xkarma31-blip/pig-health-monitor/v3-mqtt-pocketbase/firmware/esp32s3-mic-ambient/docs/wiring/esp32s3-devkitc1-pinout.jpg

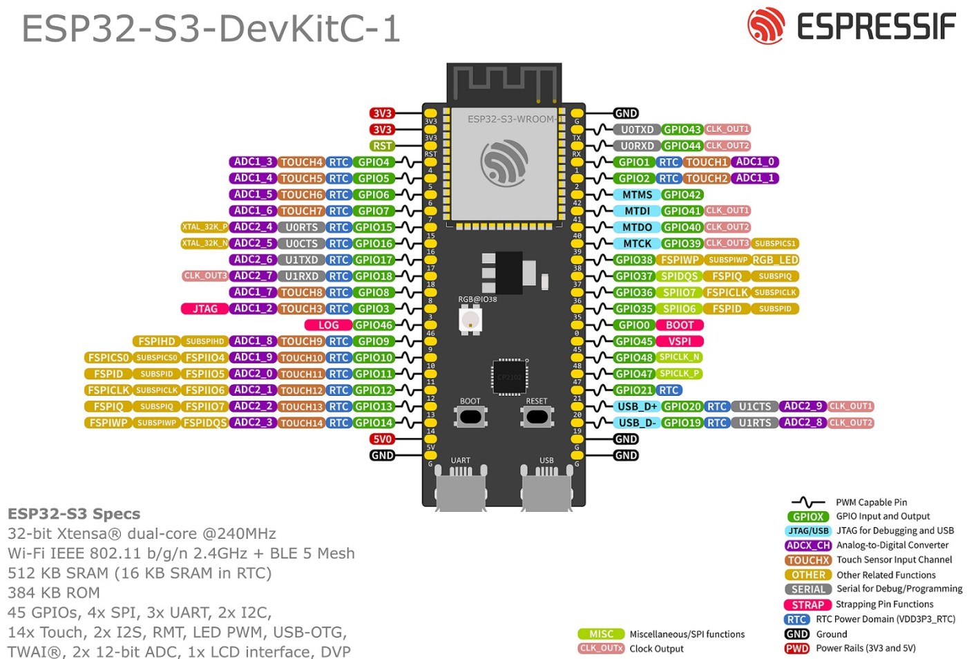
v3-mqtt-pocketbase/firmware/esp32s3-mic-ambient/docs/wiring/esp32s3-devkitc1-pinout.jpg
