xkarma31-blip/pig-health-monitor/v3-mqtt-pocketbase/frontend/landing_page/pigpulse_poster.png

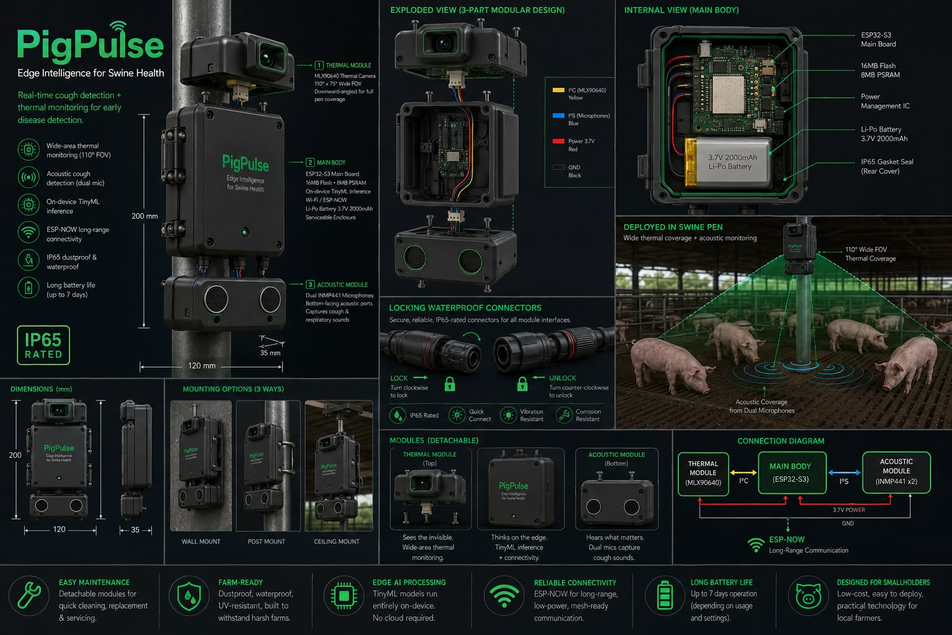
v3-mqtt-pocketbase/frontend/landing_page/pigpulse_poster.png
