xkarma31-blip/pig-health-monitor/v3-mqtt-pocketbase/enclosure/recovery-20261018/revision-o/LUG_DESIGN_DECISION.md

# External lug proposal — not adopted

Independent source-only proposal retained in functional-lug-review.txt.
It proposes152mm-wide main tub with four wall ears,but assumes a requested
wall-attachment requirement absent from the established enclosure brief.
It could not inspect the poster. It is not reference-grounding evidence.

Important constraint remains valid: spine extends5mm behind main tub and SHT
arm extends10mm behind; ears flush to tub/spine would not establish wall contact.
No flat-wall datum,anchor,tool,load or substrate requirement has been supplied.
Adding this geometry now would widen the silhouette without proving functional
mounting or original fidelity. Retain current spine/post strap concept and label
mounting capacity unverified. Do not call SHT support a wall bracket.

This rejects a speculative feature,not a discovered manufacturing defect.
