xkarma31-blip/pig-health-monitor/docs/track-t5-apps.md

# Track T5 — APPS (Home-first app revamp: honest labels, end-user / technician split)

**Track note file** (worker-owned; T0 folds it into `CANON.md`).
**Scope (rollout manifest):** `v3-mqtt-pocketbase/frontend/mobile_app/**`,
`v3-mqtt-pocketbase/backend/thermal-pi/static/**`.
**This change set (2026-11-03):** `frontend/mobile_app/src/**` only.
**Never touched:** firmware, `backend/**` (incl. `thermal-pi/static/`), `CANON.md`, landing page.

> **Status: 2026-11-03 — phase 1 (`9933f46`), phase 2 (`badc7a1`), refinement
> (`6cb7843`) committed; phase 3 (actual sources first + laptop layouts) verified,
> committing with this note.**
> Suites: **62/62** · tsc 0 · eslint 0 · critic_loop pass.
> Not deployed (Vercel login pending); read "Honest limits" before claiming anything
> works on a phone.

---

## 1. Direction reset — this note supersedes the 2026-10-29 T5 brief

The 2026-10-29 rollout brief asked for a **monitor-first** app ("Feeds/Monitor becomes the
primary tab", roster demoted to a hidden research sub-view, anonymous `P-####` IDs).
That direction was implemented as `fd5f5f1` and **reverted by Master in `d660e31`**.
The version of this file that described it was deleted by the revert; it is still
readable as history: `git show fd5f5f1:docs/track-t5-apps.md` (306 lines, superseded).

**Standing direction (what this change set implements):**

| 2026-10-29 brief (superseded) | Standing direction (this change set) |
|---|---|
| Feeds/Monitor becomes the primary tab | **Home stays primary.** No tab restructure. |
| Roster demoted to a hidden research sub-view; anonymous `P-####` | **Roster stays a normal tab** with real pig names; copy says the barn mic monitors the whole pen. |
| Navy/cyan extends over the app | Navy/cyan `#1A1A2E` is the **Pi console** palette, not the app's. App keeps neutral canvas + green accent (`#1E8449` light / `#3DDC84` dark). |
| (implied) monitor surfaces everywhere | **End users must not get admin-like monitoring surfaces.** Technician surfaces (web island: CCTV / thermal diagnostics / serial-only info) are **admin-gated**. |
| — | Consistency + honesty pass: naming restored (saved farm/pen names, PB `devices.name`), simulations labeled as simulations. |

---

## 2. What changed — 9 modified + 1 deleted (all under `mobile_app/src`)

| File | Change |
|---|---|
| `src/components/AuthGuard.tsx` | New `requireAdmin` prop: `allowed = Boolean(user) && (!requireAdmin \|\| Boolean(user?.admin))`. Gate copy: "Admins only" + "This dashboard is for the technician account…" (was "🔒 Authentication Required"). Re-themed via `useTheme()` — dropped the hardcoded navy `#1A1A2E`. Blocked state has **no dead ends**: "← Back to app" always, plus "Admin sign-in" (signed out) / "Sign out & switch account" (signed in, non-admin). |
| `src/app/web/_layout.tsx` | `<AuthGuard>` → `<AuthGuard requireAdmin>` — **the technician island no longer opens for ordinary signed-in users.** |
| `src/app/tabs/index.tsx` (Home) | Farm name from `loadFarmerSetup()` (re-read on focus) instead of hardcoded "Sundown Farm". Device rows labelled via `subscribeDeviceNames` (PB `devices.name` keyed by `deviceId`). Thermal card: "Live thermal feed" → **"Thermal view"** + "Simulated preview of the thermal camera" + always-**"Demo"** badge. Pen label falls back to the saved pen name. |
| `src/app/tabs/roster.tsx` | Demo pill when `!user \|\| user.admin \|\| !liveHerd`. Enroll copy: "Adds this pig to the roster. The barn mic (s3-mic-01) monitors the whole pen…" (no INMP441 near-pig-capture claim). Toast "added to the roster". `enrolled` date reads `record.created` (the real schema field). |
| `src/app/tabs/events.tsx` | Demo pill when `!user \|\| user.admin \|\| !liveEvents`. |
| `src/app/tabs/settings.tsx` | Demo pill when `!user \|\| user.admin \|\| !liveNodes`. Demo nodes relabelled "Thermal node (MLX90640)" / "Barn mic (ESP32-S3)". `mapSensor` shows the PB `label` as-is (no inferred "INMP441/MLX90640" suffixes). Login CTA copy: "Switch from demo data to live events, roster, and sensor readings". |
| `src/app/thermal.tsx` | Removed the dead "Open live Pi dashboard" button (self-signed-cert technician path). Header **"Thermal view"** / "Preview of the thermal camera grid"; keeps the **DEMO SIMULATION** badge. |
| `src/components/ThermalLiveView.tsx` | HUD is now conditional: real frame → sensor HUD; **no frame → "SIMULATED PREVIEW \| RES: 32x24" + "NO SENSOR STREAM — DEMO FRAME"** (was sensor HUD text unconditionally). |
| `src/utils/pocketbase-data.ts` | `enrollPig` writes schema-fitting fields (`pigId`, `name`, `healthStatus`, `tags`; dropped `enrolledAt`). New `subscribeDeviceNames` — `deviceId → devices.name` (refresh is best-effort — see §6.6). |
| `src/components/primitives/TemperatureDisplay.tsx` | **Deleted** — dead component; it carried **all 61 of HEAD's tsc errors** (see §4). |

---

## 3. The split, precisely (who sees what)

**End-user surfaces:** tabs (Home / Events / Roster / Settings), `/thermal`, `/login`.

**Technician surface:** the `/web/**` island (dashboard, nodes, logs…).

- The gate is `user.admin === true`, which only happens when the **PocketBase admin
  endpoint** answered the login (`utils/pocketbase-auth.ts`, login-page role toggle).
  A normal `users` record can never set it — verified in the session matrix (§4).
- **Demo marking matrix** (demo data shown in exactly these states):
  - roster pill: `!user || user.admin || !liveHerd`
  - events pill: `!user || user.admin || !liveEvents`
  - settings pill: `!user || user.admin || !liveNodes`
  - Home: no pill; stale public telemetry is labeled "Stored readings · waiting for
    fresh sensor data" / "Stored data" (pre-existing design), and the thermal card
    always carries the "Demo" badge because the thermal view is always a simulation.

**Before → after evidence (same routes, chromium, real PocketBase):**

| Surface | Before (HEAD `fefeb33` app) | After |
|---|---|---|
| `/web/dashboard` as normal user | Island **rendered** — "Welcome back, demo.farmer! … Herd Health Overview … Add Pig" | **"Admins only"** — island hidden |
| `/web/dashboard` signed out | "🔒 Authentication Required …" | "Admins only" |
| `/web/dashboard` as PB admin | Island rendered | Island rendered (unchanged) |
| Home thermal card | "Live thermal feed" + "Live" badge | **"Thermal view"** + "Demo" badge + "Simulated preview…" |
| Home device rows | raw IDs (`esp32-002`, `s3-mic-01`) | PB names ("Node esp32-001", "Device s3-mic-01", "PigPulse Pi 4B (MLX90640)") |
| Home header | hardcoded "Sundown Farm · …" | saved farm name, or neutral "Connecting to PocketBase…" |

---

## 4. Verification performed (measured 2026-11-03)

| Gate | Result |
|---|---|
| `npx tsc --noEmit` | **0 errors.** HEAD baseline measured in a detached worktree: **61 errors — all 61 in the deleted `TemperatureDisplay.tsx`**. |
| `npx eslint` on the 9 changed files | **0 errors**; 11 warnings, all pre-existing patterns (identical counts at HEAD). |
| `critic_loop.sh` (Article VIII layer 1) | **9/9 PASS.** |
| `npx expo export -p web` | Success (after build and before build both exported). |
| DOM-text assertions (chromium harness) | **41/41** — signed-out 20/20, end-user 15/15, admin 6/6 (incl. the 2 back-affordance checks added after review feedback); 0 page errors, 0 HTTP ≥ 400. |
| Stash round-trip safety | Before-build export taken via `git stash push -- …/mobile_app/src` → export → `git stash pop`; working tree **STATUS MATCHES + TREE MATCHES** byte-for-byte (92 files). Branch HEAD has since advanced (`905a61e`…`64544c0`, thermal-pi + docs only); `mobile_app` is untouched between `fefeb33` and HEAD (verified). |
| Evidence bundle | `~/sandbox/app-revamp-20261103/` — `before/` 22 files, `after/` 32 files (PNGs + DOM text dumps), `compare/` 6 labeled before/after side-by-side PNGs (the Telegram approval pack), `src-after.patch` + full byte-identical `src-backup-20261103-074424/`, harness (`spa_server.py`, `verify_dom.js`, `capture.js`, `probe_before.js`). |

**Harness notes (durable, avoid re-learning):**

- `spa_server.py` serves the Expo web export under `/app` (same baseUrl as production)
  and proxies `/api/*` to PocketBase on `:8090`, including an emulation of the Vercel
  read-only bridge (`api/telemetry.js`) so signed-out/stored-data paths behave like prod.
- A viewport-resize race made early verification runs **falsely fail**: crossing the
  mobile/desktop breakpoint unmounts device rows for ~300 ms–1 s. `dump()` now waits
  for the text to settle (two identical reads); screenshots settle 1600 ms. This was a
  harness bug, not an app bug.
- The `user` session needs a PocketBase *user* account. A temporary one
  (`demo.farmer@pigpulse.local`) was created for the run and **deleted afterwards** —
  users collection is back to 0 items, so re-running that session means recreating it.
- **Review-feedback round (2026-11-03):** back affordances added to the blocked screens
  ("← Back to app" + "Admin sign-in" / "Sign out & switch account"); full re-run after the
  change: tsc 0, eslint 0, re-export, **41/41**, screenshots refreshed.
- Review layers: layer 1 (critic_loop) ran. Layer 2 (CodeRabbit `cr`) could **not**
  run — the CLI is installed but not signed in (`coderabbit auth login` is an
  interactive step). A read-only reviewer-agent pass over the diff ran instead:
  3 MED + 1 LOW, **all pre-existing** — provenance confirmed against `git diff HEAD`
  (none of the flagged lines were touched by this change set); folded into §5/§6.
  The same pass confirmed `enrollPig` matches the migrated `pigs` schema, the gate is
  correct for signed-out/user/admin, `subscribeDeviceNames` keys match telemetry
  keying, and there are no dangling references to the deleted component.

---

## 5. Honest limits (do not oversell)

- **Committed — and revert-verified.** Approved by Master 2026-11-03; committed on
  `feat/v3-mqtt-pocketbase` (hash in `git log`). Revert = `git revert <hash>` (verified
  clean in a scratch worktree) or restore from the evidence bundle (patch + byte-identical
  `src` backup). **Not pushed.**
- No deployment, no APK, no physical-phone run — verification was the web export in
  headless chromium against the local PocketBase.
- DOM assertions check rendered text, not pixels; the PNGs in the evidence bundle are
  the visual record.
- PocketBase telemetry is stale (newest frame 2026-09-27). The "live" surfaces were
  exercised against stored frames; the app labels this honestly ("Stored readings").
- The thermal view remains **always the simulated preview** — no live frame path from
  the Pi is wired to the app today. It is now labeled as a simulation in all three
  places (Home card badge, `/thermal` header, HUD).
- The Pi was unreachable (unplugged) this session — nothing here is Pi-side verified.
- **The admin gate is UI separation, not a security boundary.** `user.admin` is
  rehydrated from localStorage/AsyncStorage and is client-forgeable (only a token
  string is checked — `pocketbase-auth.ts`), and the collections the island reads are
  anon-readable (PB list rules open — spot-checked 200 without auth). Before this
  change the island opened to *any* signed-in user, so the gate is a strict
  improvement, but it must not be described as access control.
- Pre-existing working-tree changes outside this change set were left untouched
  (`docs/REPORT_*.md`, `backend/thermal-pi/static/index.html`,
  `backend/thermal-pi/web_server.py`, untracked docs/tools); the stash round-trip
  proved they were unaffected.

---

## 6. Follow-ups (found during the pass — deliberately NOT fixed here)

1. **`lastSeen` unit mismatch — live settings shows wrong node states.** ESP32 rows
   carry epoch **seconds**, the Pi carries **ms**, `s3-mic-01` carries `0`; the
   devices→sensor mapping (`toLiveSensor`) and `mapSensor` parse as ms, so captured
   live settings rendered esp32-001/002 and the Pi as **"Offline"** and `s3-mic-01`
   as **"Active"** (falsy `0` falls back to "now"). Fix needs per-value normalization
   (`telemetryTime`-style) in `pocketbase-data.ts` / `usePocketbaseRealtime.ts`.
2. **Events timestamps are mixed-unit.** The six seeded demo alerts carry **seconds**
   (`backend/setup/seed_pocketbase.py:134`), the live bridge writes **ms**
   (`local_bridge.py:279`), and `formatTimestamp` treats raw numbers as ms → the
   seeded alerts render "Jan 22" (**1970**, year hidden) instead of Sep 2 — visible
   in `after/v-12-events-user.txt`. One shared normalizer fixes both units.
3. **`batteryPct` / `rssi` / `firmware` unmapped.** Devices rows carry `batteryPct`
   (78/77) but `toLiveSensor` drops it; settings renders battery "—", signal "—",
   version "unknown" for every live node.
4. **`toLiveSensor` defaults non-mic device types to `'thermal'`** — a Pi node will be
   typed as thermal regardless.
5. **`subscribeSensors` ripple.** Two other consumers exist
   (`AdvisorModal.tsx:72`, `useOfflineTelemetry.ts:42`) — revisit together with #1/#3.
6. **Device-name refresh is best-effort (LOW).** Native polls only newly *created*
   records; deployed web depends on the SSE path through the hosting proxy — a rename
   may need a reload. Cosmetic; mirrors the roster/alerts subscriptions.
7. **`src/app/web/nodes.tsx:17` still says "INMP441"** — inside the now-admin-gated
   island (technician-facing), so lower priority; decide whether to correct the label.
8. **Signed-out Home shows stored public bridge telemetry** ("Stored data"). Pre-existing
   design; decide whether end users should see stored readings at all before sign-in.
9. **Push notifications and widgets** — future track, explicitly not in this change set.
10. **Web island numbers are hardcoded mock** — `app/web/dashboard.tsx` builds its pigs
    with `generateMockData()` (Bessie/Daisy/Coco/Lucy, invented temps). The island is a
    legacy technician review surface. Decide: keep it as a clearly-labeled review surface
    or wire real PB data. (Review feedback 2026-11-03.)
11. **Live thermal wiring — ADDRESSED in phase 2** (see the phase-2 track note at the
    bottom): the app now reads `/data` + `/ambient` + `/esp/status` (console tier) and
    falls back to PocketBase `pi-thermal-01` stats. Remaining caveat: native devices may
    reject the console's self-signed certificate, so the phone-on-WiFi path can be
    stats-only until that is solved (Pi HTTP endpoint, cert pinning, or MQTT-over-WS).
12. **Data attribution model (Master's direction, 2026-11-03).** Unsigned sessions may show
    live data but unattributed ("temporary"); signing in should record/classify data to a
    farm/pen. Not implemented today — sign-in is currently view-only.
13. **The island itself has no "back to app" link** (admins navigate via the island's own
    bottom nav). Add one when the island is next touched.

---

## 7. Reproduce

```bash
cd v3-mqtt-pocketbase/frontend/mobile_app

npx tsc --noEmit          # expect 0
npx eslint src/app/tabs/{events,index,roster,settings}.tsx src/app/thermal.tsx \
  src/app/web/_layout.tsx src/components/{AuthGuard,ThermalLiveView}.tsx \
  src/utils/pocketbase-data.ts                      # expect 0 errors

npx expo export -p web --output-dir /tmp/opencode/dist

# serve + verify (harness copies: ~/sandbox/app-revamp-20261103/)
python3 spa_server.py /tmp/opencode/dist 9301      # /api -> PB :8090
node verify_dom.js http://127.0.0.1:9301 /tmp/out signedout
CAP_EMAIL='<temp pb user>' CAP_PASS='<pw>' node verify_dom.js http://127.0.0.1:9301 /tmp/out user
CAP_EMAIL='<pb admin>'     CAP_PASS='<pw>' node verify_dom.js http://127.0.0.1:9301 /tmp/out admin

# before-build comparison (HEAD app state):
git stash push -m before-build -- v3-mqtt-pocketbase/frontend/mobile_app/src
npx expo export -p web --output-dir /tmp/opencode/dist-before
git stash pop
```

Local dev credentials come from `/etc/pigpulse/bridge.env` (never a default).

---

## 8. Canon deltas for T0

- **T5 direction reset (supersedes the 2026-10-29 T5 brief):** Home stays primary;
  app accent stays green; end-user vs technician split — the `/web/**` island is
  gated `requireAdmin` (`user.admin === true` = PB admin login only).
- "Roster deleted / anonymous `P-####`" is **not** the direction; roster stays as a
  normal tab with whole-pen copy, demo-pill logic as in §3.
- The thermal view is **always simulated today** and is now labeled as such in all
  three surfaces (Home card, `/thermal`, HUD).
- `enrollPig` writes schema-conforming `pigs` fields (`pigId`, `name`,
  `healthStatus`, `tags`).
- Home device rows are named from PB `devices.name` keyed by `deviceId`
  (`subscribeDeviceNames`).
- New open items (see §6): `lastSeen` unit mismatch + `s3-mic-01` `lastSeen: 0` falsy →
  wrong node states; events timestamps are mixed-unit (seed **seconds** / bridge **ms**)
  → seeded alerts display 1970 dates until normalized.
- The `requireAdmin` gate is UI separation, not access control (client-side flag;
  collections are anon-readable).
- Live-path facts (2026-11-03): the Pi is reachable at `192.168.69.1` and streams real
  data (PB `:8090`, thermal console `:8080`, MQTT `:1883`, broker WS `:9001`, mic TCP
  `:9090`); the app now wires it in the phase-2 change set (console tier + PB stats
  fallback) — native self-signed-cert caveat remains. The web island's numbers are
  hardcoded mock (§6.10).
- Blocked technician screens must never dead-end: "← Back to app" + sign-in /
  switch-account affordances are part of the gate (AuthGuard).
- Status: **committed** 2026-11-03 (`feat/v3-mqtt-pocketbase`); revert = `git revert <hash>`; not pushed.

---

## Track note 2026-11-03 (phase 2) — live barn thermal, at console quality, in the app theme

> Status: implemented + verified, **UNCOMMITTED** (approval pending). Branch
> `feat/v3-mqtt-pocketbase`, parent commit `9933f46`.

### 1. What changed (6 files: 3 new + 3 edited)

| File | Change |
|---|---|
| `src/utils/pi-thermal.ts` | **New.** Pi console client: types for `/data` (768-pixel frame + stats), `/ambient` (SHT45), `/esp/status` (mic); base resolution = `EXPO_PUBLIC_PI_THERMAL_URL` → saved PB host `https://<host>:8080` → null. |
| `src/utils/thermal-palette.ts` | **New.** Iron colormap — the console's stop set, byte-for-byte — shared by the renderer and legend. |
| `src/hooks/usePiThermal.ts` | **New.** Two-tier data: console endpoints (2 s frame poll / 6 s slow poll, 8 s freshness window) + PocketBase `pi-thermal-01` stats (90 s window — works wherever the app's PB channel works). |
| `src/components/ThermalLiveView.tsx` | New `liveFrame` prop: iron-palette render (web smooth canvas — the console's "Smooth" default; native Svg pixel grid), HOT/COLD crosshair markers at the console's coordinates, live HUD; simulation overlays suppressed in live mode; demo path unchanged. |
| `src/app/thermal.tsx` | Rebuilt around three honest states: **LIVE** (console) / **LIVE STATS** (PB only, frames marked unavailable) / **DEMO SIMULATION**. Quality display: legend bar, stat cards (Center + verdict chip, Min, Max, Avg, MLX ambient), SHT45 barn-ambient card, barn-mic card — all in app theme tokens. |
| `src/app/tabs/index.tsx` | Home thermal card: when `pi-thermal-01` rows are fresh (<90 s) it shows "Live" + `pi-thermal-01 · NN.N°C · live`; otherwise the labeled demo stands. |

### 2. Verification (measured 2026-11-03, Pi live throughout)

| Gate | Result |
|---|---|
| tsc / eslint (changed files) / critic_loop | 0 / 0 errors / **6 PASS** |
| expo web export | OK (regression build + live build) |
| Regression suite (`:9301`, laptop PB, no live env) | **41/41** — demo labeling intact |
| Live suite (`:9303`, live build via `/pi` proxy → real Pi) | **9/9** — LIVE badge, pi-thermal-01, stat labels, HOT/COLD markers, SHT45 card, mic card, plausible temps, no demo label |
| Home suite (`:9304`, PB → Pi) | **3/3** — live subtitle, real Pi device row, not demo |
| Evidence | `~/sandbox/app-revamp-20261103/thermal-live/` (app + home screenshots, dumps); `compare-live/console-vs-app.jpg` (sent to Master's Telegram) |

Sample live read (frame 10364): center 36.91 °C OUT_OF_BAND · min 30.89 (x=30,y=10) ·
max 40.46 (x=12,y=17) · avg 35.53 · MLX ambient 48.88 · SHT45 35.52 °C / 72.5 % RH ·
mic socket open, no data (stale).

### 3. Honest limits (phase 2)

- **Native + self-signed cert:** a phone may not fetch `https://<pi>:8080` directly
  (Android/iOS reject the self-signed cert). The app then shows the **LIVE STATS** tier
  (PocketBase) — real numbers, frames marked unavailable — never a fake live image.
  Fixes to consider: Pi HTTP listener, certificate pinning, or MQTT-over-WS `:9001`.
- Browser fetch of the console also needs the cert accepted; the harness verified the
  full path through a same-origin `/pi` proxy (`spa_server.py`, `PI_TARGET` env).
- The live build bakes `EXPO_PUBLIC_PI_THERMAL_URL`; the regression build does not —
  two dists, no runtime toggle yet (and Metro needs `--clear` when that env changes).
- `/feed` still uses its legacy `thermalFrame`/`esp32-s3-01` path; untouched.

### 4. Canon deltas (phase 2)

- The app now consumes the Pi console contract: `GET /data` (pixels[768] + stats),
  `GET /ambient` (SHT45 temp/humidity/state/age), `GET /esp/status` (mic socket).
- Console base resolution: env override → farmer-saved PB host → none.
- Iron palette stop set mirrored in `src/utils/thermal-palette.ts` — keep in sync with
  the console if the console palette changes.

### 5. Refinement (2026-11-03, same day — after Master's deep-link test)
- **Bug found by Master:** "Back" on `/thermal` did nothing when the screen was opened
  directly (shared URL / fresh tab). Root cause: `router.back()` is a no-op without
  history. Fix: `utils/navigation.ts` → `goBackOrHome()` (back when history exists,
  else `replace('/tabs')`), applied to all **six** `router.back()` sites (`thermal`,
  `feed` ×2, `login`, `tabs/feed`, `tabs/edge-impulse`).
- **Click-level tests added:** `verify_dom.js` session `nav` clicks the real buttons
  and asserts the resulting URL (thermal Back → `/tabs`; "Back to app" → `/tabs`;
  "Admin sign-in" → `/login`). Render-only checks had missed this class of bug.
- **Metro cache gotcha (both directions):** rebuilding a dist after toggling
  `EXPO_PUBLIC_PI_THERMAL_URL` **requires `--clear`** — the transform cache does not
  key on that env var (bit us twice: the live build missed the URL once; the plain
  build later inherited it).
- Removed a dead no-op effect in `tabs/edge-impulse.tsx` (unused `onChange`) — its
  pre-existing lint error surfaced once the file was touched.
- **Battery UI deferred (Master, 2026-11-03):** no battery hardware is fitted — the Pi
  and the ESP32-S3 are port-powered, so node cards now show **Power: Plugged** (was
  "Battery: NN%"). The battery formatting is kept in `settings.tsx` for when hardware ships.
- **Node naming aligned with the real roles:** hardware labels are now
  `Pi 4B — thermal · CCTV · compute` and `ESP32-S3 — mic · ambient` (the old
  "Node A / Node B" labels are gone from the app UI).
- **Live console URL is now baked RELATIVE (`/pi`)** so one dist works everywhere: the
  laptop harness and a phone on the LAN each resolve `/pi` against the origin they
  loaded the app from (`spa_server.py` proxies `/pi` → the Pi console).
- Re-verified after the refinement: **59/59** — 44 regression (incl. 3 new settings
  checks for Power: Plugged + node roles) + 3 nav + 9 live + 3 home.
- A **temporary Vercel deployment** of the plain web build was created for online
  viewing (demo states only — the cloud cannot reach the Pi or the laptop PocketBase;
  a permanent domain deploy needs a `vercel login`).

---

## Track note 2026-11-03 (phase 3) — actual sources first + laptop layouts

> Committed alongside this note; parent: `6cb7843`.

- **Actual data first, everywhere.** Roster / Events / Settings now subscribe to
  PocketBase in EVERY state (reads are anon-open); the local demo constants are only a
  fallback when PB has none — and only then does the DEMO pill show. Admin included
  (the old "admin → mock" branches are gone).
- **Web island dashboard is real:** `generateMockData()` (Bessie/Daisy/Coco/Lucy)
  deleted. The island reads `pigs` + latest `telemetry` from PB: real counts, statuses,
  breed/age from `tags`, real herd average — per-pig temps show "—" because monitoring
  is whole-pen.
- **Events timestamps fixed:** seeds write epoch seconds, the bridge writes ms;
  `formatTimestamp` normalizes via `telemetryTime` (seeded alerts no longer show
  "Jan 22, 1970").
- **PB device names aligned with the real roles** (both laptop + Pi PocketBases):
  `s3-mic-01 → "ESP32-S3 — mic · ambient"`; `pi-thermal-01 → "Pi 4B — thermal · CCTV ·
  compute"` — visible in every device list.
- **Laptop layouts:** thermal view is two-column at desktop widths (canvas left,
  readings right; demo mode centers instead of leaving an empty half). The sidebar +
  grid shell was verified against the previously deployed app at 1440×900 — it matches
  (its `/app/thermal` route is a 404, ours is live).
- Verified: **62/62** suites (24 regression + 16 user + 7 admin + 3 nav + 9 live +
  3 home); desktop screenshots in `~/sandbox/app-revamp-20261103/refinement-shots/`
  (`desktop-live/`, `desktop-regression/`).
- **Deployed to production (2026-11-03):** combined site at
  `https://pig-health-monitor.vercel.app/app` — added SPA fallback rewrites for the
  app's non-tab routes (`/app/thermal`, `/app/login`, `/app/setup`, `/app/feed`,
  `/app/web*`) which were live 404s; deploy scripts now run Vercel from the staging
  dir (the repo-root `vercel.json` carries a `//` note newer schemas reject).
  Autodeploy had been failing since Oct 31 (stale token) — the fresh login restores
  it once the next upstream commit lands.
- Deployed-web nuance: the domain's `/api` only bridges telemetry — device-name
  lookups (`/api/collections/devices`) 404 there, so deployed rows show raw device
  ids until the bridge covers names (follow-up).
- **Deployed LIVE thermal (2026-11-03, evening):** the ONLINE app now streams REAL
  Pi frames — `api/pi.js` (single-path bridge `/api/pi?ep=data|ambient|esp/status`)
  → Tailscale Funnel → laptop `readonly_pb_proxy` (new key-gated `/pi` passthrough,
  endpoint allowlist, unverified TLS to the console) → Pi console. The proxy's
  filter regex also now accepts quoted values (`deviceId='x'`), which had silently
  400'd the deployed stats tier. Production-verified: LIVE badge, HOT/COLD markers,
  SHT45 36.96 °C / 72.5 %, mic socket state — no demo label. Local regression stays
  24/24 (bridge absent → graceful demo fallback).

---

## Track note 2026-11-03 (phase 4) — the Live tab + honest offline states

> Committed alongside this note; parent: `27a4a4a`.

- **Roster tab → Live tab.** Navs (bottom + sidebar) are now Home · Events · **Live** ·
  Settings. The Live tab hosts the shared `LiveThermalPanel` (also used by `/thermal`)
  plus quick links: **Roster →** (kept routable at `/tabs/roster`, no longer a tab,
  with "Back to Live") and **Full screen →** (`/thermal`). A STREAMS note states that
  CCTV isn't wired into the app yet.
- **Honest offline states — the fake heatmap is gone from the app's live surfaces.**
  Four states: **LIVE** (console frames) · **LIVE STATS** (fresh PB) · **LAST KNOWN**
  (stale PB, age-stamped) · **OFFLINE** (no imagery at all; guidance + auto-retry).
  Home's thermal card mirrors this (Live / Stale / Offline badge).
- **Pi-localhost findings (grounded 2026-11-03):** the Pi console is live and directly
  reachable on the barn network (`/`, `/health`, `/data`, `/ambient`, `/esp/status` —
  all 200; a browser on that origin works once the cert is accepted; a cross-origin
  browser fetch is CORS-blocked — verified). Hence the proxy (local harness) and the
  serverless bridge (deployed) are required for non-same-origin hosting. The Pi does
  **not** host the app (`/app` → 404) and SSH was denied with available credentials —
  hosting the app on the Pi (same-origin: no CORS, cert accepted once) is scoped as
  a next step.
- Verified: **69/69** (26 signed-out + 16 user + 7 admin + 5 nav + 12 live + 3 home).
  Deployed: all routes 200 incl. `/app/tabs/live`.

---

## Track note 2026-11-03 (phase 5) — CCTV in the app (separate tile) + per-source sound

> Implemented; parent: `01d464e`.

- **CCTV is real in the app now — as its OWN tile** (no overlay; per Master: "keep both
  separate"). Chain: app → `api/pi?ep=cctv` (deployed) / `/pi/cctv` (local harness) →
  read-only proxy (new `_cctv_frame`: bounded read of the Pi's MJPEG plane, returns the
  freshest complete JPEG; the app polls ≈2.5 s) → Tailscale Funnel → laptop → Pi
  `/cctv`. The tile shows "Live snapshot — updated Ns ago" or an honest offline state.
- **Correction — the Pi's fusion page was never broken.** `/static/fusion.html` returns
  200 and renders a working heat-over-camera overlay **with an alignment panel**
  (opacity / fit / rotation sliders). The earlier "404" note tested the wrong path
  (`/fusion.html`). App-side overlay stays deferred by Master's call; the Pi page
  already demonstrates the approach.
- **Sound controls — the sources are different and kept separate.** SOUND card with
  `Barn mic (ESP32-S3)`: a Listen/Mute toggle playing 3-second WAV chunks from the
  Pi's `/esp/record` (web playback; native lands with the APK pass). While the mic
  stream is stale the Pi returns an honest `503 "ESP mic not connected"` — the toggle
  renders disabled with that reason (verified live). `Camera sound (Tapo)`: a separate
  track, labeled not-wired-yet (needs a barn-side transcoder).
- Proxy allowlists extended: `cctv` (binary JPEG) and `esp/record` (bounded WAV,
  upstream status forwarded). The serverless bridge passes both with correct types.
- Verified: local chain `/pi/cctv` → 200 image/jpeg; `/pi/esp/record` → honest 503;
  suite battery **72/72** (26 + 16 + 7 + 5 + **15** live incl. the new Live-tab checks
  + 3 home); deployed Live tab verified in-browser (CCTV frame rendered, sound card
  present, mic stale-state honest); deployed bridge `/api/pi?ep=cctv` → 200
  image/jpeg.
