xkarma31-blip/pig-health-monitor/docs/PROGRESS_UPDATE_20260913.md

# PigPulse — Weekly Progress Update
> **September 13, 2026** | End of **Gantt Week 7** (Sep 07–13) of 23

---

## 📊 **CURRENT WEEK STATUS**

**Week 7: September 07–13, 2026** | ISO Week 37

| Planned (Gantt Week 7) | Actual Status |
|---|---|
| R7 Ground-Truth Protocol | 🔄 **NOT STARTED** — no deliverable found |
| D2 Synthetic Augmentation | 🔄 **PARTIAL** — simulator v3.1 has env modeling, no standalone D2 module |
| R8 Risk Register (living doc) | 🔄 **ONGOING** — no formal register updated this period |
| D1 Dataset Acquisition | 🔄 **NOT EVIDENT** — no dataset files in repo |
| F2 I2C Thermal Pipeline | ✅ **COMPLETE** — `sensors.cpp/h` with MLX90640 driver |
| F3 Multi-Modal Fusion Engine | ✅ **COMPLETE** — simulator + firmware sensor fusion |
| C2 Ch2 Literature Review | 🔄 **NOT EVIDENT** — no draft in `docs/` |
| C3 Ch3 Methodology | 🔄 **NOT EVIDENT** — no draft in `docs/` |
| A3 CPE Design Journal | 🔄 **NOT EVIDENT** |

**Week 7 Verdict: 🟡 MIXED** — Firmware & simulation far ahead; research deliverables missing.

---

## 🏆 **COMPLETED THIS PERIOD (Since Sep 6)**

### Firmware — `firmware/esp32d0wd-pigpulse/`

| Deliverable | Status | Evidence |
|---|---|---|
| **Complete sensor library** (MLX90640 + INMP441) | ✅ | `sensors.cpp` (20KB), `sensors.h` (4KB) |
| **Power management** (LiPo monitoring, sleep modes) | ✅ | `power.cpp` (3.5KB), `power.h` |
| **WiFi management** (AP/STA, reconnection) | ✅ | `wifi.cpp` (5.5KB), `wifi.h` |
| **Web interface** (config, OTA, status) | ✅ | `web.cpp` (10.6KB), `webpage.h` (19KB) |
| **Config system** (types, persistence) | ✅ | `config.h` (7.5KB), `types.h` |
| **Main firmware entry** | ✅ | `esp32d0wd-pigpulse.ino` (14KB) |
| **PlatformIO build system** | ✅ | `platformio.ini`, partitions, OTA-ready |
| **Test & pinout documentation** | ✅ | `TESTING_GUIDE_TELEGRAM.txt`, `TEST_PINOUT_TELEGRAM.txt` |

### Simulation — `v3-mqtt-pocketbase/` + `canon` branch

| Deliverable | Status | Evidence |
|---|---|---|
| **WebAudio bioacoustics synthesizer** (ADSR cough envelopes, formant model) | ✅ | Task 2 commit, TDD green |
| **32×24 thermal engine** (ear-ROI, base64 encoding) | ✅ | Task 3 commit |
| **Virtual D0WD state machine** (FreeRTOS TWDT, LiPo sag, brownout, beacon storm) | ✅ | Task 4 commit |
| **MQTT WebSocket service** (LWT/retain/reconnect, loopback broker) | ✅ | Task 5 commit |
| **Thermal heatmap canvas** (ironbow colormap, swine arena FOV) | ✅ | Task 6 commit |
| **Bioacoustics studio** (spectrogram waterfall, latency HUD) | ✅ | Task 7 commit |
| **Hardware monitor + chaos panel** (node coverage, RSSI, OTA dialog) | ✅ | Task 8 commit |
| **E2E ingestion contract** (topic routing, status mapping, payload schema) | ✅ | Task 9 commit |
| **Cockpit AI panels** (classifier readout, pipeline trace, scenario runner) | ✅ | Task 10 commit |
| **Grounded world model** (pig-001..004, open-air factors, entropy, contagion) | ✅ | Task 11 commit |
| **Scene editor + env console** | ✅ | Latest commits |
| **Backend inspector** (tri-state liveness vs deployment) | ✅ | Latest commits |
| **Spectral subtraction engine + A/B tests** | ✅ | Latest commits |
| **188/188 tests passing** | ✅ | TDD green throughout |

### Hardware Documentation — `docs/`

| Deliverable | Status | Evidence |
|---|---|---|
| **Breadboard pinout** | ✅ | `pigpulse-breadboard-pinout.png` (208KB) + `.svg` |
| **Pull-up resistor diagram** | ✅ | `pigpulse-pullup-resistors.png` (120KB) + `.svg` |
| **Thermal test pinout** | ✅ | `pigpulse-thermal-test-pinout.png` (77KB) + `.svg` |

### App / Cloud

| Deliverable | Status | Evidence |
|---|---|---|
| **v3 MQTT+PocketBase infra** | ✅ | Mosquitto + ValKey + OpenResty + PocketBase + Bridge |
| **Expo mobile app** (PocketBase-only, SDK 57) | ✅ | `mobile_app/` with collapsible sidebar, auth, real-time hooks |
| **Landing page** (3D GLB toggle, voice narration) | ✅ | Deployed to Vercel |
| **Daily cron monitoring** | ✅ | `scripts/monitor.py` → `REPORT_LATEST.md` |

---

## 🚨 **SLIPPAGE ALERTS**

### 🔴 **M2 — Instruments + Architecture Frozen (Due: Sep 07, 2026 — OVERDUE)**

**Risk:** HIGH — 6 days past deadline

**What's done:**
- ✅ Sensor selection locked (ESP32-S3, dual INMP441, MLX90640 110°)
- ✅ Firmware pipelines complete
- ✅ PCB breadboard pinout documented

**What's missing:**
- ❌ **Architecture Decision Record / System Architecture Document**
- ❌ **GO/NO-GO gate formalization**
- ❌ **Adviser sign-off**

**Impact:** Without formal freeze, downstream tasks (H3 PCB layout, F3 fusion, S1 schema) lack a locked reference.

---

### 🔴 **R5 — Research Design + Statistical Plan (Due: Sep 13 — TODAY)**

**Risk:** HIGH — due today, no deliverable found

No `R5_RESEARCH_DESIGN.md` or equivalent in `~/pig-health-monitor/docs/`. The 20260906 progress update claimed "R5 FINAL" at `docs/R5_RESEARCH_DESIGN.md` but the file is not in the current repo.

---

### 🔴 **R6 — Instrument Validation Plan (Due: Sep 13 — TODAY)**

**Risk:** HIGH — due today, no deliverable found

Same as R5 — referenced in prior update but not present in current file tree.

---

### 🟡 **D1 — Dataset Acquisition (Figshare 546 + Thai 49)**

**Risk:** MEDIUM

No dataset files found in `datasets/` or `training_data/`. The simulator generates synthetic data but the Gantt calls for real pig cough datasets. This is a research-critical dependency for M3 (Oct 05).

---

### 🟡 **C2 / C3 — Ch2 & Ch3 Manuscript**

**Risk:** MEDIUM

No chapter drafts visible in `docs/manuscript/`. The 20260906 update claimed "CHAPTER2_LITERATURE_REVIEW.md — DRAFT v0.1, 17 refs verified" but this is not in the current repo. Literature review progress (R2) is also undocumented.

---

## 📈 **OVERALL PROJECT STATUS**

| Category | Gantt Tasks | Actual Complete | In Progress | Ahead | Behind | Health |
|---|:-:|:-:|:-:|:-:|:-:|:-:|
| **Research Foundation** | 8 | 0 | 0 | 0 | 2 (R5, R6) | 🔴 |
| **Data & Model Pipeline** | 8 | 0 | 1 (D2 sim) | 1 | 1 (D1) | 🟡 |
| **Hardware** | 8 | 1 (H1) | 0 | 2 (H2, docs) | 0 | 🟢 |
| **Firmware** | 6 | 3 (F1, F2, F3) | 0 | 3 | 0 | 🟢 |
| **App / Cloud** | 5 | 2 (S1 infra) | 0 | 2 (S2 app) | 0 | 🟢 |
| **Verification** | 7 | 0 | 0 | 1 (sim V&V) | 0 | 🟡 |
| **Manuscript** | 14 | 0 | 0 | 0 | 2 (C2, C3) | 🔴 |
| **Course Aspects** | 4 | 0 | 0 | 0 | 1 (A3) | 🟡 |
| **TOTAL** | **58** | **6** | **1** | **9** | **6** | 🟡 |

**Summary:** 10% complete, 15% ahead, 10% behind. Research & manuscript tracks are critically behind; engineering tracks are significantly ahead.

---

## 🚀 **ADVANCEMENT OPPORTUNITIES**

The following are **ahead of schedule** and create parallelization opportunities:

1. **Firmware Platform (esp32d0wd-pigpulse)** — Complete sensor/power/wifi/web stack ready. Can immediately move to **PCB layout (H3)** and **field testing (V1)** without waiting for Gantt schedule.

2. **Simulation as Research Instrument** — The 188-test simulator with real DSP, thermal modeling, and MQTT contracts can serve as the **Instrument Validation Plan (R6)** if formalized. The spectral subtraction A/B tests already demonstrate sensor-as-instrument methodology.

3. **PocketBase + MQTT Infrastructure** — Live and deployed. The **Firebase Schema (S1)** task from Gantt is effectively superseded by PocketBase collections. Can start **Expo Router app (S2)** immediately.

4. **Breadboard Documentation** — Complete pinout and resistor diagrams exist. **H2 Breadboard Prototype** can be physically assembled this week.

---

## 🎯 **NEXT WEEK PRIORITIES (Week 8: Sep 14–20)**

| Priority | Task | Category | Action |
|---|---|---|---|
| **P0** | **M2 Architecture Freeze** | Milestone | Draft `ARCHITECTURE_FROZEN.md` with system block diagram, sensor list, firmware arch, cloud schema. Send to adviser. |
| **P0** | **R5 Research Design** | Research | Restore or recreate `R5_RESEARCH_DESIGN.md`. Statistical plan + experimental design. |
| **P0** | **R6 Instrument Validation** | Research | Formalize simulator A/B tests as instrument validation. Draft calibration SOP. |
| **P1** | **D1 Dataset Acquisition** | Data | Download Figshare 546 + Thai 49 pig cough datasets. Document licensing & splits. |
| **P1** | **C2 Ch2 Literature Review** | Manuscript | Restore `CHAPTER2_LITERATURE_REVIEW.md`. Execute remaining harvests to ≥60 refs. |
| **P2** | **C3 Ch3 Methodology** | Manuscript | Draft methodology chapter using simulator + firmware as instruments. |
| **P2** | **H2 Breadboard Prototype** | Hardware | Wire ESP32-S3 + INMP441 + MLX90640 on devkit using existing pinout docs. |
| **P3** | **A3 CPE Design Journal** | Course | Begin journal entries from R1-R5 artifacts. |

---

## 🏛️ **MILESTONE HEALTH**

| ID | Milestone | Due | Status | Health |
|----|---|-----|---|---|
| **M1** | Research Proposal Approved | Aug 10 | ✅ PASSED | 🟢 |
| **M2** | Instruments + Architecture Frozen | Sep 07 | ⚠️ **6 DAYS OVERDUE** | 🔴 |
| **M3** | Dataset Ready (n≥1500) | Oct 05 | ⏳ 22 days | 🔴 |
| **M4** | Models Trained | Oct 12 | ⏳ 29 days | 🟡 |
| **M5** | CH 1-3 LOCKED (adviser signed) | Oct 19 | ⏳ 36 days | 🟡 |
| **M6** | Pre-Oral Passed | Dec 07 | ⏳ 85 days | ⚪ |
| **G7** | GO/NO-GO GATE (Adviser Decision) | Dec 07 | ⏳ 85 days | ⚪ |
| **M8** | Prototype Field-Ready | Dec 21 | ⏳ 99 days | ⚪ |
| **M9** | Manuscript Complete (Ch1-5) | Jan 11 | ⏳ 119 days | ⚪ |
| **M10** | FINAL ORAL DEFENSE | Jan 18 | ⏳ 126 days | ⚪ |

---

## ⚠️ **CRITICAL RISK: RESEARCH VS ENGINEERING IMBALANCE**

The project is experiencing a **track divergence**:

- **Engineering tracks (Firmware, Hardware, App/Cloud):** 15% ahead, 9 extra tasks completed
- **Research tracks (R5, R6, C2, C3, D1):** 0% complete, 2 tasks overdue

**Root Cause:** The last 7 days focused heavily on simulation development (50+ commits on `canon` branch, 188 tests). While the simulator is technically impressive and serves as a research instrument, it does not directly produce Gantt-visible research deliverables.

**Recommendation:** Dedicate the next 7 days **exclusively** to research track catch-up:
- M2 freeze document (1 day)
- R5 + R6 research documents (2 days)
- D1 dataset download + documentation (1 day)
- C2/C3 manuscript drafting (3 days)

The engineering tracks can coast on their 2-week buffer.

---

## 📁 **FILES CREATED/MODIFIED SINCE SEP 6**

```
~/pig-health-monitor/
├── firmware/esp32d0wd-pigpulse/
│   ├── config.h (7.5KB) — NEW
│   ├── esp32d0wd-pigpulse.ino (14KB) — NEW
│   ├── sensors.cpp (20KB) / sensors.h (4KB) — NEW
│   ├── power.cpp (3.5KB) / power.h (694B) — NEW
│   ├── wifi.cpp (5.5KB) / wifi.h (1KB) — NEW
│   ├── web.cpp (10.6KB) / webpage.h (19KB) — NEW
│   ├── types.h (3.2KB) — NEW
│   ├── platformio.ini (1.5KB) — NEW
│   └── partitions_otaready.csv — NEW
├── docs/
│   ├── pigpulse-breadboard-pinout.png (208KB) + .svg — NEW
│   ├── pigpulse-pullup-resistors.png (120KB) + .svg — NEW
│   └── pigpulse-thermal-test-pinout.png (77KB) + .svg — NEW
├── v3-mqtt-pocketbase/ (canon branch — 50+ commits)
│   ├── Simulator v3.1 (188 tests, WebAudio, thermal, MQTT, etc.)
│   ├── Expo mobile app (PocketBase, SDK 57)
│   └── Landing page (3D GLB, Vercel deploy)
├── scripts/monitor.py — Daily cron monitoring
└── docs/REPORT_LATEST.md — Automated daily report
```

---

## 💡 **RECOMMENDATIONS**

1. **TODAY (Sep 13):** Draft `ARCHITECTURE_FROZEN.md` immediately. M2 is 6 days overdue.
2. **Tomorrow (Sep 14):** Download Figshare + Thai datasets. Create `D1_DATASET_MANIFEST.md`.
3. **This week:** Recover or recreate R5, R6, C2, C3 from any prior drafts. If they were in OneDrive/Archive, pull them forward.
4. **Stop new engineering work** until research track is back on track. The simulator buffer is deep enough to coast.
5. **Use simulator as R6 instrument validation** — the spectral subtraction A/B tests already demonstrate methodology. Formalize rather than rebuild.

---

*Generated: September 13, 2026 | Author: Sentinel (Rimuru) | Cron delivery via Telegram*
