xkarma31-blip/pig-health-monitor/docs/pig_health_monitor_roadmap.md

# 🗺️ Project Pig Health Monitor: The 6-Era Strategic Roadmap

> **Canonical Reference:** See `PIG_HEALTH_MONITOR_COMPLETE_RESEARCH.md` for full technical detail.

| **Era** | **Timeline** | **Objective** | **Key Deliverable** |
| :--- | :--- | :--- | :--- |
| **1. The Vague Spark** | Months 1–2 | Literature Review + Conceptual Framework | Concept Paper, Scope/Delimitations, BOM |
| **2. Breadboard Purgatory** | Months 3–4 | Hardware Assembly + First TinyML Test | Working I2S Mic + 85% accuracy on MFE |
| **3. The Barn Odyssey** | Months 5–6 | Field Data Collection (500+ samples) | "Golden Dataset" of real pig coughs |
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
