xkarma31-blip/pig-health-monitor/docs/pigpulse-breadboard-pinout.png

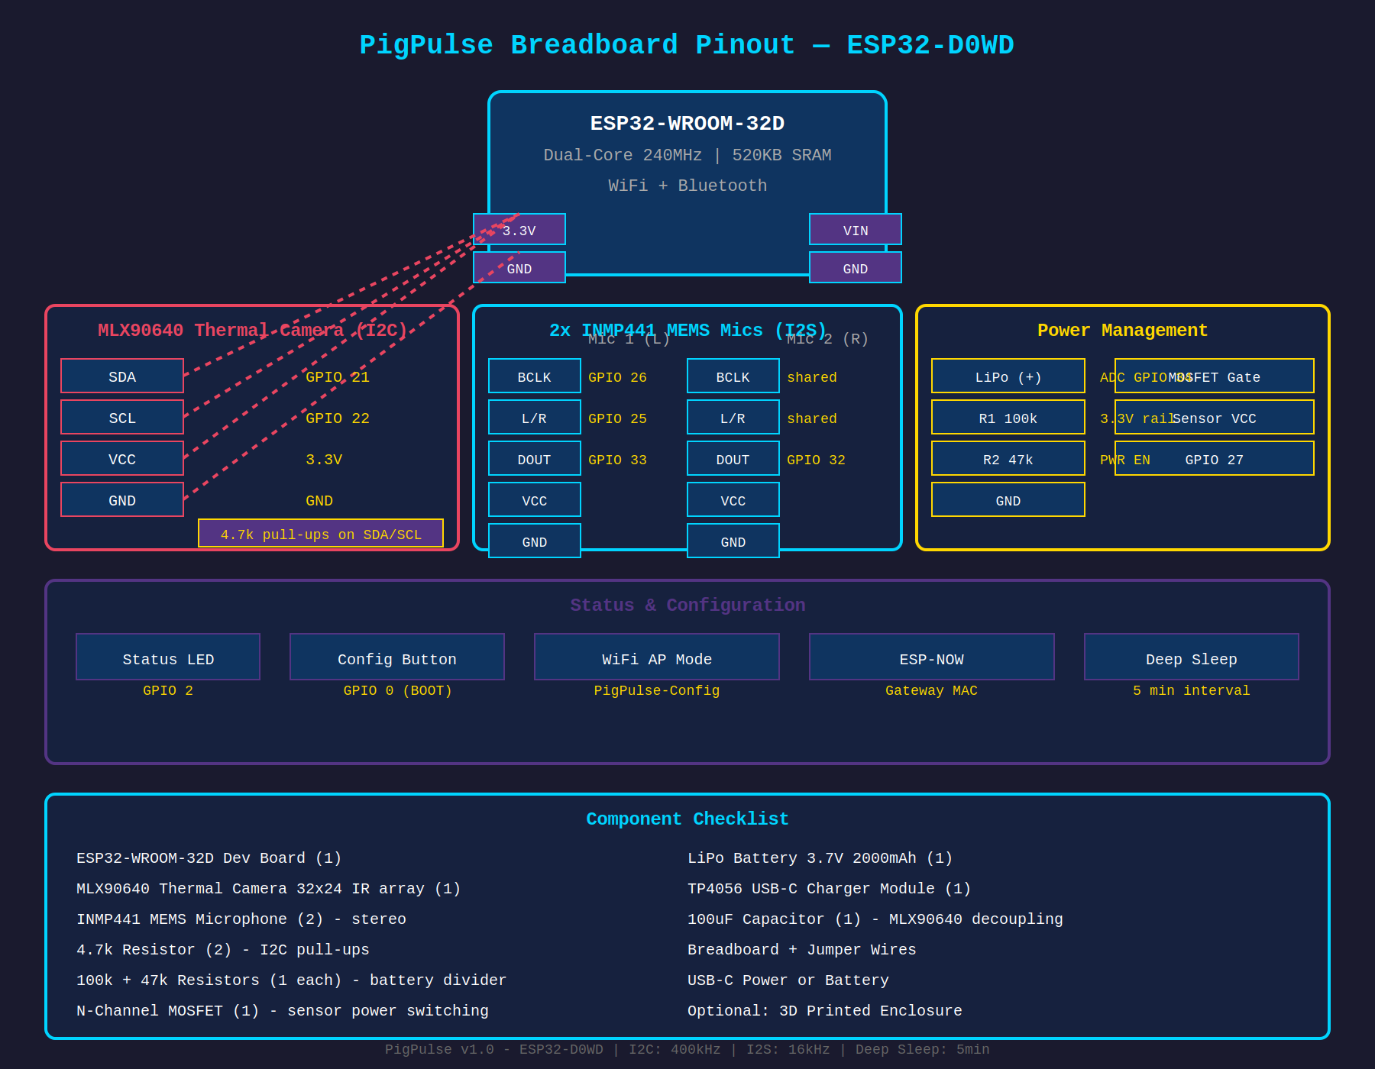
docs/pigpulse-breadboard-pinout.png
