xkarma31-blip/pig-health-monitor/docs/pigpulse-pullup-resistors.png

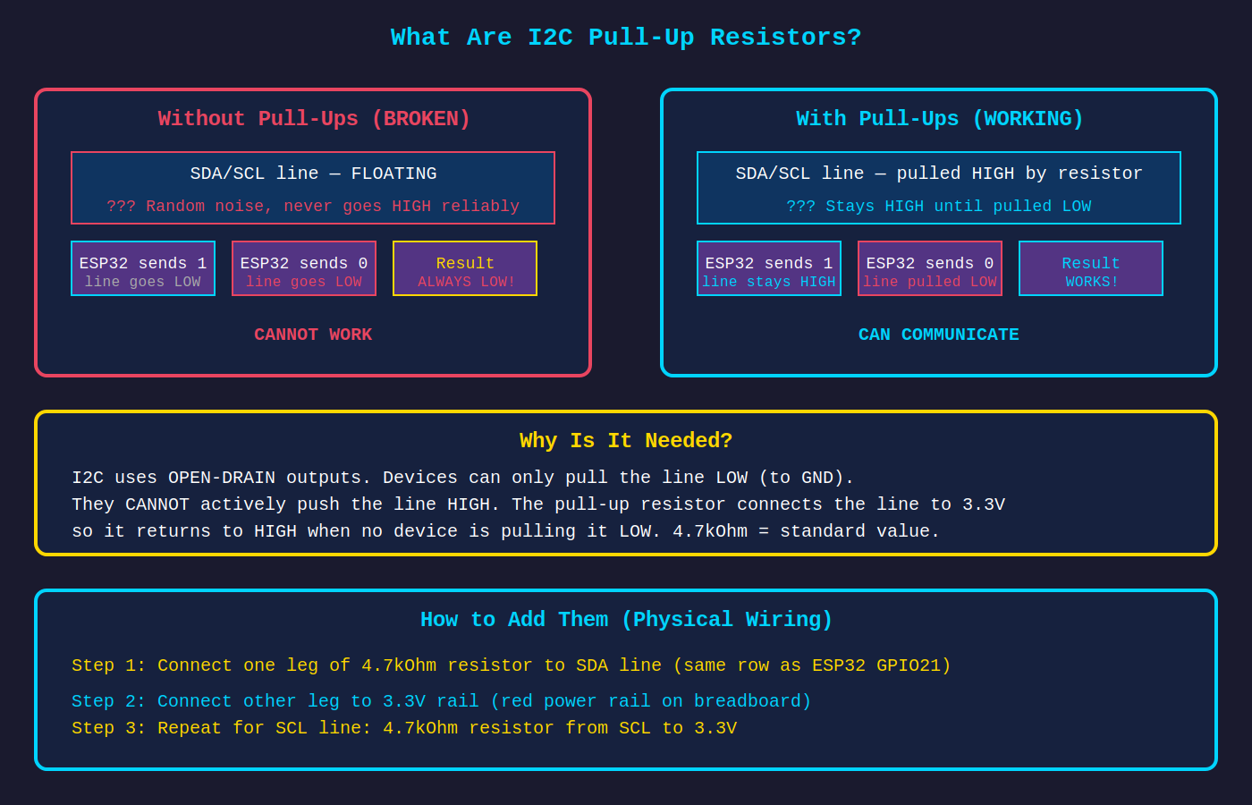
docs/pigpulse-pullup-resistors.png
