xkarma31-blip/pig-health-monitor/docs/visualizations/png/01_audio_coverage.png

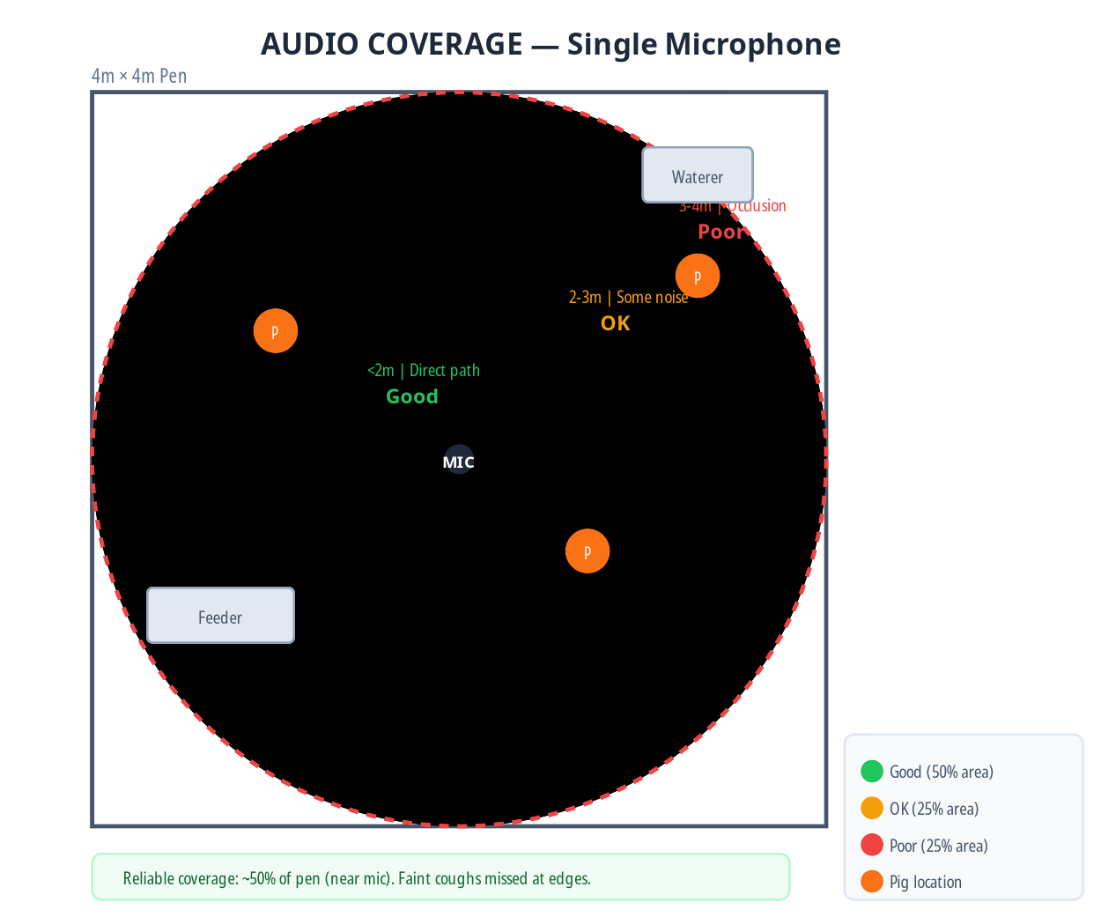
docs/visualizations/png/01_audio_coverage.png
