xkarma31-blip/pig-health-monitor/docs/visualizations/png/02_thermal_coverage.png

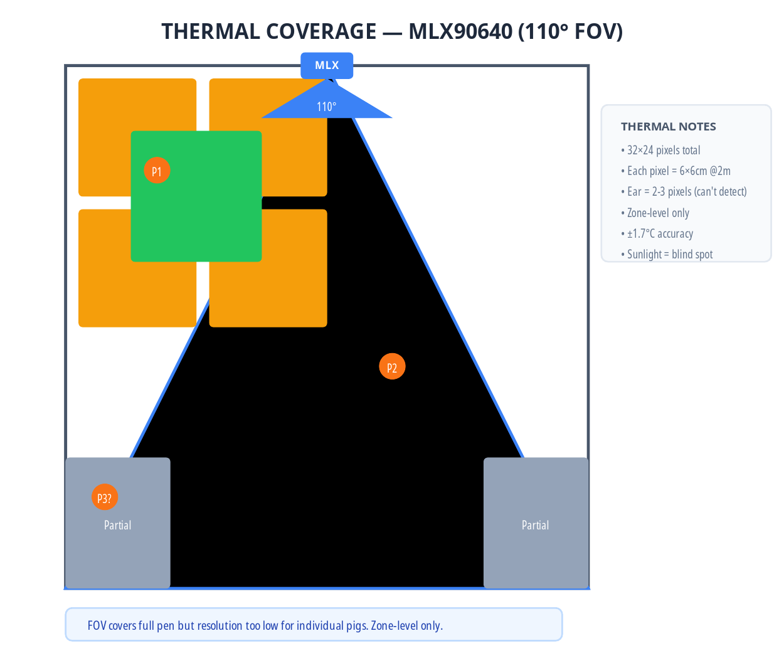
docs/visualizations/png/02_thermal_coverage.png
