xkarma31-blip/pig-health-monitor/docs/visualizations/png/03_cctv_coverage.png

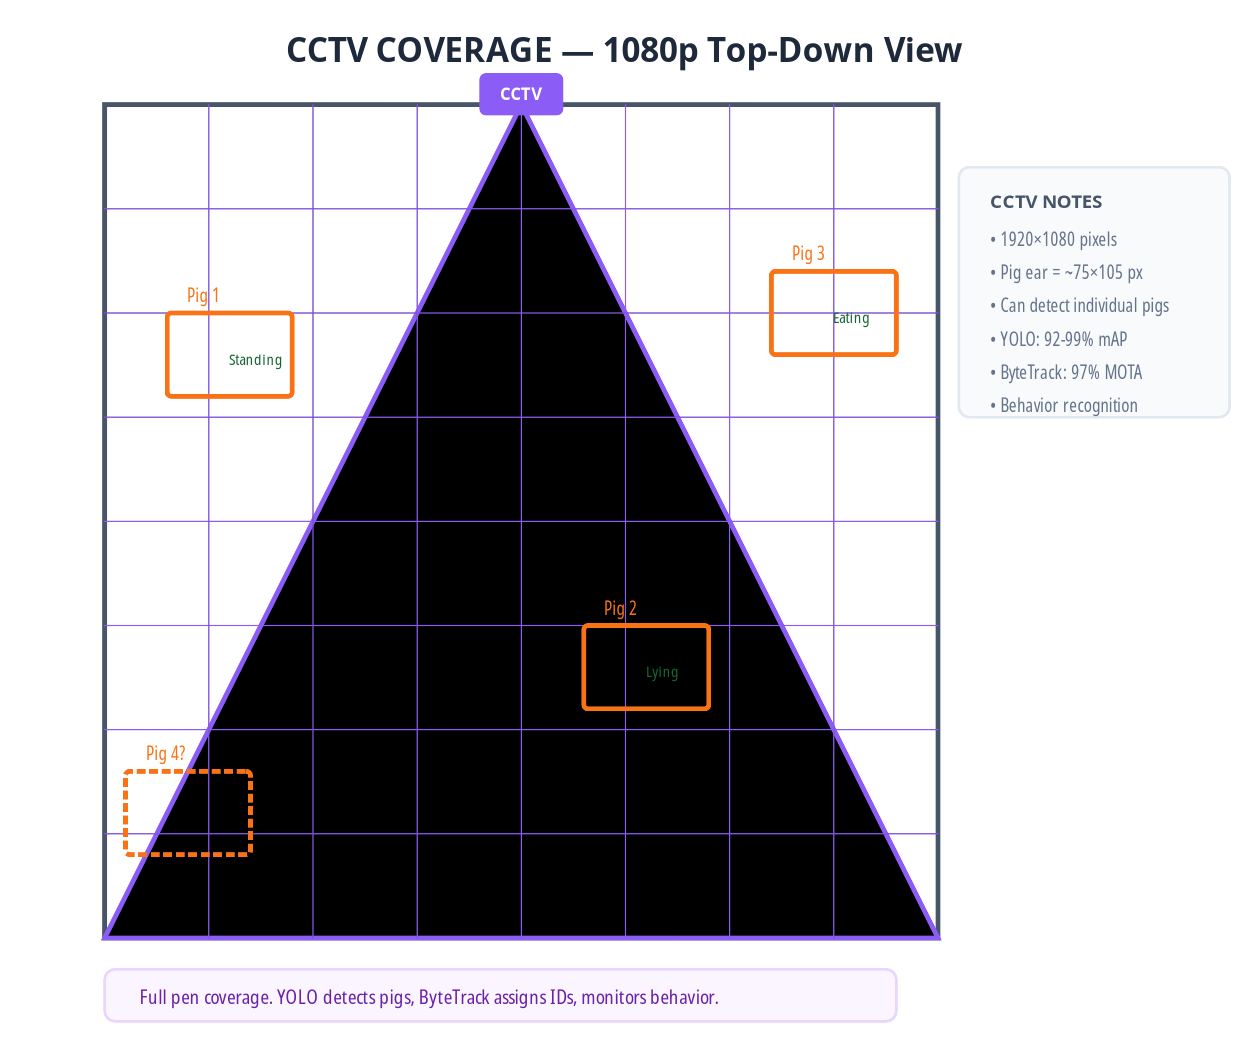
docs/visualizations/png/03_cctv_coverage.png
