xkarma31-blip/pig-health-monitor/docs/visualizations/png/04_multimodal_fusion.png

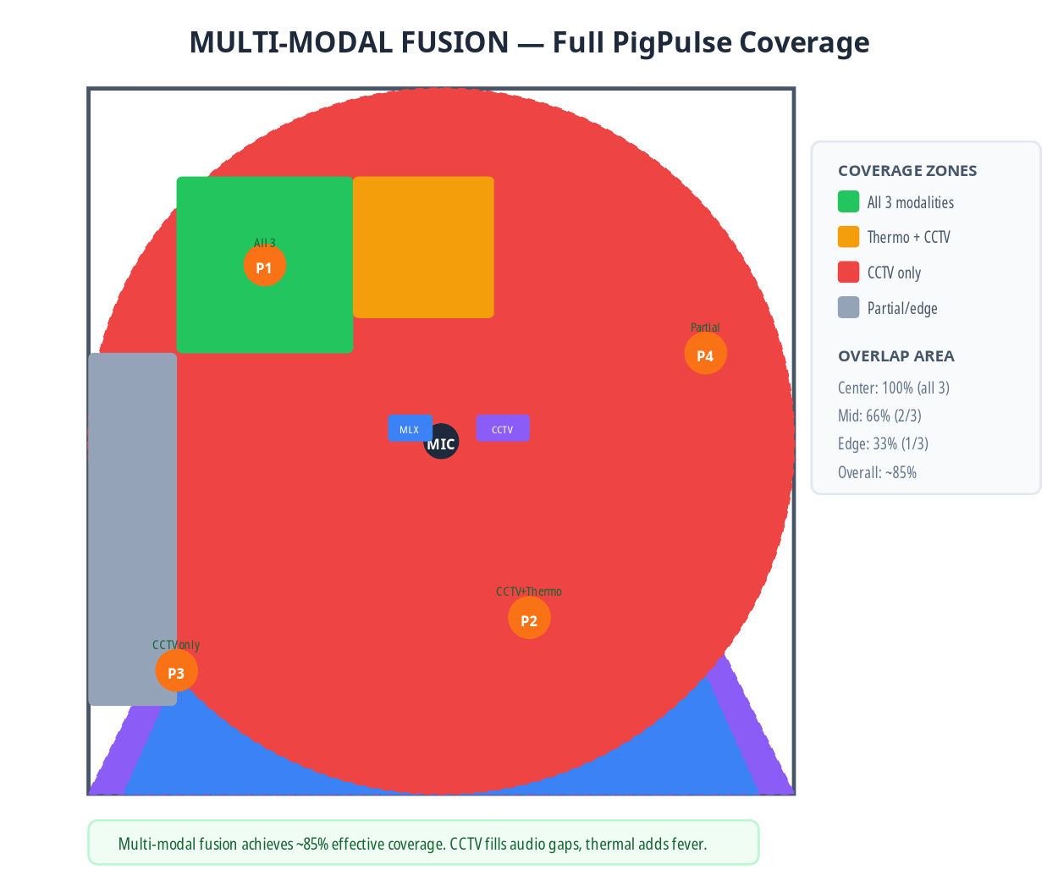
docs/visualizations/png/04_multimodal_fusion.png
