xkarma31-blip/pig-health-monitor/docs/visualizations/png/05_sensor_placement.png

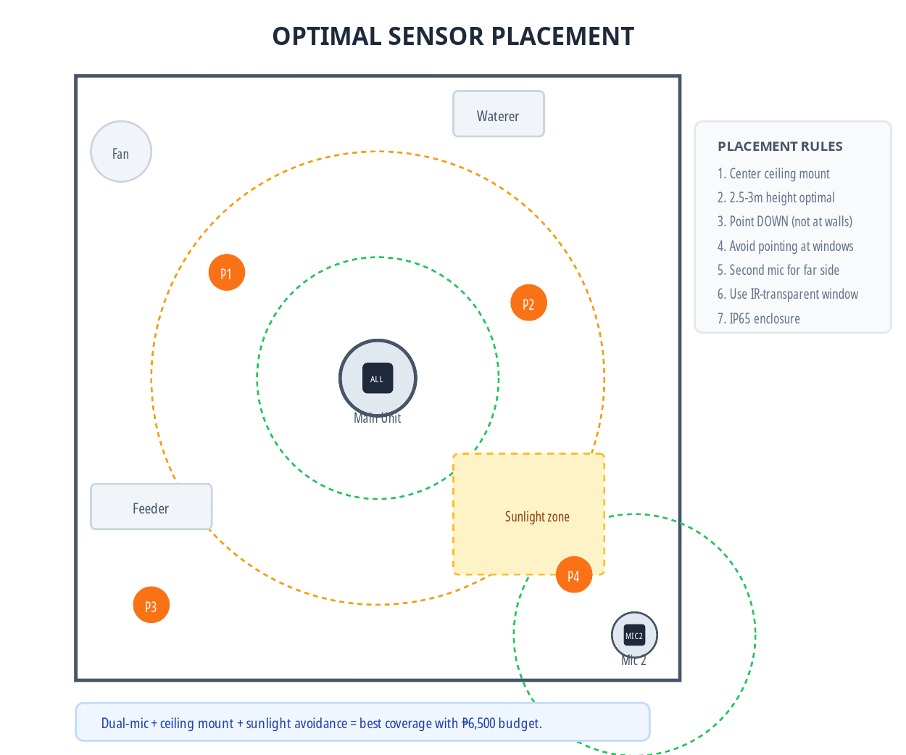
docs/visualizations/png/05_sensor_placement.png
