xkarma31-blip/pig-health-monitor/docs/visualizations/pollinations/01_audio.png

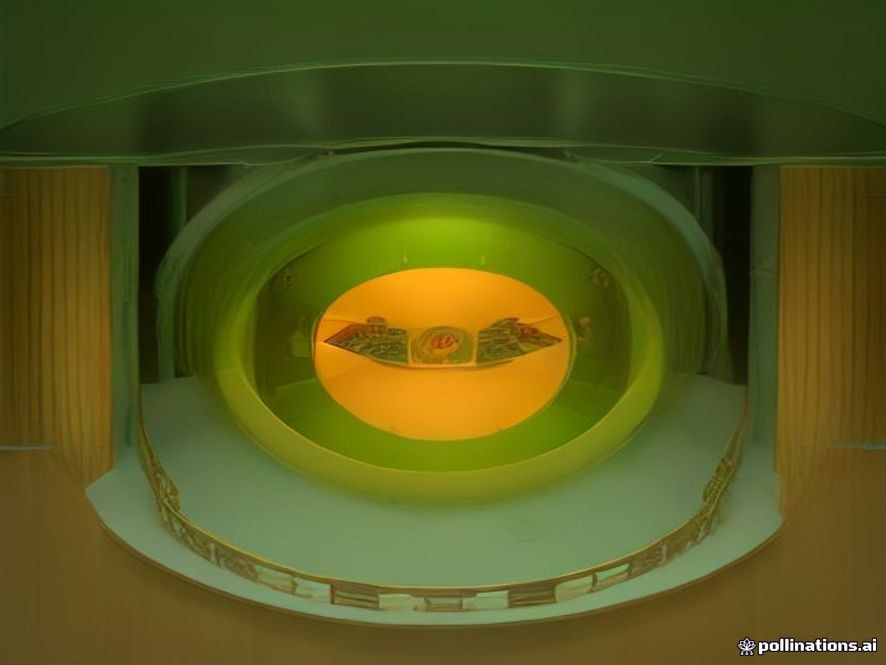
docs/visualizations/pollinations/01_audio.png
