xkarma31-blip/pig-health-monitor/docs/visualizations/pollinations/02_thermal.png

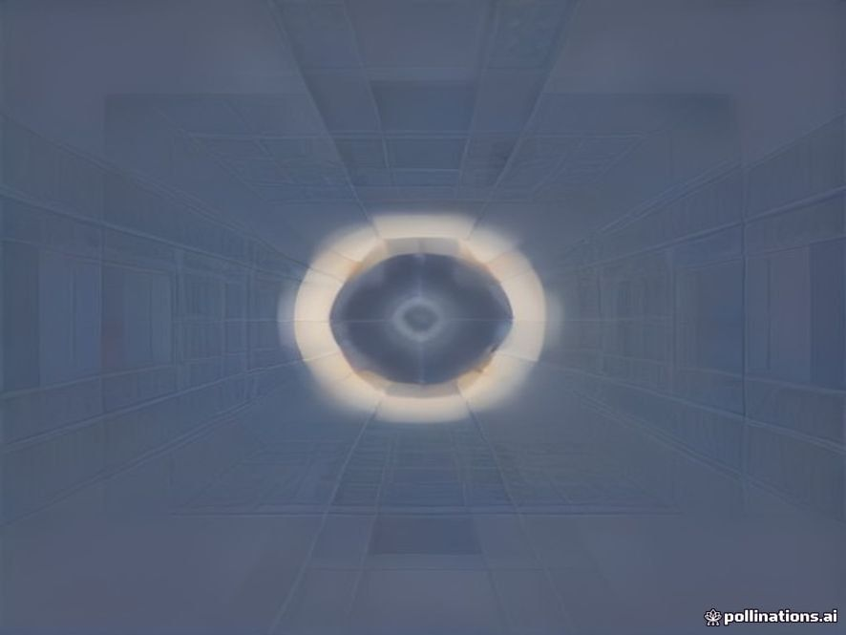
docs/visualizations/pollinations/02_thermal.png
