xkarma31-blip/pig-health-monitor/docs/visualizations/pollinations/03_cctv.png

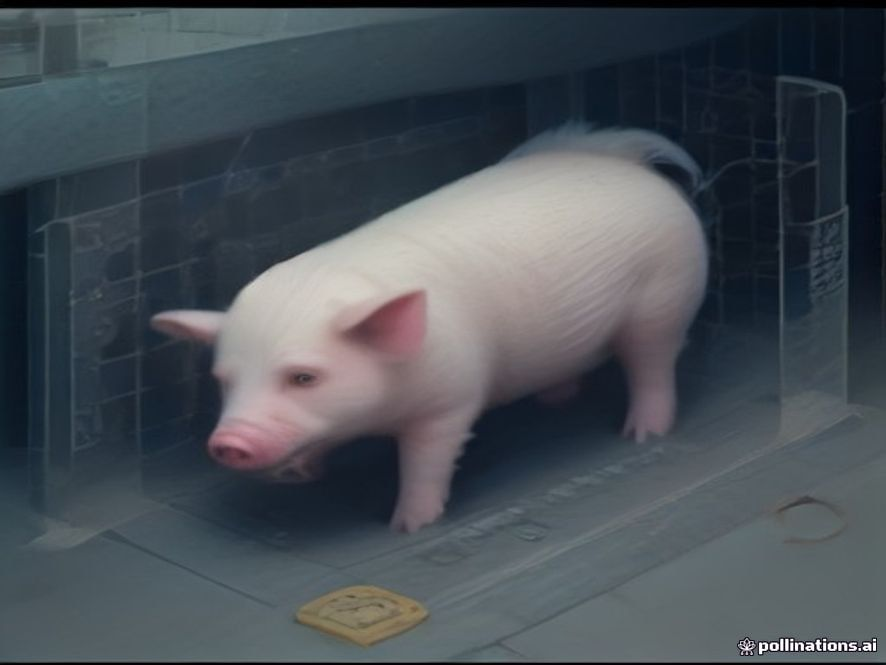
docs/visualizations/pollinations/03_cctv.png
