xkarma31-blip/pig-health-monitor/docs/visualizations/pollinations/04_multimodal.png

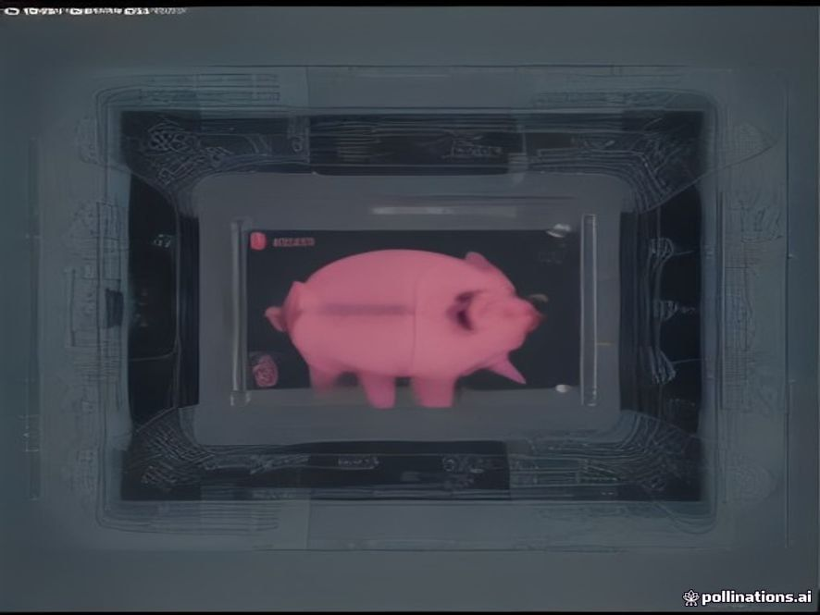
docs/visualizations/pollinations/04_multimodal.png
