xkarma31-blip/pig-health-monitor/docs/visualizations/pollinations/05_placement.png

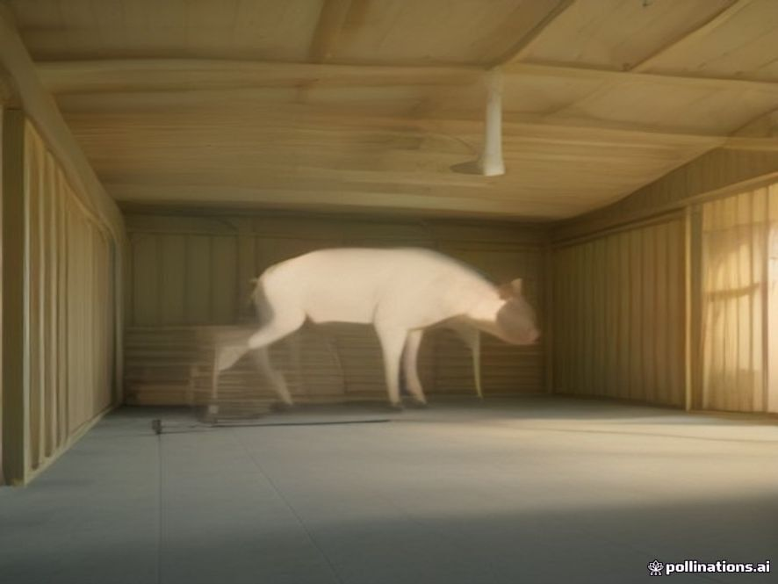
docs/visualizations/pollinations/05_placement.png
