xkarma31-blip/pig-health-monitor/landing_page/env_acoustic.webp

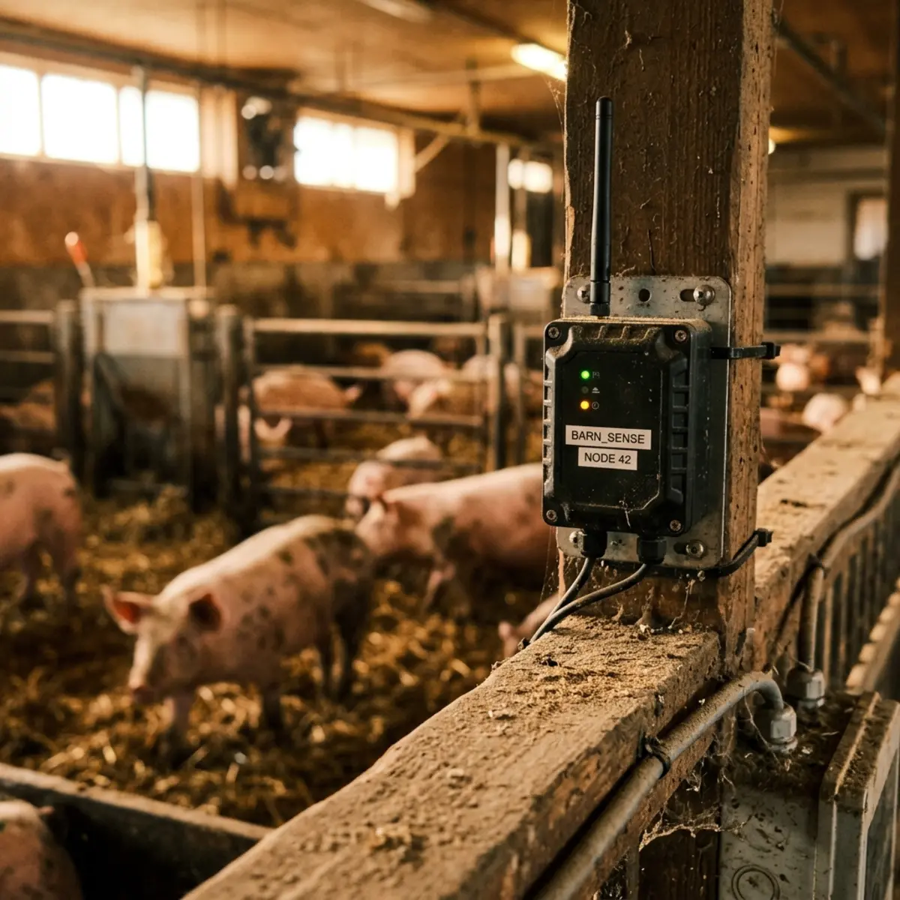
landing_page/env_acoustic.webp
