xkarma31-blip/pig-health-monitor/landing_page/env_thermal.webp

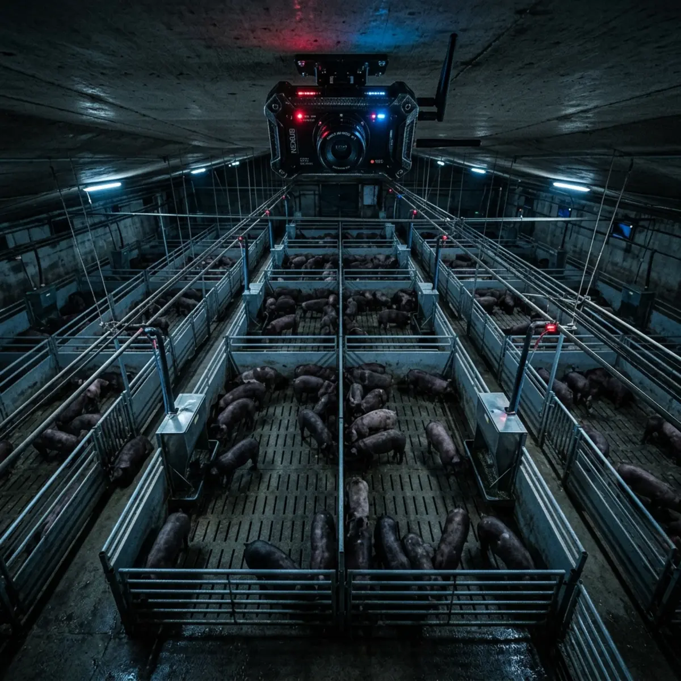
landing_page/env_thermal.webp
