xkarma31-blip/pig-health-monitor/landing_page/og-image.png

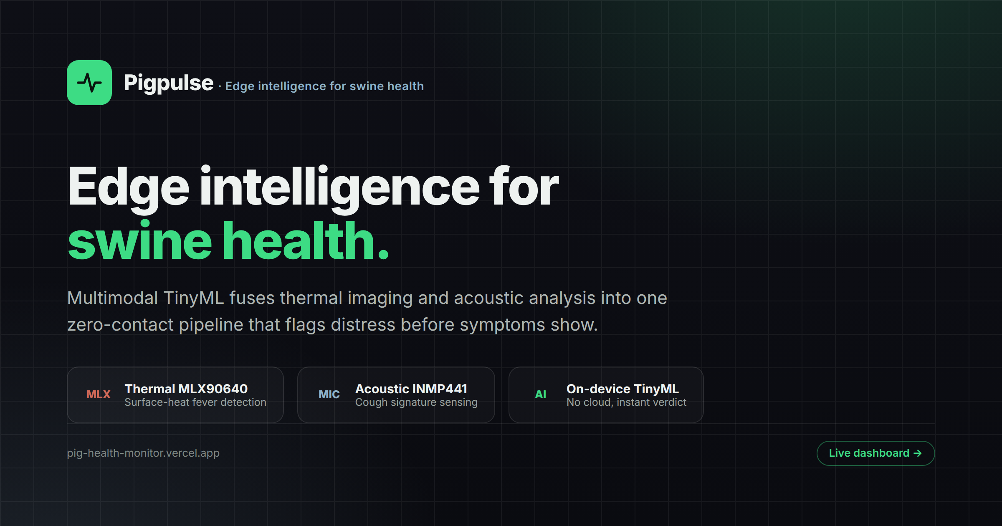
landing_page/og-image.png
