xkarma31-blip/pig-health-monitor/scripts/simulation/wokwi_firebase_running.png

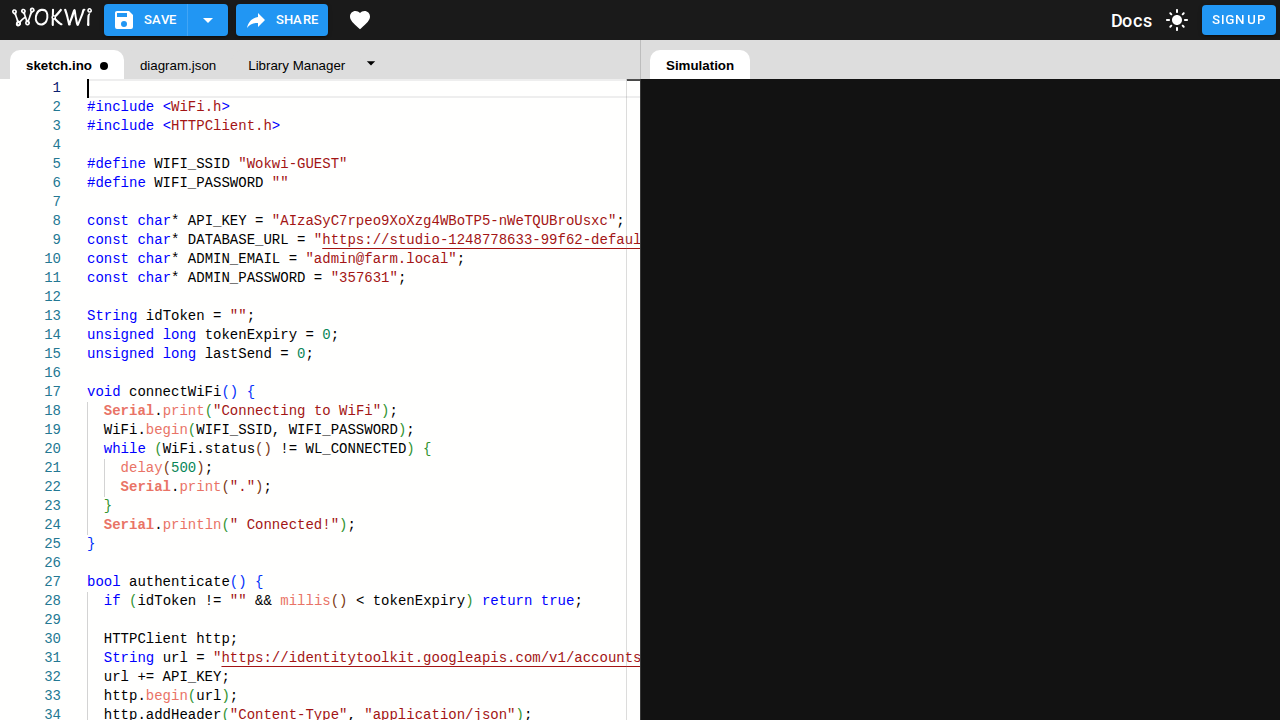
scripts/simulation/wokwi_firebase_running.png
