xkarma31-blip/pig-health-monitor/v3-mqtt-pocketbase/enclosure/recovery-20261018/research-adapters/sht-18x12.7-detail.png

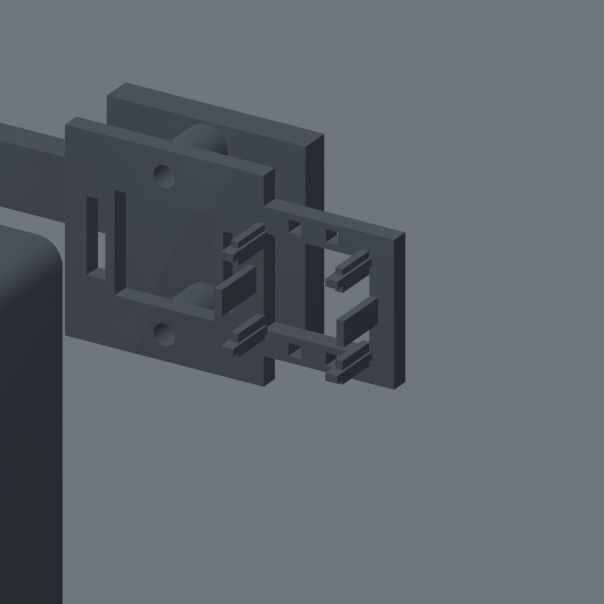
v3-mqtt-pocketbase/enclosure/recovery-20261018/research-adapters/sht-18x12.7-detail.png
