xkarma31-blip/pig-health-monitor/v3-mqtt-pocketbase/enclosure/recovery-20261018/research-adapters/sht-25.5x17.7-detail.png

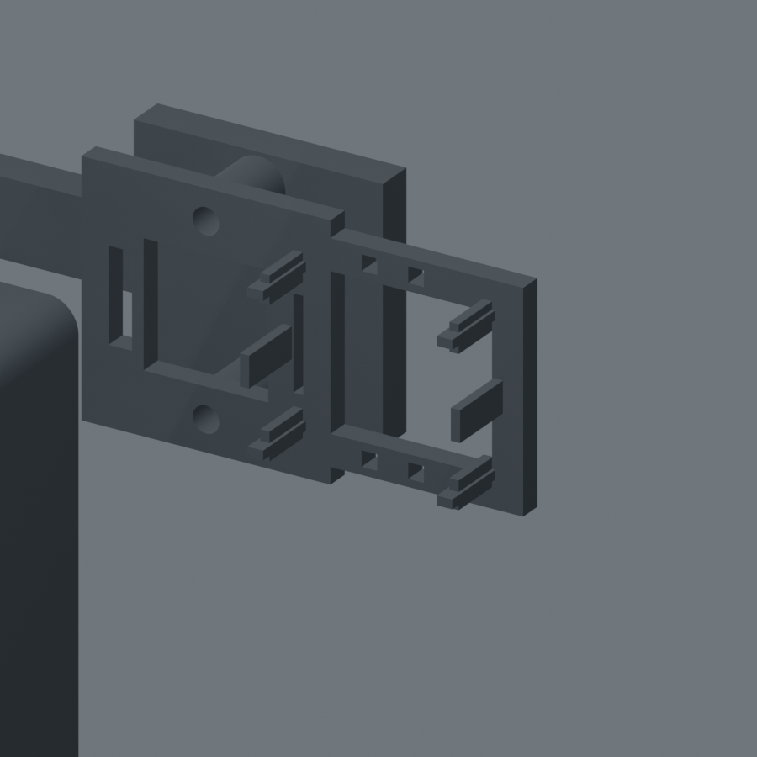
v3-mqtt-pocketbase/enclosure/recovery-20261018/research-adapters/sht-25.5x17.7-detail.png
