xkarma31-blip/pig-health-monitor/v3-mqtt-pocketbase/enclosure/recovery-20261018/revision-h/reference-comparison.png

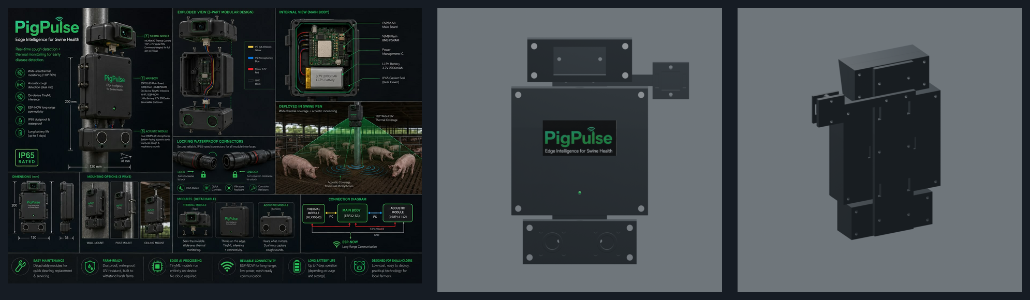
v3-mqtt-pocketbase/enclosure/recovery-20261018/revision-h/reference-comparison.png
