xkarma31-blip/pig-health-monitor/youtube/pigpulse-explainer/images/01-title.png

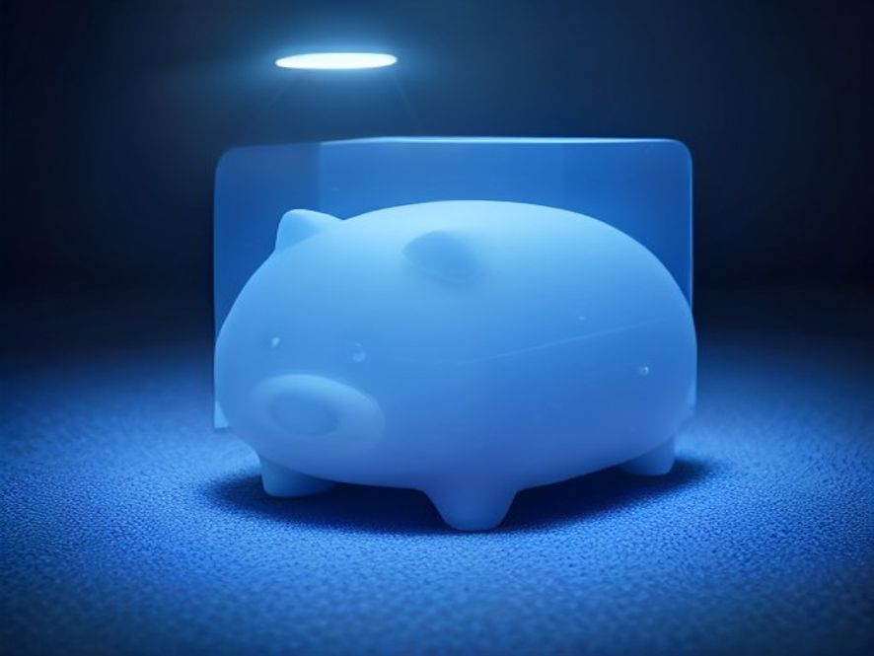
youtube/pigpulse-explainer/images/01-title.png
