xkarma31-blip/pig-health-monitor/youtube/pigpulse-explainer/images/02-pig-farm.png

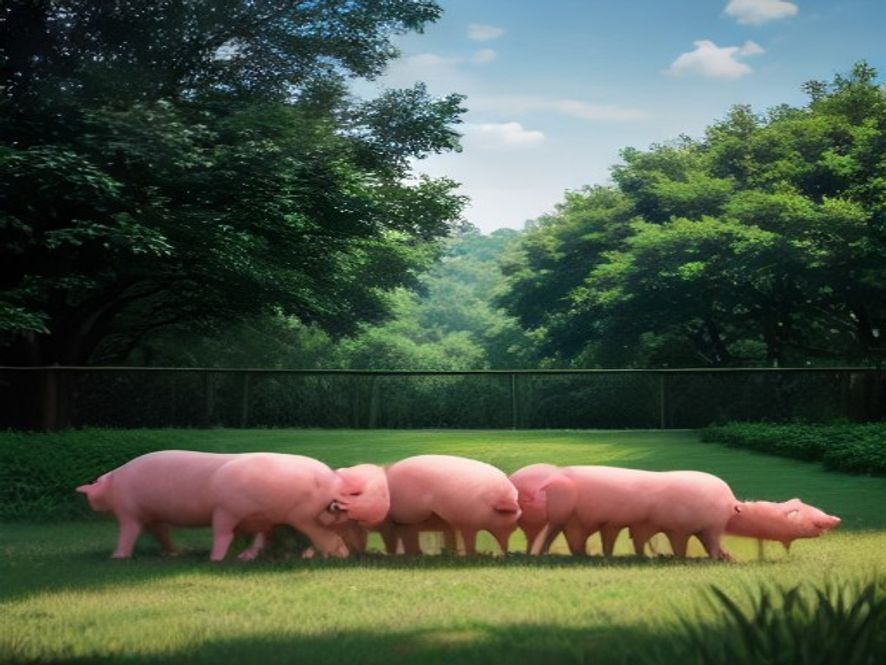
youtube/pigpulse-explainer/images/02-pig-farm.png
