xkarma31-blip/pig-health-monitor/youtube/pigpulse-explainer/images/03-thermal-camera.png

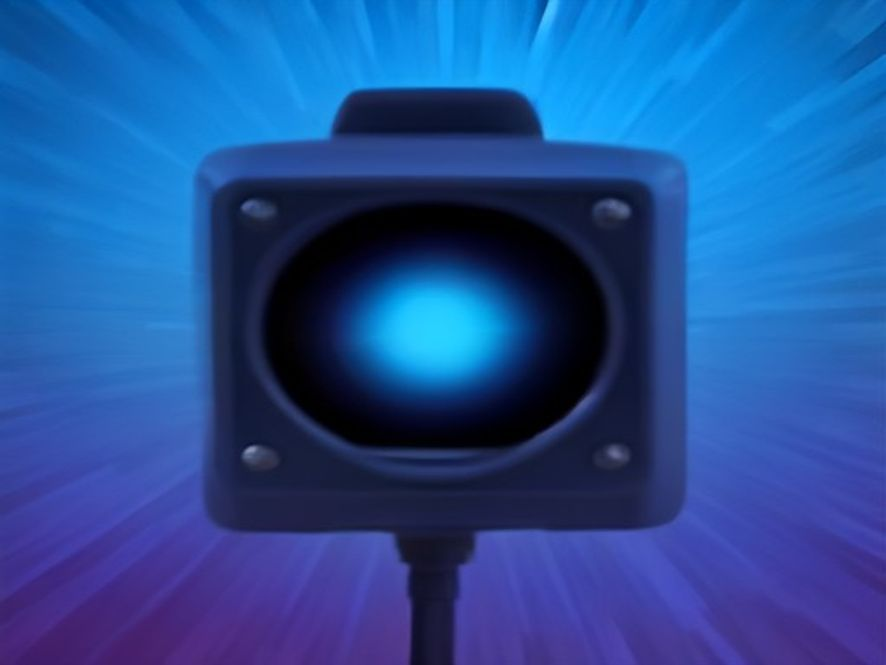
youtube/pigpulse-explainer/images/03-thermal-camera.png
