xkarma31-blip/pig-health-monitor/youtube/pigpulse-explainer/images/04-fever-alert.png

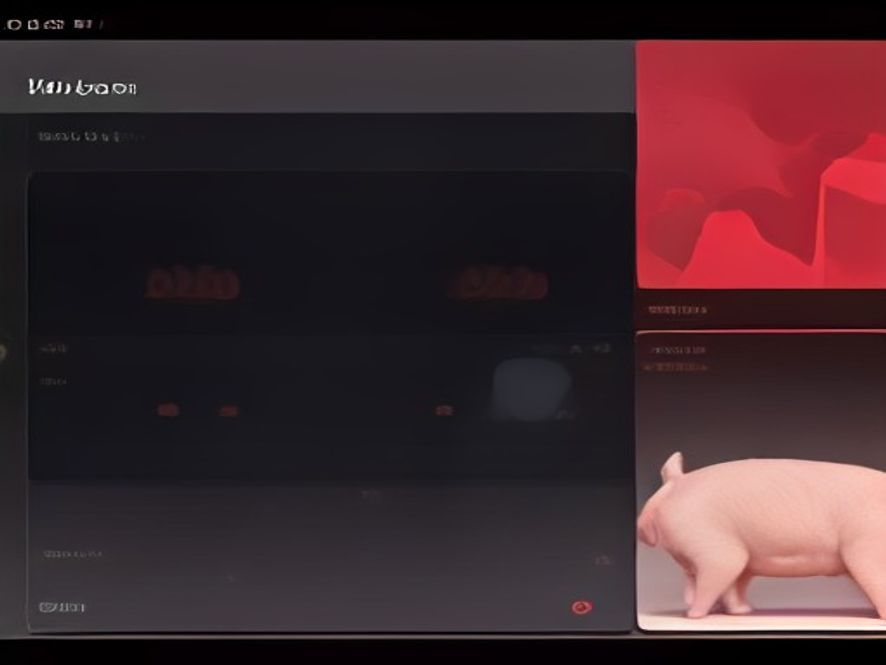
youtube/pigpulse-explainer/images/04-fever-alert.png
