xkarma31-blip/pig-health-monitor/youtube/pigpulse-explainer/images/05-audio-monitoring.png

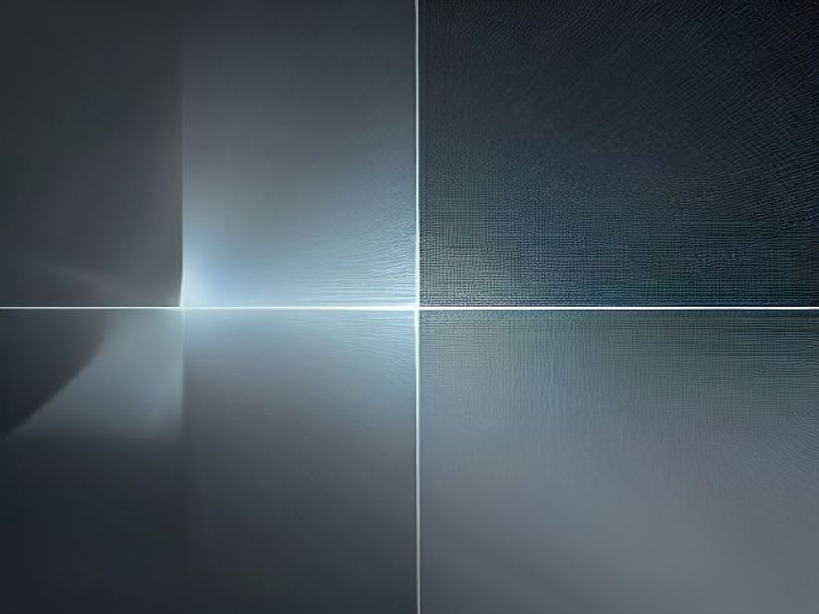
youtube/pigpulse-explainer/images/05-audio-monitoring.png
