xkarma31-blip/pig-health-monitor/youtube/pigpulse-explainer/images/06-battery.png

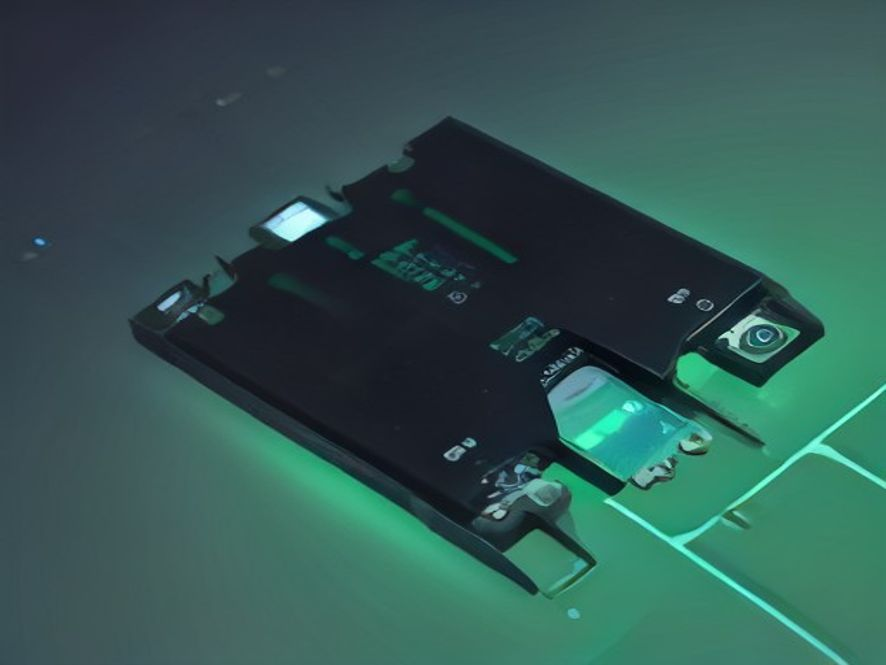
youtube/pigpulse-explainer/images/06-battery.png
