xkarma31-blip/pig-health-monitor/youtube/pigpulse-explainer/images/07-tropical-farm.png

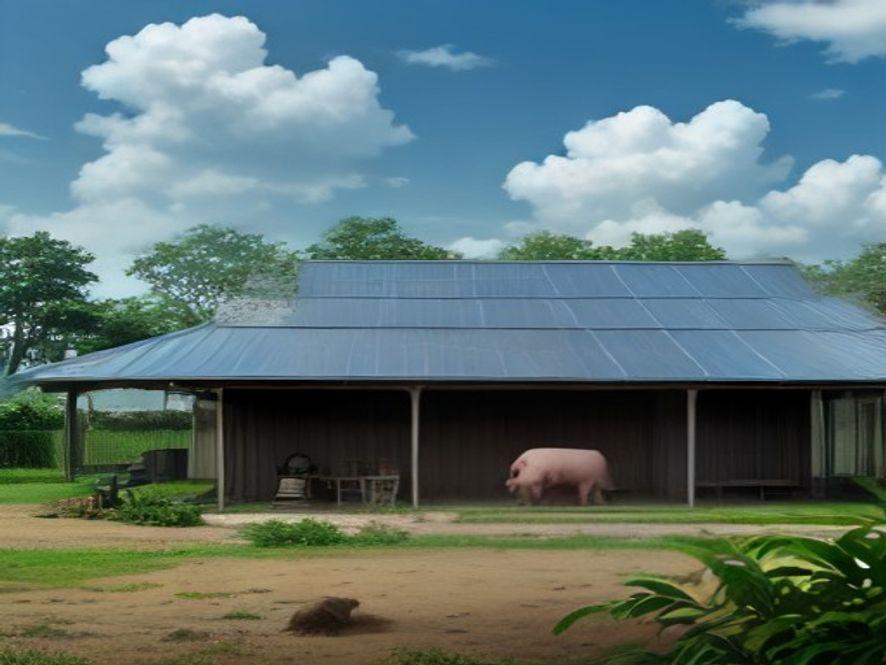
youtube/pigpulse-explainer/images/07-tropical-farm.png
