xkarma31-blip/pig-health-monitor/youtube/pigpulse-explainer/images/08-end-screen.png

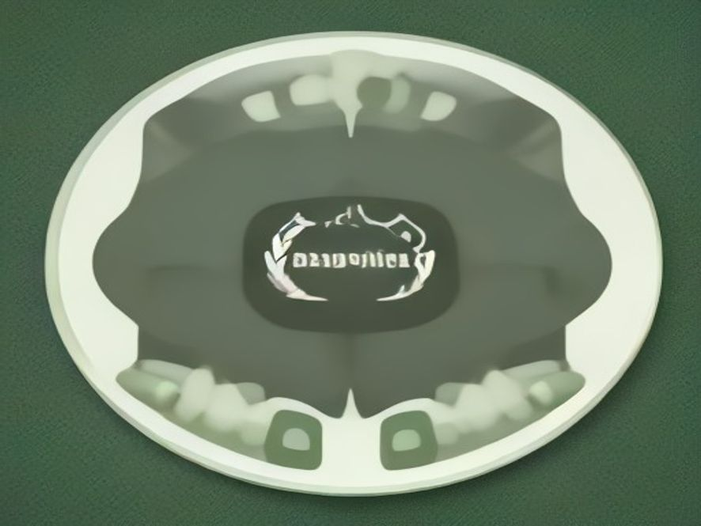
youtube/pigpulse-explainer/images/08-end-screen.png
