xkarma31-blip/pig-health-monitor/v3-mqtt-pocketbase/enclosure/recovery-20261018/revision-k/decal-material-review.txt

The "PigPulse" logo and "Edge Intelligence for Swine Health" tagline are upright, sharp, and clearly legible, contrasting well against the housing. The previous black rectangular label border has been removed, integrating the text directly onto the main face with only a subtle vertical accent line remaining to the right. 

The charcoal material presents a smooth, uniform matte finish across all modules, featuring soft diagonal highlights that define the surface contours. Corner fasteners show a clean, recessed appearance with bright circular highlights that distinctly contrast with the dark matte enclosure, giving them a defined metallic look.
