xkarma31-blip/pig-health-monitor/downloads/esp32-mlx90640-thermal-camera/bom.xlsx

No. | Quantity | Comment | Designator | Footprint | Value | Manufacturer Part | Manufacturer
1 | 5 | 22uF | C1,C4,C5,C6,C9 | C0603 | 22uF | GRM188R61A226ME15D | muRata(村田)
2 | 2 | 10uF | C2,C14 | C0603 | 10uF | C1608X5R1E106MT000E | TDK
3 | 1 | 100nF | C3 | C0603 | 100nF | CC0603KRX7R9BB104 | YAGEO(国巨)
4 | 2 | 1uF | C7,C10 | C0603 | 1uF | CL10A105KO8NNNC | SAMSUNG(三星)
5 | 4 | 100nF | C8,C11,C12,C13 | C0603 | 100nF | CL10B104KA8NNNC | SAMSUNG(三星)
6 | 1 | 0603L100SLYR | F1 | R0603 |  | 0603L100SLYR | Littelfuse(美国力特)
7 | 1 | KH-2.54PH180-1X6P-L11.5 | H1 | HDR-TH_6P-P2.54-V-M-1 |  | KH-2.54PH180-1X6P-L11.5 | kinghelm(金航标)
8 | 3 | HX PZ2.54-1x4P ZZ | H2,H3,H5 | HDR-TH_4P-P2.54-V-M |  | HX PZ2.54-1x4P ZZ | hanxia(韩下)
9 | 1 | HX PZ2.54-1x2P ZZ | H4 | HDR-TH_2P-P2.54-V-M-3 |  | HX PZ2.54-1x2P ZZ | hanxia(韩下)
10 | 1 | TYPE-C 6P(073) | J1 | TYPE-C-SMD_TYPE-C-6P_5 |  | TYPE-C 6P(073) | SHOU HAN(首韩)
11 | 1 | 1.5uH | L1 | IND-SMD_L4.0-W4.0-A | 1.5uH | XFL4020-152MEC | Coilcraft(线艺)
12 | 1 | KT-0603R | LED1 | LED0603-RD |  | KT-0603R | KENTO
13 | 2 | BC847 | Q1,Q2 | SOT-23-3_L2.9-W1.3-P1.90-LS2.4-BR |  | BC847 | SHIKUES(时科)
14 | 1 | 1MΩ | R1 | R0603 | 1MΩ | RC0603FR-071ML | YAGEO(国巨)
15 | 1 | 180kΩ | R2 | R0603 | 180kΩ | 0603WAF1803T5E | UNI-ROYAL(厚声)
16 | 4 | 10kΩ | R3,R4,R13,R14 | R0603 | 10kΩ | 0603WAJ0103T5E | UNI-ROYAL(厚声)
17 | 1 | 1kΩ | R5 | R0603 | 1kΩ | RC0603JR-071KL | YAGEO(国巨)
18 | 1 | 2kΩ | R6 | R0603 | 2kΩ | 0603WAF2001T5E | UNI-ROYAL(厚声)
19 | 1 | 47kΩ | R7 | R0603 | 47kΩ | 0603WAJ0473T5E | UNI-ROYAL(厚声)
20 | 1 | 1.5kΩ | R8 | R0603 | 1.5kΩ | 0603WAF1501T5E | UNI-ROYAL(厚声)
21 | 2 | 5.1kΩ | R9,R10 | R0603 | 5.1kΩ | 0603WAF5101T5E | UNI-ROYAL(厚声)
22 | 2 | 100kΩ | R11,R12 | R0603 | 100kΩ | RC0603FR-07100KL | YAGEO(国巨)
23 | 1 | MK-12D18-G040 | SW1 | SW-TH_MK-12D18-G040 |  | MK-12D18-G040 | G-Switch(品赞)
24 | 1 | BQ24092DGQR | U2 | MSOP-10_L3.0-W3.0-P0.50-LS5.0-BL-EP |  | BQ24092DGQR | TI(德州仪器)
25 | 1 | TPS63020DSJT | U3 | VSON-14_L4.0-W3.0-P0.50-BL-EP_TI_DSJ |  | TPS63020DSJT | TI(德州仪器)
26 | 1 | ESP32-WROOM-32-N4 | U4 | WIFIM-SMD_ESP32-WROOM-32-N4 |  | ESP32-WROOM-32-N4 | ESPRESSIF(乐鑫)
27 | 1 | S2B-ZR(LF)(SN) | U5 | CONN-TH_S2B-ZR-LF-SN |  | S2B-ZR(LF)(SN) | JST
