xkarma31-blip/pig-health-monitor/v3-mqtt-pocketbase/enclosure/recovery-20261018/revision-o/split-boss-experiment/main_lid-concept.stl

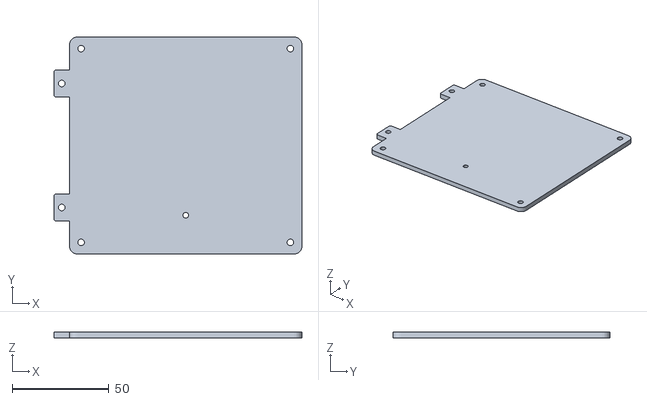
[picture p39: CAD file, 2026-10-29]
v3-mqtt-pocketbase/enclosure/recovery-20261018/revision-o/split-boss-experiment/main_lid-concept.stl
128.0 x 112.0 x 3.00
