xkarma31-blip/pig-health-monitor/v3-mqtt-pocketbase/enclosure/recovery-20261018/revision-p/pre-tool-access-repair/main_tub.stl

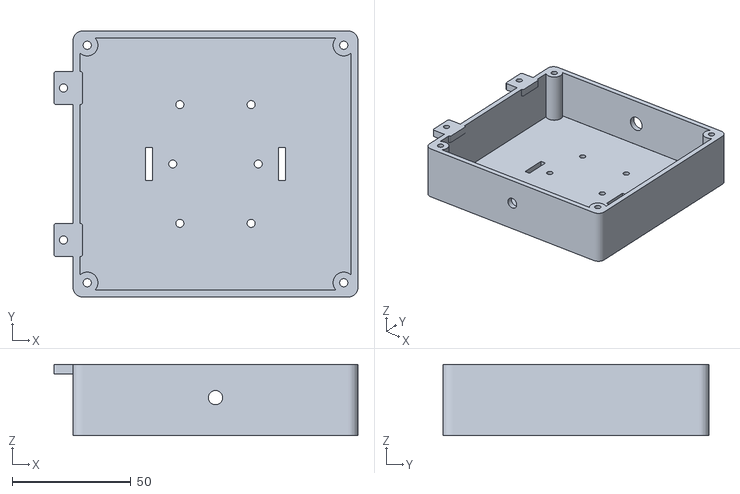
[picture p40: CAD file, 2026-10-29]
v3-mqtt-pocketbase/enclosure/recovery-20261018/revision-p/pre-tool-access-repair/main_tub.stl
128.0 x 112.0 x 30.0
