xkarma31-blip/pig-health-monitor/v3-mqtt-pocketbase/enclosure/stl/pigpulse_main_body_lid.stl

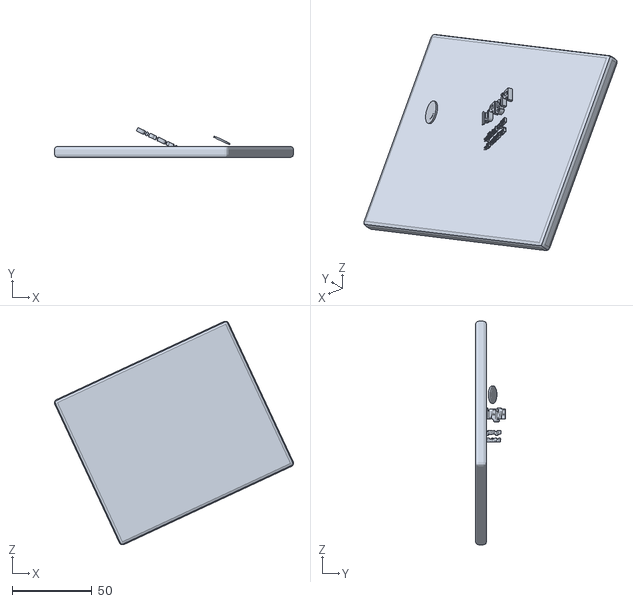
[picture p41: CAD file, 2026-10-29]
v3-mqtt-pocketbase/enclosure/stl/pigpulse_main_body_lid.stl
149.5 x 18.8 x 139.8
