xkarma31-blip/pig-health-monitor/v3-mqtt-pocketbase/enclosure/recovery-20261018/revision-h/main_lid.stl

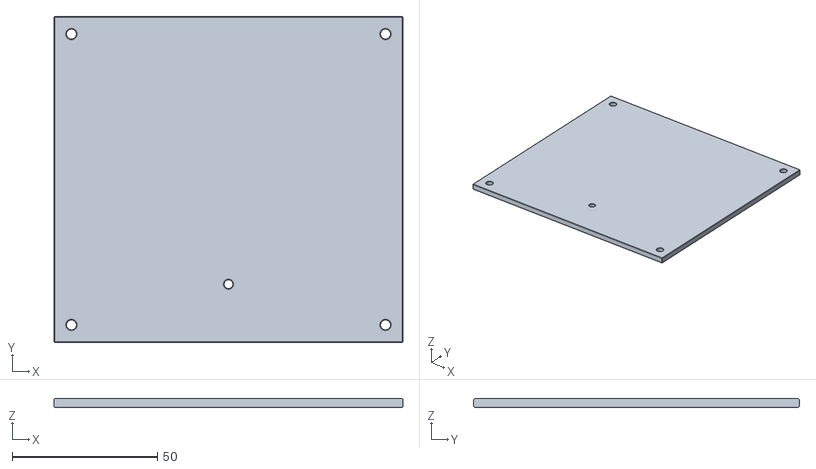
[picture p42: CAD file, 2026-10-29]
v3-mqtt-pocketbase/enclosure/recovery-20261018/revision-h/main_lid.stl
120.0 x 112.0 x 3.00
