xkarma31-blip/pig-health-monitor/v3-mqtt-pocketbase/enclosure/stl/pigpulse_main_body_lower.stl

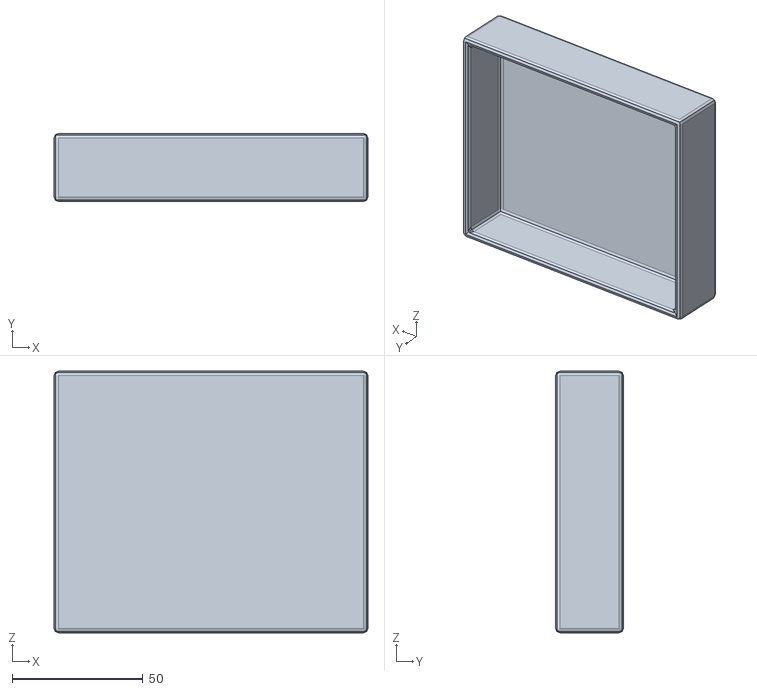
[picture p44: CAD file, 2026-10-29]
v3-mqtt-pocketbase/enclosure/stl/pigpulse_main_body_lower.stl
120.0 x 26.0 x 100.0
