xkarma31-blip/pig-health-monitor/v3-mqtt-pocketbase/enclosure/recovery-20261018/revision-o/main_tub.stl

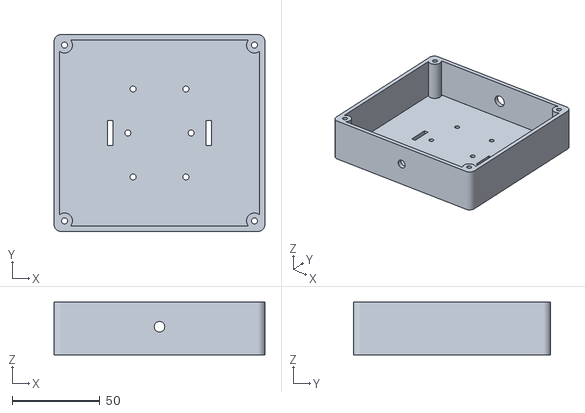
[picture p45: CAD file, 2026-10-29]
v3-mqtt-pocketbase/enclosure/recovery-20261018/revision-o/main_tub.stl
120.0 x 112.0 x 30.0
