xkarma31-blip/pig-health-monitor/v3-mqtt-pocketbase/enclosure/recovery-20261018/research-adapters/pcb25_4x17_78_rear_insert.stl

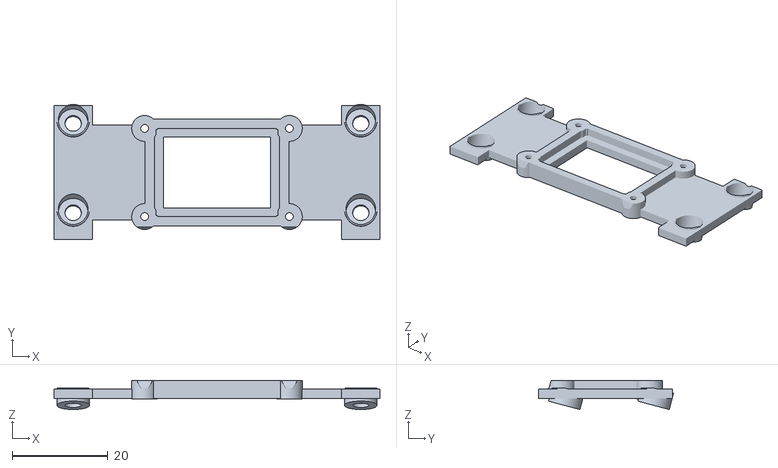
[picture p46: CAD file, 2026-10-29]
v3-mqtt-pocketbase/enclosure/recovery-20261018/research-adapters/pcb25_4x17_78_rear_insert.stl
68.0 x 28.2 x 6.07
