xkarma31-blip/pig-health-monitor/v3-mqtt-pocketbase/enclosure/recovery-20261018/research-adapters/thermal-history-20261019T021646325941Z/pcb25_4x17_78_retainer_1.stl

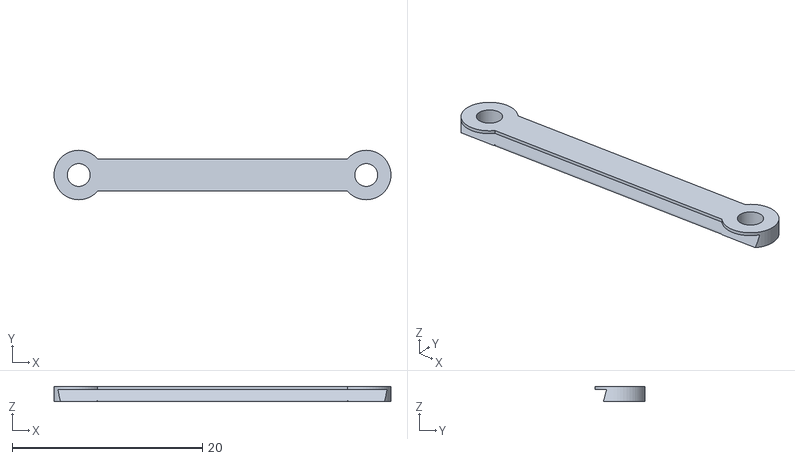
[picture p49: CAD file, 2026-10-29]
v3-mqtt-pocketbase/enclosure/recovery-20261018/research-adapters/thermal-history-20261019T021646325941Z/pcb25_4x17_78_retainer_1.stl
35.4 x 5.20 x 1.60
