xkarma31-blip/pig-health-monitor/v3-mqtt-pocketbase/enclosure/recovery-20261018/research-adapters/thermal-history-20261019T021850340669Z/pcb28x16_retainer_1.stl

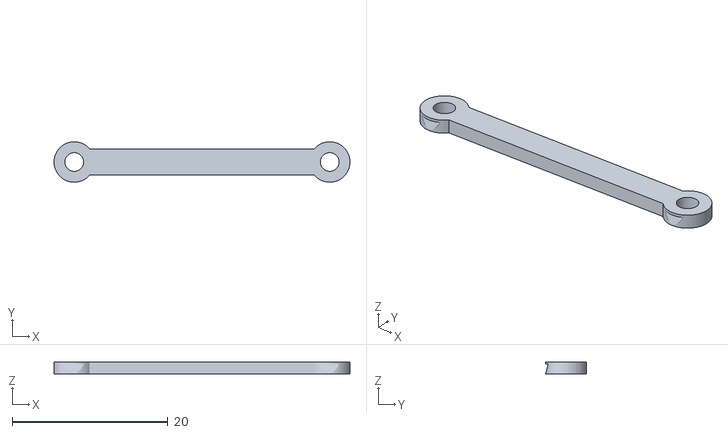
[picture p51: CAD file, 2026-10-29]
v3-mqtt-pocketbase/enclosure/recovery-20261018/research-adapters/thermal-history-20261019T021850340669Z/pcb28x16_retainer_1.stl
38.0 x 5.20 x 1.60
