xkarma31-blip/pig-health-monitor/v3-mqtt-pocketbase/enclosure/recovery-20261018/research-adapters/thermal-history-20261019T022420295853Z/pcb28x16_rear_insert.stl

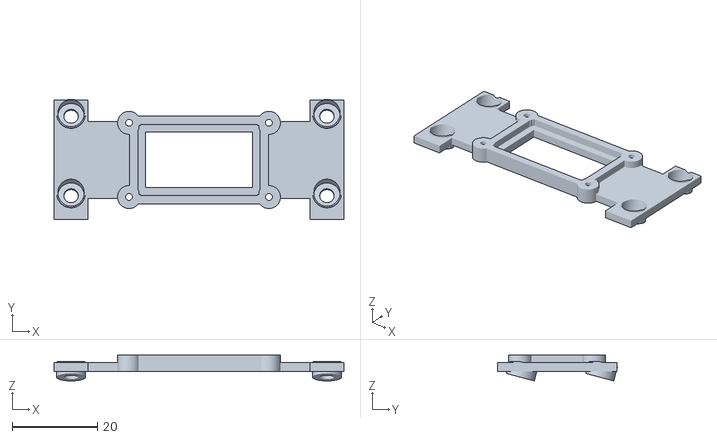
[picture p53: CAD file, 2026-10-29]
v3-mqtt-pocketbase/enclosure/recovery-20261018/research-adapters/thermal-history-20261019T022420295853Z/pcb28x16_rear_insert.stl
68.0 x 28.2 x 6.07
