xkarma31-blip/pig-health-monitor/v3-mqtt-pocketbase/enclosure/recovery-20261018/research-adapters/thermal-history-20261019T023311499525Z/pcb25_4x17_78_retainer_2.stl

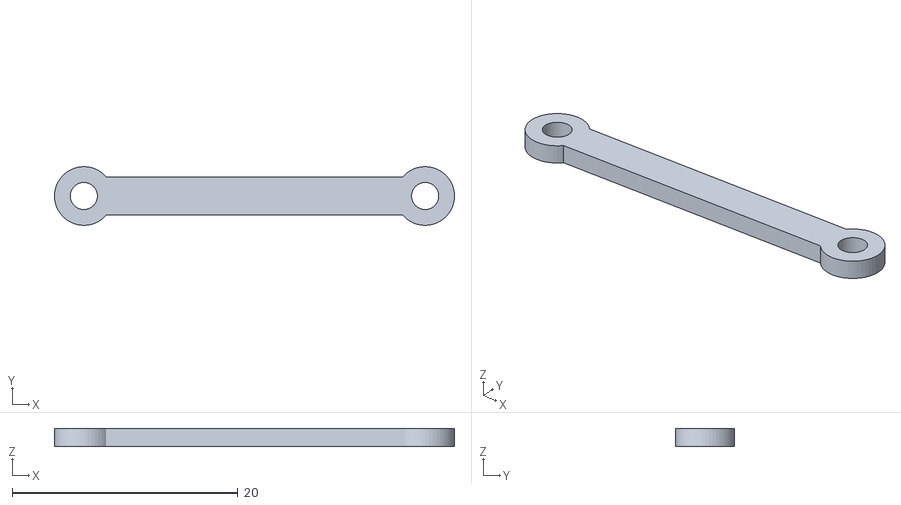
[picture p55: CAD file, 2026-10-29]
v3-mqtt-pocketbase/enclosure/recovery-20261018/research-adapters/thermal-history-20261019T023311499525Z/pcb25_4x17_78_retainer_2.stl
35.4 x 5.20 x 1.60
