xkarma31-blip/pig-health-monitor/v3-mqtt-pocketbase/enclosure/recovery-20261018/research-adapters/thermal-rear-before-repair-20261019/pcb25_4square_rear_insert.stl

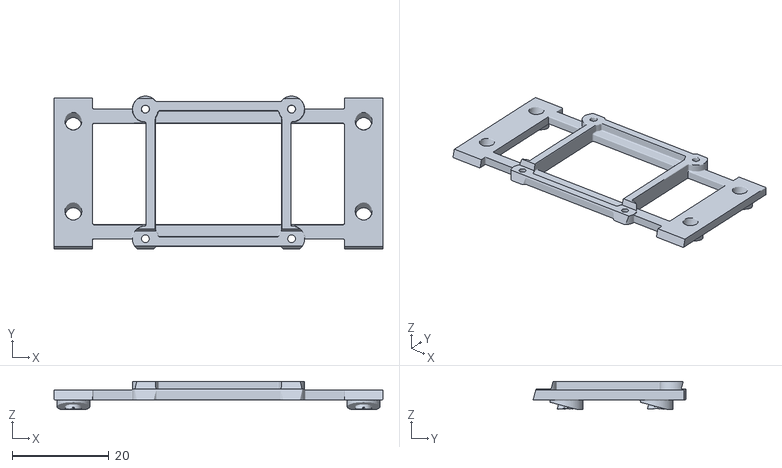
[picture p56: CAD file, 2026-10-29]
v3-mqtt-pocketbase/enclosure/recovery-20261018/research-adapters/thermal-rear-before-repair-20261019/pcb25_4square_rear_insert.stl
68.0 x 31.6 x 5.80
