xkarma31-blip/pig-health-monitor/v3-mqtt-pocketbase/enclosure/recovery-20261018/research-adapters/thermal-rear-preserved-20261019-start/pcb25_4square_retainer_1.stl

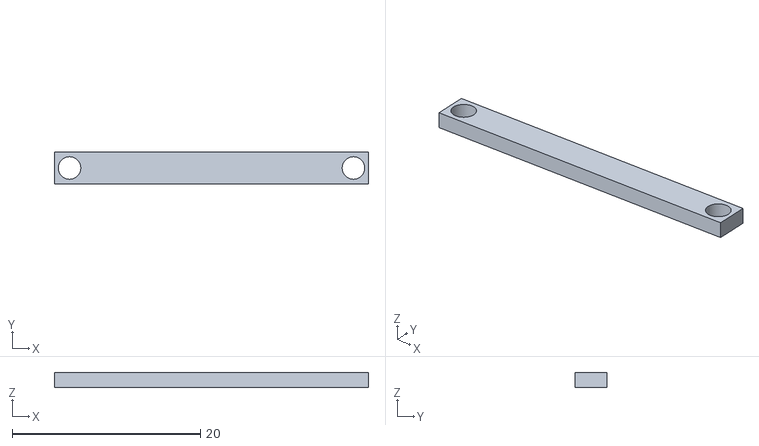
[picture p57: CAD file, 2026-10-29]
v3-mqtt-pocketbase/enclosure/recovery-20261018/research-adapters/thermal-rear-preserved-20261019-start/pcb25_4square_retainer_1.stl
33.4 x 3.40 x 1.60
