xkarma31-blip/pig-health-monitor/v3-mqtt-pocketbase/enclosure/recovery-20261018/revision-h/thermal_strap_carrier.stl

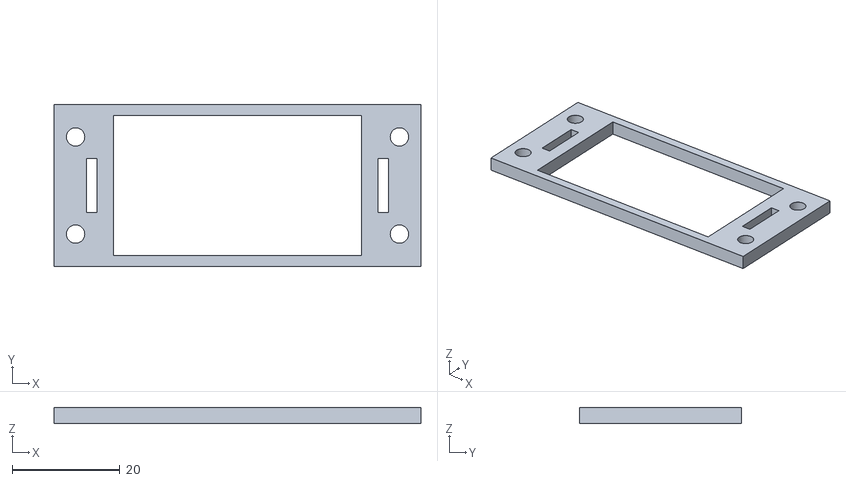
[picture p58: CAD file, 2026-10-29]
v3-mqtt-pocketbase/enclosure/recovery-20261018/revision-h/thermal_strap_carrier.stl
68.0 x 30.0 x 3.00
