xkarma31-blip/pig-health-monitor/v3-mqtt-pocketbase/enclosure/recovery-20261018/revision-j/thermal_raised_cradle.stl

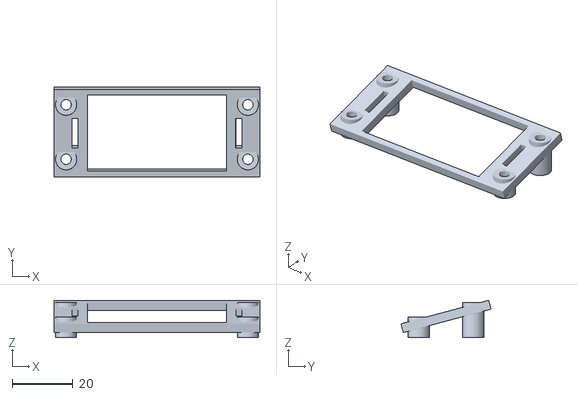
[picture p60: CAD file, 2026-10-29]
v3-mqtt-pocketbase/enclosure/recovery-20261018/revision-j/thermal_raised_cradle.stl
68.0 x 29.7 x 12.3
