xkarma31-blip/pig-health-monitor/v3-mqtt-pocketbase/enclosure/recovery-20261018/revision-l/thermal_tub.stl

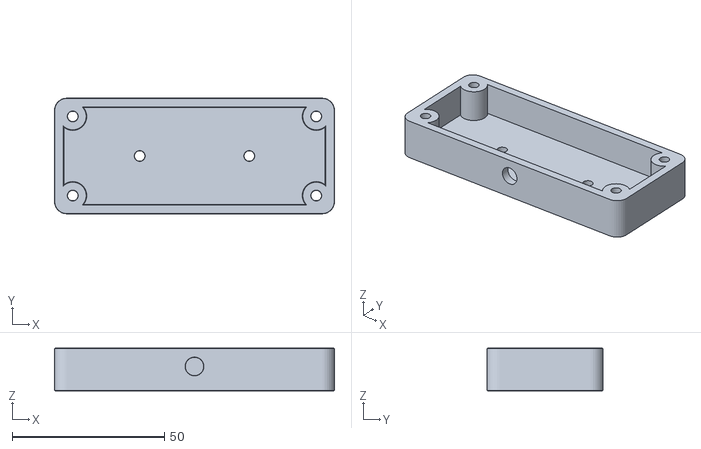
[picture p61: CAD file, 2026-10-29]
v3-mqtt-pocketbase/enclosure/recovery-20261018/revision-l/thermal_tub.stl
92.0 x 38.0 x 14.0
