xkarma31-blip/pig-health-monitor/v3-mqtt-pocketbase/enclosure/recovery-20261018/revision-n/acoustic_face.stl

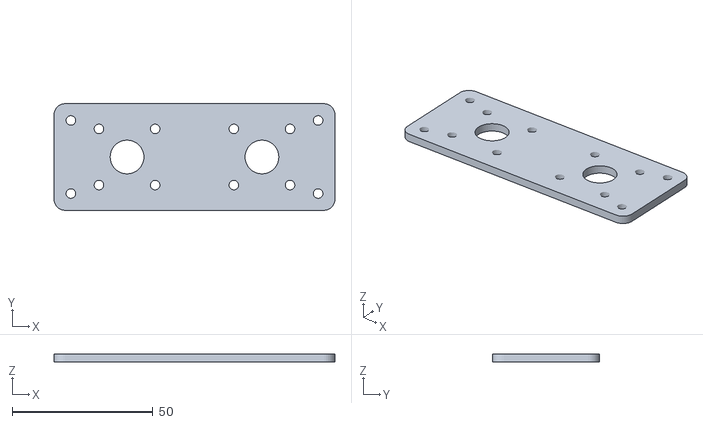
[picture p62: CAD file, 2026-10-29]
v3-mqtt-pocketbase/enclosure/recovery-20261018/revision-n/acoustic_face.stl
100.0 x 38.0 x 3.00
