xkarma31-blip/pig-health-monitor/v3-mqtt-pocketbase/enclosure/recovery-20261018/revision-o/sht_mount_arm.stl

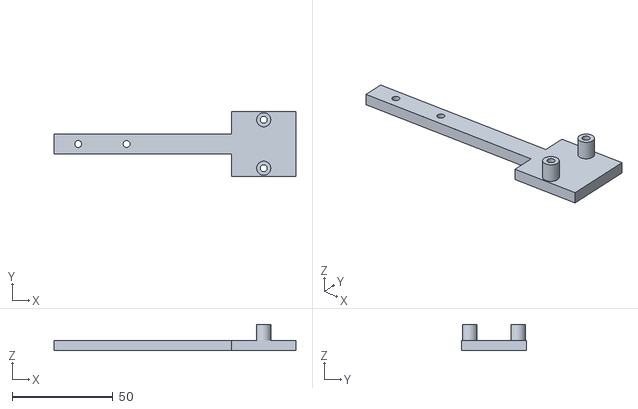
[picture p63: CAD file, 2026-10-29]
v3-mqtt-pocketbase/enclosure/recovery-20261018/revision-o/sht_mount_arm.stl
120.0 x 32.0 x 13.0
