xkarma31-blip/pig-health-monitor/v3-mqtt-pocketbase/enclosure/stl/pigpulse_acoustic_module_housing.stl

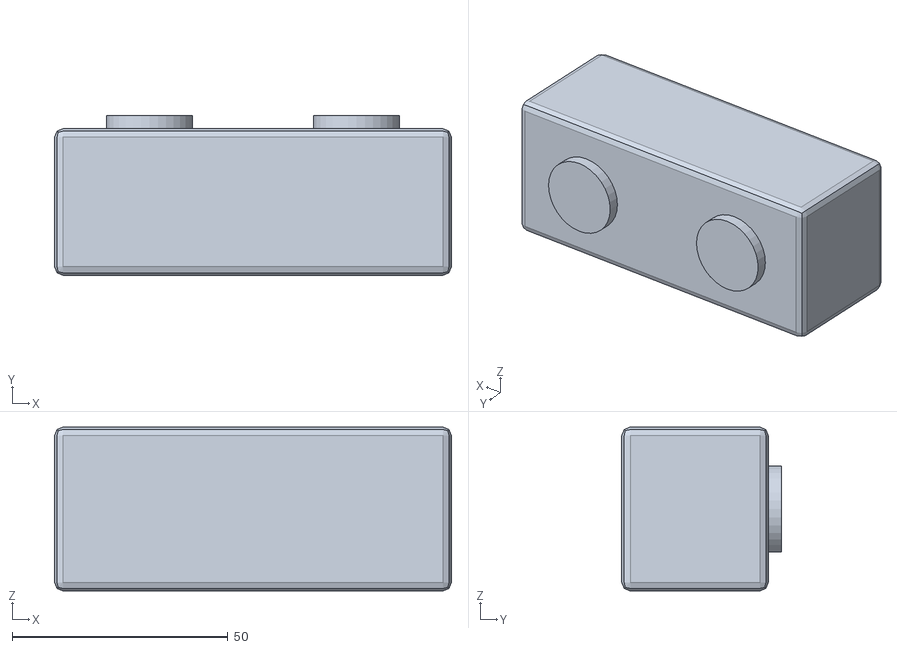
[picture p64: CAD file, 2026-10-29]
v3-mqtt-pocketbase/enclosure/stl/pigpulse_acoustic_module_housing.stl
92.0 x 37.0 x 38.0
