xkarma31-blip/pig-health-monitor/v3-mqtt-pocketbase/enclosure/recovery-20261018/research-adapters/research_spine_tray_access.stl

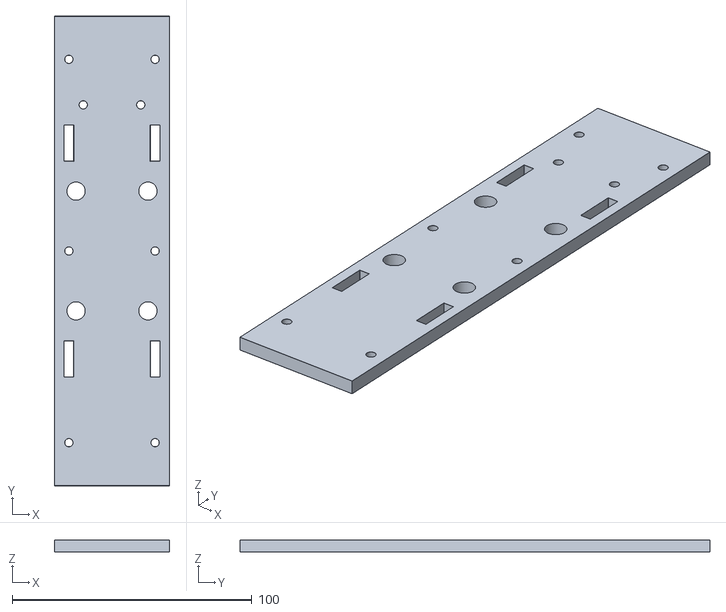
[picture p65: CAD file, 2026-10-29]
v3-mqtt-pocketbase/enclosure/recovery-20261018/research-adapters/research_spine_tray_access.stl
48.0 x 196.0 x 5.00
