xkarma31-blip/pig-health-monitor/v3-mqtt-pocketbase/enclosure/recovery-20261018/research-adapters/thermal-rear-before-repair-20261019/pcb28x16_retainer_2.stl

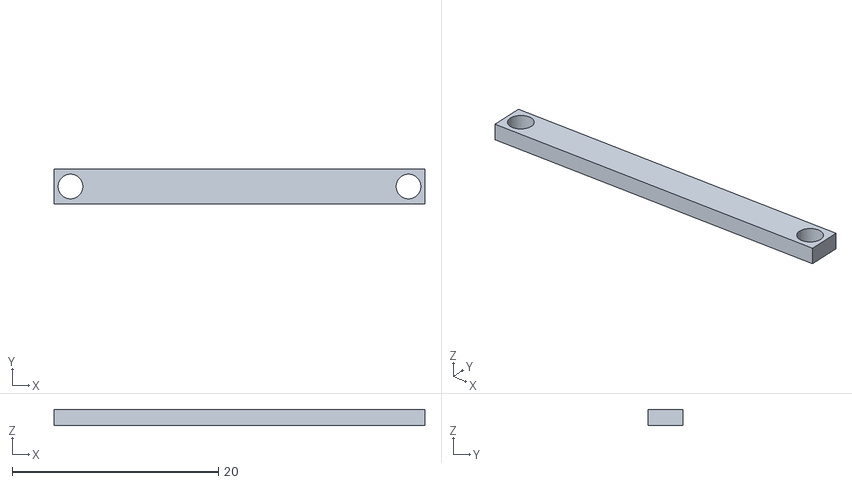
[picture p69: CAD file, 2026-10-29]
v3-mqtt-pocketbase/enclosure/recovery-20261018/research-adapters/thermal-rear-before-repair-20261019/pcb28x16_retainer_2.stl
36.0 x 3.40 x 1.60
