xkarma31-blip/pig-health-monitor/v3-mqtt-pocketbase/enclosure/recovery-20261018/revision-i/thermal_angled_hood.stl

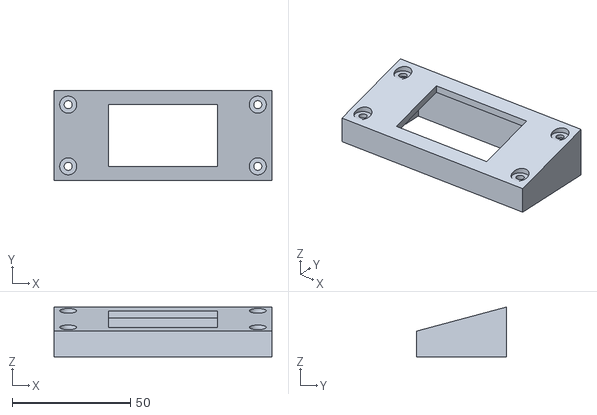
[picture p71: CAD file, 2026-10-29]
v3-mqtt-pocketbase/enclosure/recovery-20261018/revision-i/thermal_angled_hood.stl
92.0 x 38.0 x 21.1
