xkarma31-blip/pig-health-monitor/v3-mqtt-pocketbase/enclosure/recovery-20261018/revision-j/microphone_strap_carrier.stl

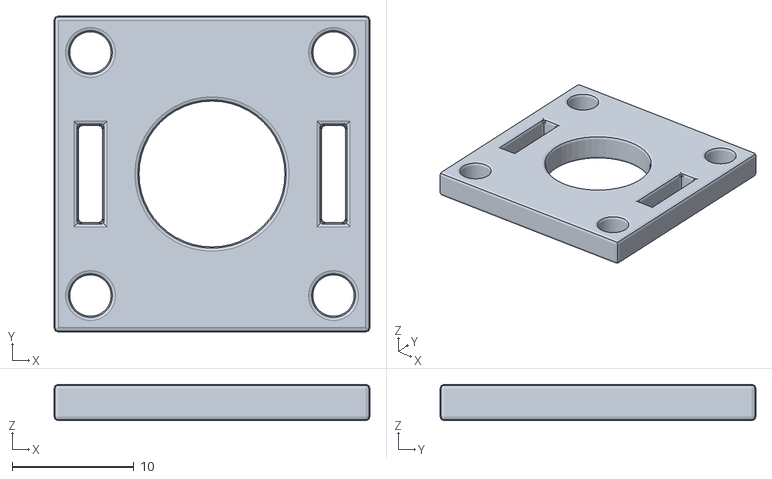
[picture p72: CAD file, 2026-10-29]
v3-mqtt-pocketbase/enclosure/recovery-20261018/revision-j/microphone_strap_carrier.stl
26.0 x 26.0 x 3.00
