xkarma31-blip/pig-health-monitor/v3-mqtt-pocketbase/enclosure/recovery-20261018/revision-l/optional_M3_hole_coupon.stl

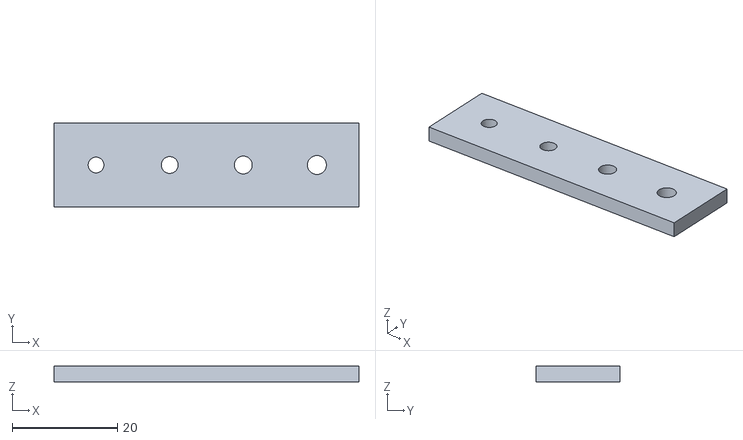
[picture p73: CAD file, 2026-10-29]
v3-mqtt-pocketbase/enclosure/recovery-20261018/revision-l/optional_M3_hole_coupon.stl
58.0 x 16.0 x 3.00
