xkarma31-blip/pig-health-monitor/v3-mqtt-pocketbase/enclosure/recovery-20261018/revision-n/thermal_face.stl

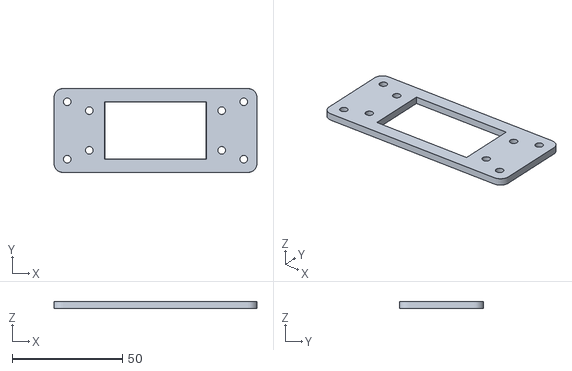
[picture p74: CAD file, 2026-10-29]
v3-mqtt-pocketbase/enclosure/recovery-20261018/revision-n/thermal_face.stl
92.0 x 38.0 x 3.00
