xkarma31-blip/pig-health-monitor/v3-mqtt-pocketbase/enclosure/recovery-20261018/research-adapters/pcb25_4square_rear_insert.stl

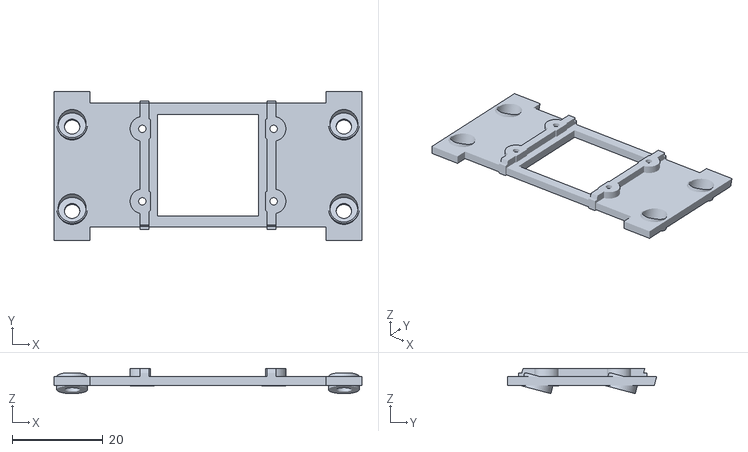
[picture p75: CAD file, 2026-10-29]
v3-mqtt-pocketbase/enclosure/recovery-20261018/research-adapters/pcb25_4square_rear_insert.stl
68.0 x 33.0 x 5.60
