xkarma31-blip/pig-health-monitor/v3-mqtt-pocketbase/enclosure/recovery-20261018/research-adapters/thermal-history-20261019T021506643508Z/pcb25_4square_retainer_2.stl

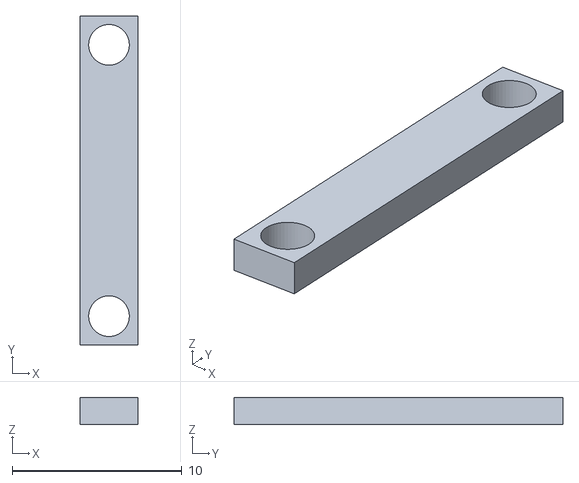
[picture p76: CAD file, 2026-10-29]
v3-mqtt-pocketbase/enclosure/recovery-20261018/research-adapters/thermal-history-20261019T021506643508Z/pcb25_4square_retainer_2.stl
3.40 x 19.4 x 1.60
