xkarma31-blip/pig-health-monitor/v3-mqtt-pocketbase/enclosure/recovery-20261018/research-adapters/thermal-history-20261019T021555087713Z/pcb25_4x17_78_retainer_1_historical_pre_flat_seat_20261019.stl

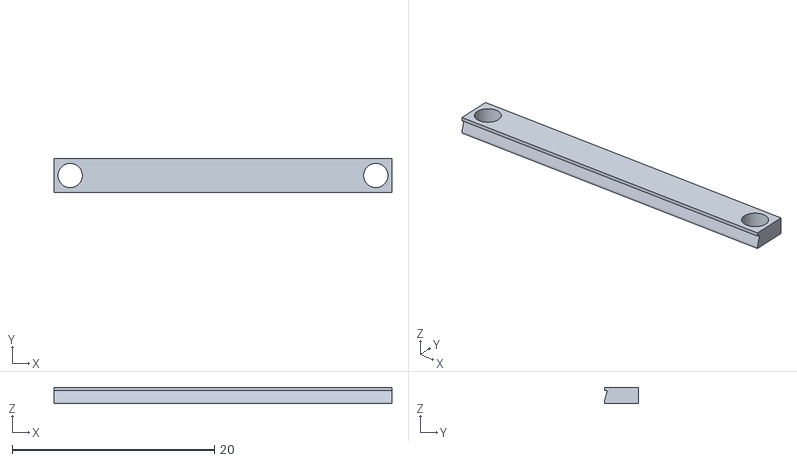
[picture p77: CAD file, 2026-10-29]
v3-mqtt-pocketbase/enclosure/recovery-20261018/research-adapters/thermal-history-20261019T021555087713Z/pcb25_4x17_78_retainer_1_historical_pre_flat_seat_20261019.stl
33.4 x 3.40 x 1.60
