xkarma31-blip/pig-health-monitor/v3-mqtt-pocketbase/enclosure/recovery-20261018/research-adapters/thermal-history-20261019T022157288901Z/pcb25_4x17_78_rear_insert.stl

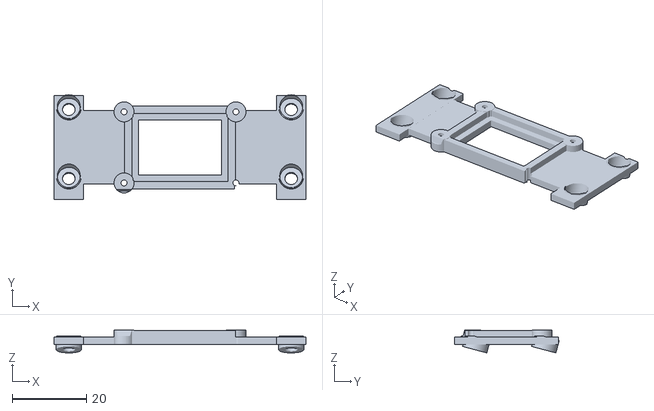
[picture p79: CAD file, 2026-10-29]
v3-mqtt-pocketbase/enclosure/recovery-20261018/research-adapters/thermal-history-20261019T022157288901Z/pcb25_4x17_78_rear_insert.stl
68.0 x 28.2 x 6.17
