xkarma31-blip/pig-health-monitor/v3-mqtt-pocketbase/enclosure/recovery-20261018/research-adapters/thermal-history-20261019T023311499525Z/pcb25_4square_retainer_2.stl

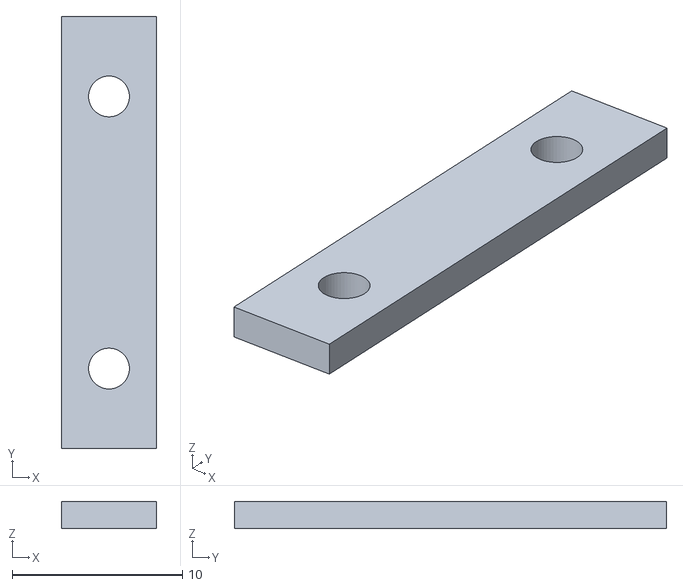
[picture p80: CAD file, 2026-10-29]
v3-mqtt-pocketbase/enclosure/recovery-20261018/research-adapters/thermal-history-20261019T023311499525Z/pcb25_4square_retainer_2.stl
5.60 x 25.4 x 1.60
