xkarma31-blip/pig-health-monitor/v3-mqtt-pocketbase/enclosure/recovery-20261018/revision-l/electronics_strap_tray.stl

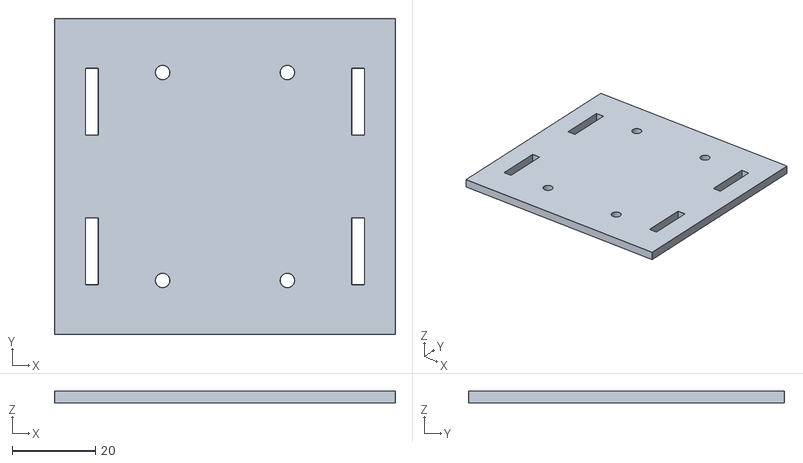
[picture p81: CAD file, 2026-10-29]
v3-mqtt-pocketbase/enclosure/recovery-20261018/revision-l/electronics_strap_tray.stl
82.0 x 76.0 x 3.00
