xkarma31-blip/pig-health-monitor/v3-mqtt-pocketbase/enclosure/recovery-20261018/revision-n/acoustic_tub.stl

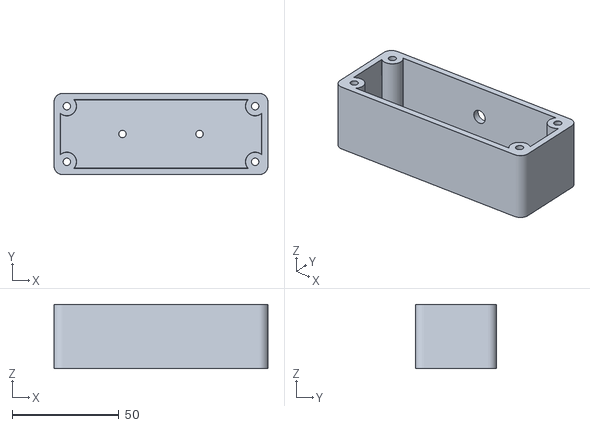
[picture p83: CAD file, 2026-10-29]
v3-mqtt-pocketbase/enclosure/recovery-20261018/revision-n/acoustic_tub.stl
100.0 x 38.0 x 30.0
