xkarma31-blip/pig-health-monitor/v3-mqtt-pocketbase/enclosure/stl/pigpulse_thermal_module_housing.stl

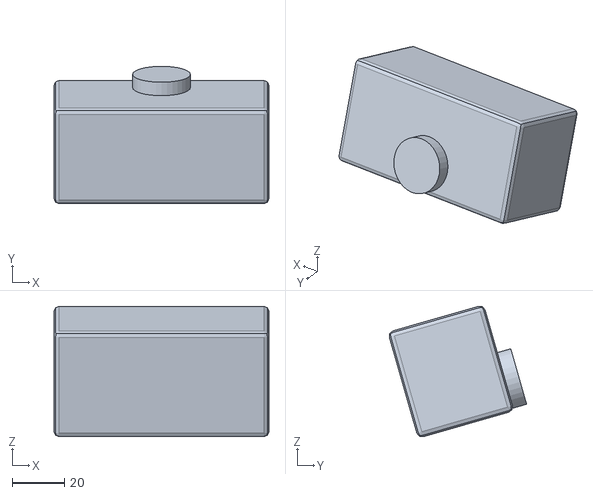
[picture p84: CAD file, 2026-10-29]
v3-mqtt-pocketbase/enclosure/stl/pigpulse_thermal_module_housing.stl
82.0 x 52.4 x 49.7
