xkarma31-blip/pig-health-monitor/v3-mqtt-pocketbase/enclosure/recovery-20261018/research-adapters/thermal-history-20261019T022420295853Z/pcb25_4x17_78_rear_insert_historical_pre_flat_seat_20261019.stl

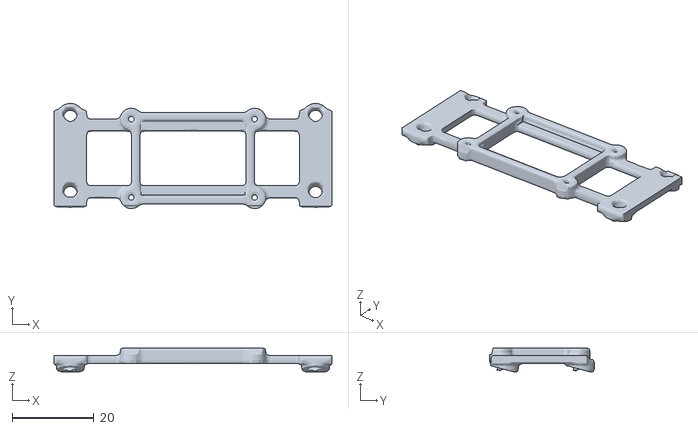
[picture p85: CAD file, 2026-10-29]
v3-mqtt-pocketbase/enclosure/recovery-20261018/research-adapters/thermal-history-20261019T022420295853Z/pcb25_4x17_78_rear_insert_historical_pre_flat_seat_20261019.stl
68.0 x 25.7 x 5.80
