xkarma31-blip/pig-health-monitor/v3-mqtt-pocketbase/enclosure/recovery-20261018/research-adapters/thermal_bridge_coupon.stl

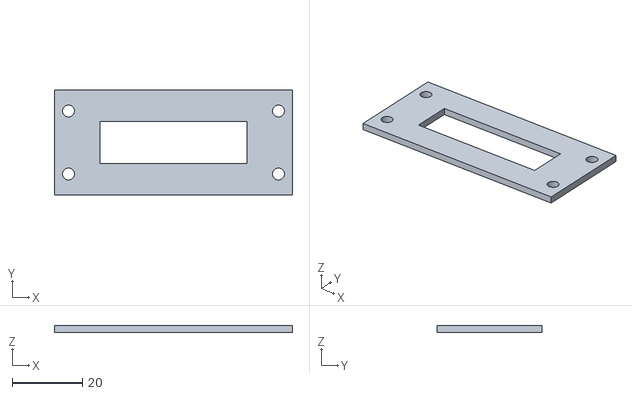
[picture p87: CAD file, 2026-10-29]
v3-mqtt-pocketbase/enclosure/recovery-20261018/research-adapters/thermal_bridge_coupon.stl
68.0 x 30.0 x 2.00
