xkarma31-blip/pig-health-monitor/v3-mqtt-pocketbase/enclosure/recovery-20261018/revision-p/tray_spacer_6mm.stl

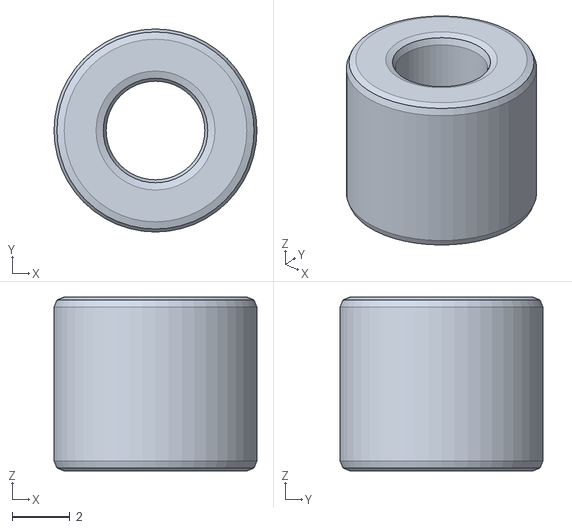
[picture p88: CAD file, 2026-10-29]
v3-mqtt-pocketbase/enclosure/recovery-20261018/revision-p/tray_spacer_6mm.stl
7.00 x 7.00 x 6.00
