xkarma31-blip/pig-health-monitor/v3-mqtt-pocketbase/enclosure/stl/pigpulse_pole_mounting_bracket.stl

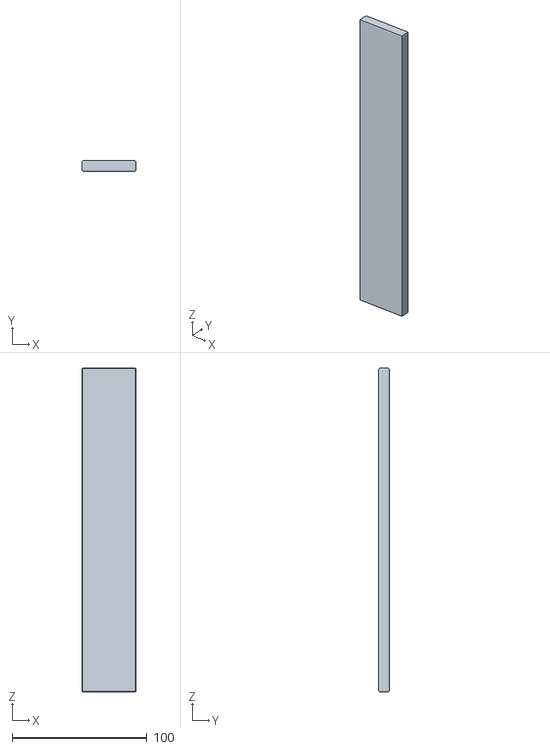
[picture p89: CAD file, 2026-10-29]
v3-mqtt-pocketbase/enclosure/stl/pigpulse_pole_mounting_bracket.stl
40.0 x 8.00 x 240.0
