xkarma31-blip/pig-health-monitor/v3-mqtt-pocketbase/enclosure/recovery-20261018/research-adapters/thermal-history-20261019T021506643508Z/pcb25_4x17_78_rear_insert.stl

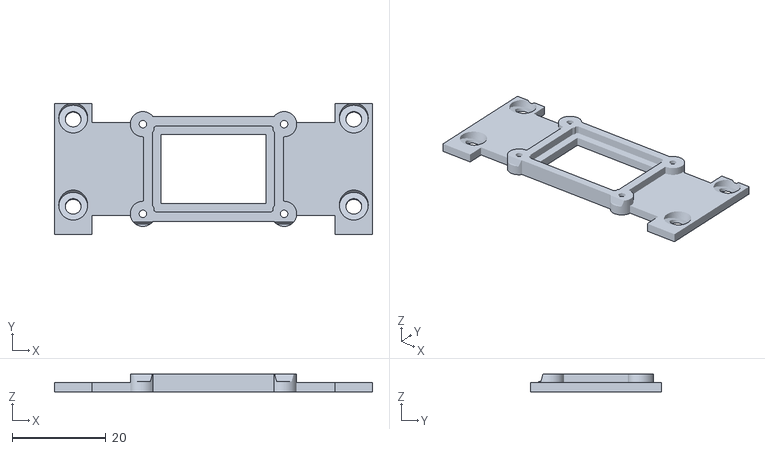
[picture p90: CAD file, 2026-10-29]
v3-mqtt-pocketbase/enclosure/recovery-20261018/research-adapters/thermal-history-20261019T021506643508Z/pcb25_4x17_78_rear_insert.stl
68.0 x 28.0 x 3.80
