xkarma31-blip/pig-health-monitor/v3-mqtt-pocketbase/enclosure/recovery-20261018/research-adapters/thermal-rear-before-repair-20261019/pcb28x16_rear_insert.stl

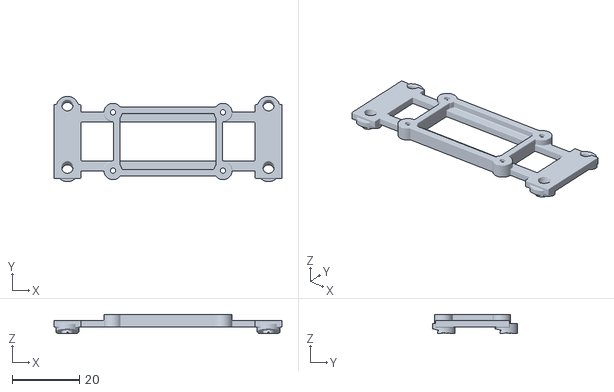
[picture p91: CAD file, 2026-10-29]
v3-mqtt-pocketbase/enclosure/recovery-20261018/research-adapters/thermal-rear-before-repair-20261019/pcb28x16_rear_insert.stl
68.0 x 25.4 x 5.80
