xkarma31-blip/pig-health-monitor/v3-mqtt-pocketbase/enclosure/recovery-20261018/revision-p/optical_trim.stl

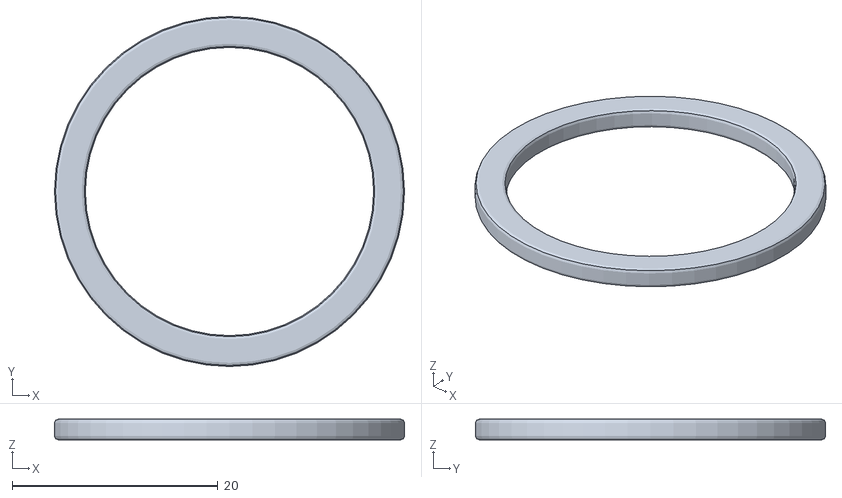
[picture p93: CAD file, 2026-10-29]
v3-mqtt-pocketbase/enclosure/recovery-20261018/revision-p/optical_trim.stl
34.0 x 34.0 x 2.00
