xkarma31-blip/pig-health-monitor/v3-mqtt-pocketbase/enclosure/recovery-20261018/research-adapters/thermal-rear-before-repair-20261019/pcb25_4square_retainer_1.stl

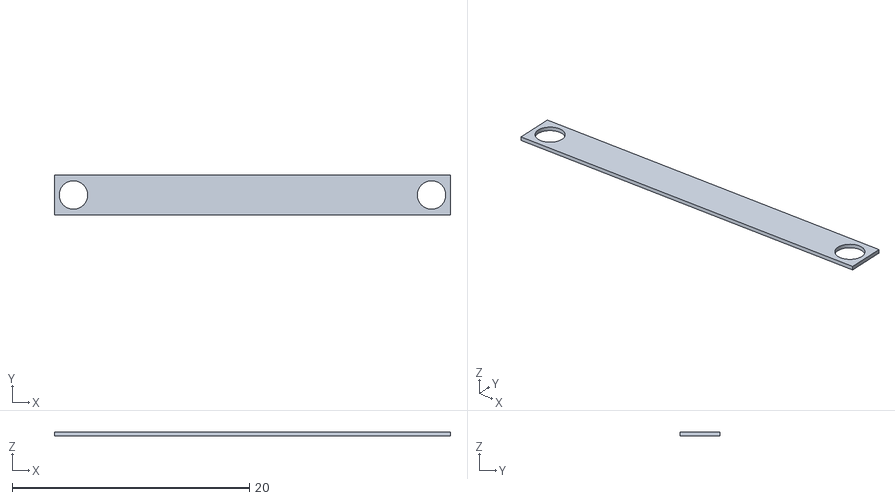
[picture p94: CAD file, 2026-10-29]
v3-mqtt-pocketbase/enclosure/recovery-20261018/research-adapters/thermal-rear-before-repair-20261019/pcb25_4square_retainer_1.stl
33.4 x 3.40 x 0.324
