xkarma31-blip/pig-health-monitor/v3-mqtt-pocketbase/enclosure/recovery-20261018/research-adapters/sht-18x12.7.stl

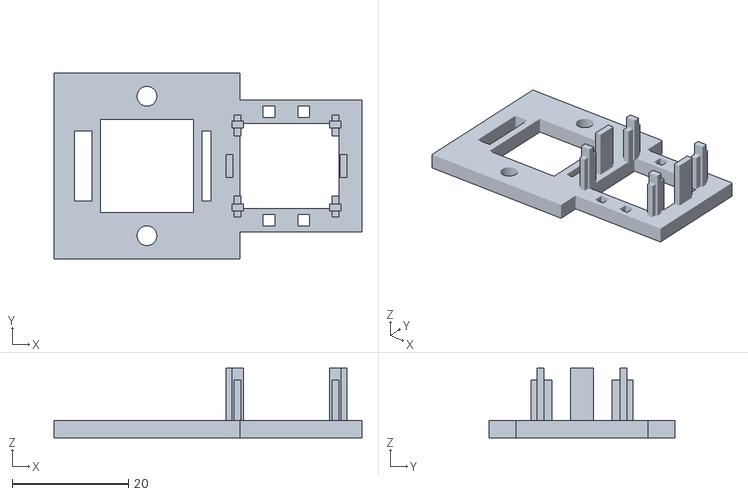
[picture p95: CAD file, 2026-10-29]
v3-mqtt-pocketbase/enclosure/recovery-20261018/research-adapters/sht-18x12.7.stl
53.0 x 32.0 x 12.0
