xkarma31-blip/pig-health-monitor/v3-mqtt-pocketbase/enclosure/recovery-20261018/research-adapters/mic_14x12_corner_support.stl

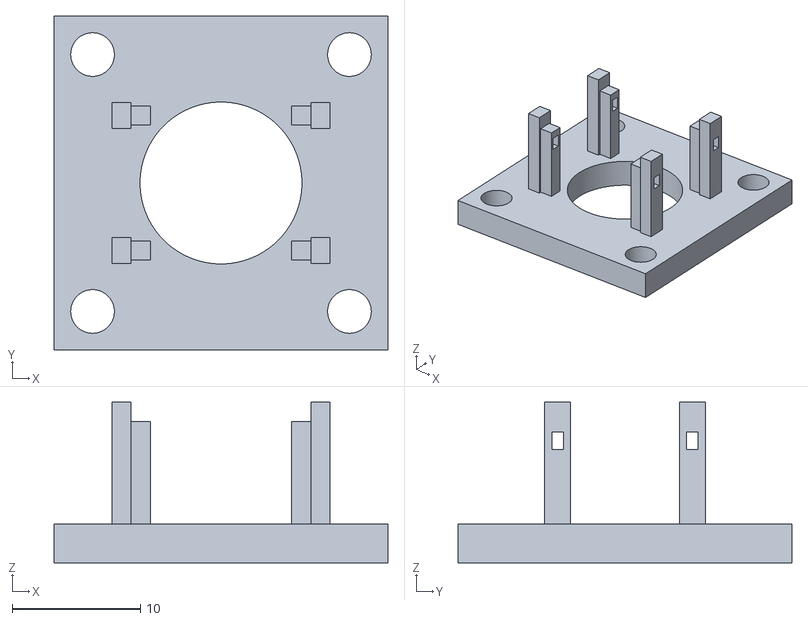
[picture p96: CAD file, 2026-10-29]
v3-mqtt-pocketbase/enclosure/recovery-20261018/research-adapters/mic_14x12_corner_support.stl
26.0 x 26.0 x 12.5
