xkarma31-blip/pig-health-monitor/v3-mqtt-pocketbase/enclosure/recovery-20261018/research-adapters/sht-25.5x17.7.stl

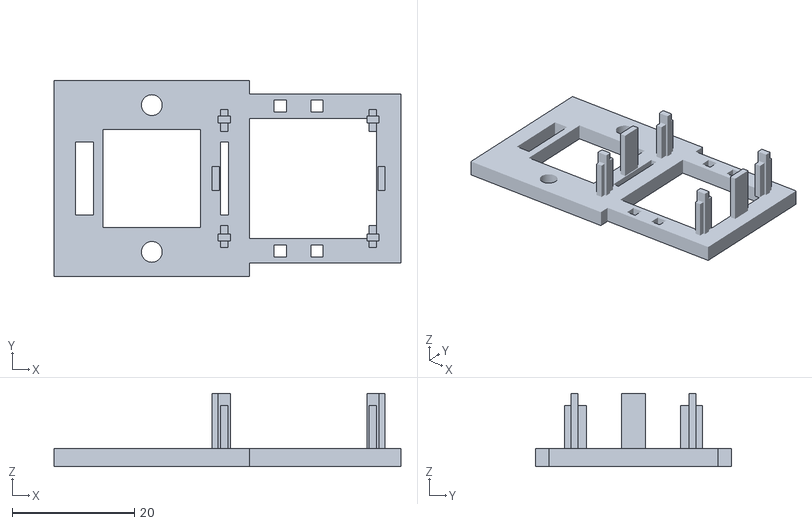
[picture p97: CAD file, 2026-10-29]
v3-mqtt-pocketbase/enclosure/recovery-20261018/research-adapters/sht-25.5x17.7.stl
56.8 x 32.0 x 12.0
