xkarma31-blip/pig-health-monitor/v3-mqtt-pocketbase/enclosure/recovery-20261018/research-adapters/mic_elevated_support.stl

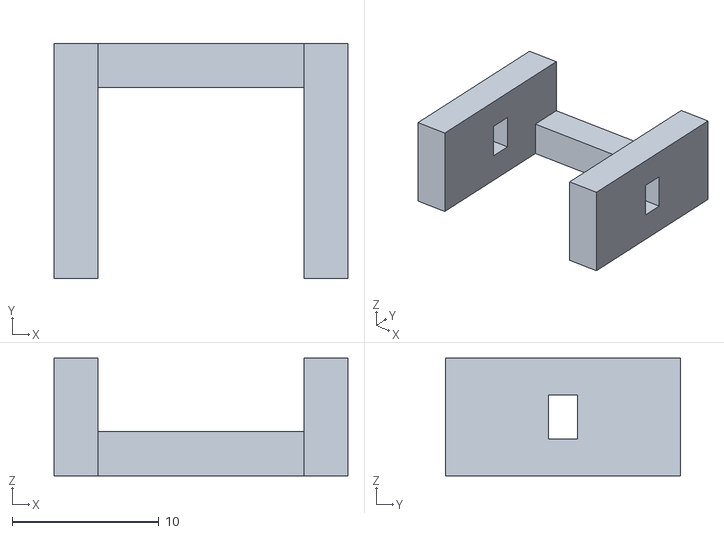
[picture p99: CAD file, 2026-10-29]
v3-mqtt-pocketbase/enclosure/recovery-20261018/research-adapters/mic_elevated_support.stl
20.0 x 16.0 x 8.00
