xkarma31-blip/pig-health-monitor/v3-mqtt-pocketbase/enclosure/recovery-20261018/research-adapters/sht_12mm_support_coupon.stl

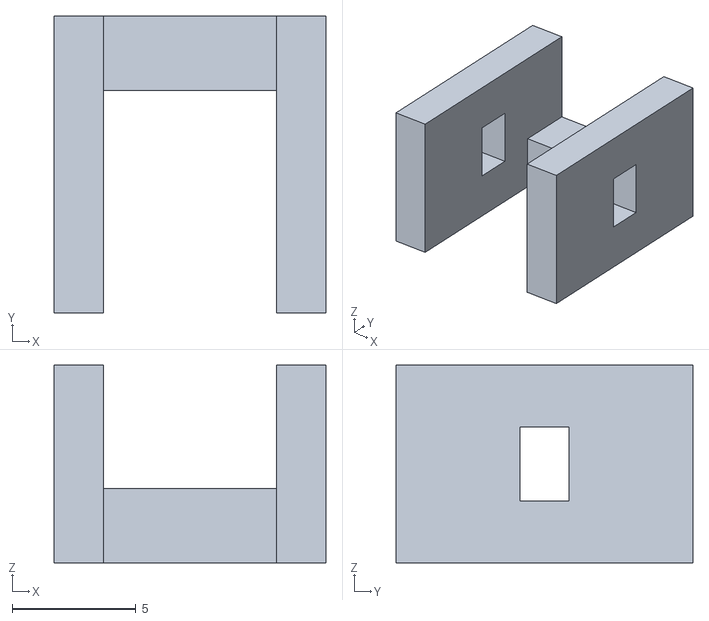
[picture p100: CAD file, 2026-10-29]
v3-mqtt-pocketbase/enclosure/recovery-20261018/research-adapters/sht_12mm_support_coupon.stl
11.0 x 12.0 x 8.00
