xkarma31-blip/pig-health-monitor/v3-mqtt-pocketbase/enclosure/recovery-20261018/research-adapters/sht_elevated_support.stl

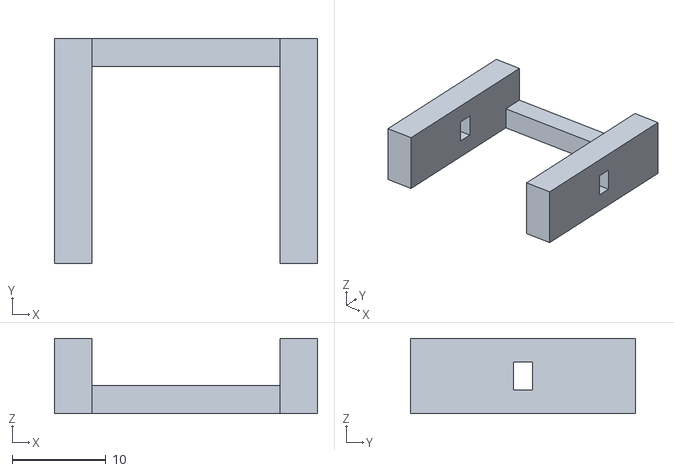
[picture p101: CAD file, 2026-10-29]
v3-mqtt-pocketbase/enclosure/recovery-20261018/research-adapters/sht_elevated_support.stl
28.0 x 24.0 x 8.00
