xkarma31-blip/pig-health-monitor/v3-mqtt-pocketbase/enclosure/recovery-20261018/research-adapters/optional_tray_spacer_3mm.stl

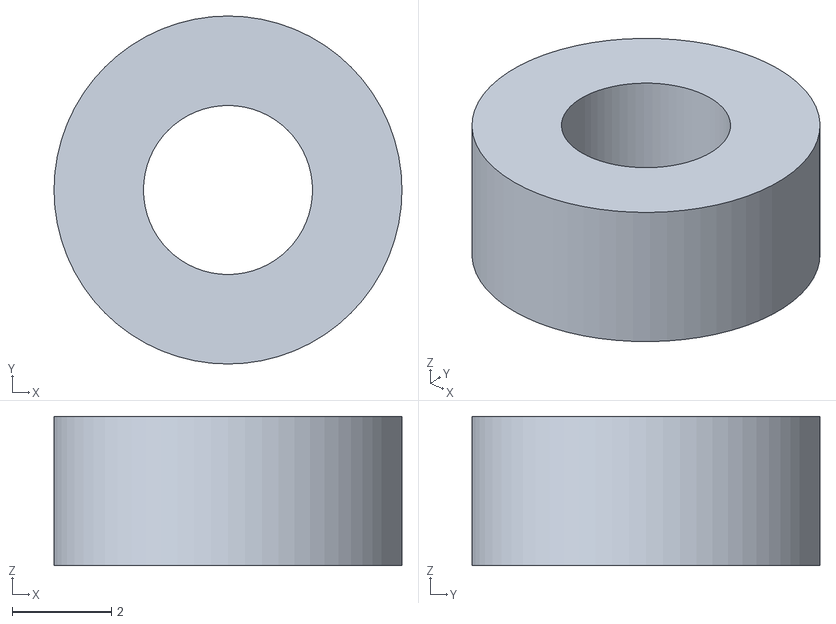
[picture p102: CAD file, 2026-10-29]
v3-mqtt-pocketbase/enclosure/recovery-20261018/research-adapters/optional_tray_spacer_3mm.stl
7.00 x 7.00 x 3.00
