xkarma31-blip/pig-health-monitor/v3-mqtt-pocketbase/enclosure/recovery-20261018/research-adapters/mic_14x12_support_coupon.stl

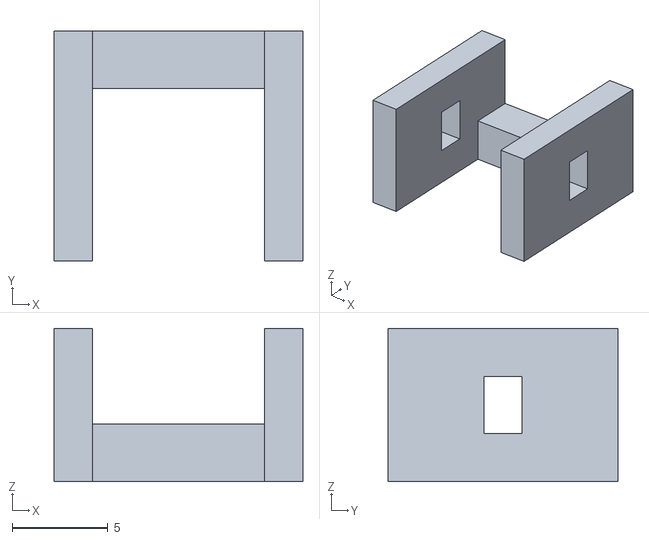
[picture p103: CAD file, 2026-10-29]
v3-mqtt-pocketbase/enclosure/recovery-20261018/research-adapters/mic_14x12_support_coupon.stl
13.0 x 12.0 x 8.00
