xkarma31-blip/pig-health-monitor/(list of files, cad)

Other CAD files:
v3-mqtt-pocketbase/enclosure/recovery-20261018/revision-o/split-boss-experiment/main_tub-concept.stl
v3-mqtt-pocketbase/enclosure/recovery-20261018/revision-p/pre-tool-access-repair/main_lid.stl
v3-mqtt-pocketbase/enclosure/recovery-20261018/revision-n/main_lid.stl
v3-mqtt-pocketbase/enclosure/recovery-20261018/revision-p/main_lid.stl
v3-mqtt-pocketbase/enclosure/recovery-20261018/research-adapters/thermal-history-20261019T022157288901Z/pcb28x16_rear_insert.stl
v3-mqtt-pocketbase/enclosure/recovery-20261018/research-adapters/thermal-history-20261019T022231743812Z/pcb25_4x17_78_retainer_1.stl
v3-mqtt-pocketbase/enclosure/recovery-20261018/research-adapters/thermal-history-20261019T022913135166Z/pcb25_4x17_78_rear_insert.stl
v3-mqtt-pocketbase/enclosure/recovery-20261018/revision-p/thermal_raised_cradle.stl
v3-mqtt-pocketbase/enclosure/recovery-20261018/research-adapters/thermal-history-20261019T021646325941Z/pcb28x16_retainer_1.stl
v3-mqtt-pocketbase/enclosure/recovery-20261018/research-adapters/thermal-history-20261019T021716680692Z/pcb28x16_retainer_2.stl
v3-mqtt-pocketbase/enclosure/recovery-20261018/research-adapters/thermal-history-20261019T021939795662Z/pcb25_4x17_78_retainer_2.stl
v3-mqtt-pocketbase/enclosure/recovery-20261018/research-adapters/thermal-history-20261019T022157288901Z/pcb25_4square_rear_insert.stl
v3-mqtt-pocketbase/enclosure/recovery-20261018/research-adapters/thermal-history-20261019T022231743812Z/pcb28x16_retainer_1.stl
v3-mqtt-pocketbase/enclosure/recovery-20261018/research-adapters/thermal-history-20261019T022913135166Z/pcb28x16_rear_insert.stl
v3-mqtt-pocketbase/enclosure/recovery-20261018/research-adapters/thermal-history-20261019T023105751739Z/pcb25_4x17_78_rear_insert.stl
v3-mqtt-pocketbase/enclosure/recovery-20261018/research-adapters/thermal-history-20261019T023311499525Z/pcb28x16_rear_insert.stl
v3-mqtt-pocketbase/enclosure/recovery-20261018/research-adapters/thermal-rear-preserved-20261019-start/pcb28x16_retainer_1.stl
v3-mqtt-pocketbase/enclosure/recovery-20261018/revision-o/mounting_spine.stl
v3-mqtt-pocketbase/enclosure/recovery-20261018/revision-p/microphone_strap_carrier.stl
v3-mqtt-pocketbase/enclosure/recovery-20261018/research-adapters/thermal-history-20261019T021646325941Z/pcb25_4square_rear_insert.stl
v3-mqtt-pocketbase/enclosure/recovery-20261018/research-adapters/thermal-history-20261019T021939795662Z/pcb28x16_retainer_2.stl
v3-mqtt-pocketbase/enclosure/recovery-20261018/research-adapters/thermal-history-20261019T022231743812Z/pcb25_4x17_78_rear_insert.stl
v3-mqtt-pocketbase/enclosure/recovery-20261018/research-adapters/thermal-history-20261019T022420295853Z/pcb25_4square_rear_insert.stl
v3-mqtt-pocketbase/enclosure/recovery-20261018/research-adapters/thermal-history-20261019T022913135166Z/pcb25_4x17_78_retainer_2.stl
v3-mqtt-pocketbase/enclosure/recovery-20261018/research-adapters/thermal-history-20261019T023105751739Z/pcb25_4square_retainer_2.stl
v3-mqtt-pocketbase/enclosure/recovery-20261018/research-adapters/thermal-rear-before-repair-20261019/pcb25_4x17_78_retainer_2.stl
v3-mqtt-pocketbase/enclosure/recovery-20261018/research-adapters/thermal-rear-preserved-20261019-start/pcb25_4square_retainer_2.stl
v3-mqtt-pocketbase/enclosure/recovery-20261018/revision-o/thermal_angled_hood.stl
v3-mqtt-pocketbase/enclosure/recovery-20261018/research-adapters/pcb25_4x17_78_retainer_2.stl
v3-mqtt-pocketbase/enclosure/recovery-20261018/research-adapters/thermal-history-20261019T021506643508Z/pcb25_4square_retainer_1.stl
v3-mqtt-pocketbase/enclosure/recovery-20261018/research-adapters/thermal-history-20261019T021646325941Z/pcb25_4x17_78_retainer_2.stl
v3-mqtt-pocketbase/enclosure/recovery-20261018/research-adapters/thermal-history-20261019T021716680692Z/pcb25_4square_retainer_2.stl
v3-mqtt-pocketbase/enclosure/recovery-20261018/research-adapters/thermal-history-20261019T021939795662Z/pcb25_4x17_78_rear_insert.stl
v3-mqtt-pocketbase/enclosure/recovery-20261018/research-adapters/thermal-history-20261019T022157288901Z/pcb25_4x17_78_retainer_1.stl
v3-mqtt-pocketbase/enclosure/recovery-20261018/research-adapters/thermal-history-20261019T022231743812Z/pcb28x16_retainer_2.stl
v3-mqtt-pocketbase/enclosure/recovery-20261018/research-adapters/thermal-history-20261019T022420295853Z/pcb25_4square_retainer_1.stl
v3-mqtt-pocketbase/enclosure/recovery-20261018/research-adapters/thermal-history-20261019T022913135166Z/pcb25_4square_rear_insert.stl
v3-mqtt-pocketbase/enclosure/recovery-20261018/research-adapters/thermal-history-20261019T023105751739Z/pcb25_4square_retainer_1.stl
v3-mqtt-pocketbase/enclosure/recovery-20261018/research-adapters/thermal-history-20261019T023311499525Z/pcb25_4square_rear_insert.stl
v3-mqtt-pocketbase/enclosure/recovery-20261018/research-adapters/thermal-rear-before-repair-20261019/pcb25_4x17_78_retainer_1.stl
v3-mqtt-pocketbase/enclosure/recovery-20261018/research-adapters/thermal-rear-preserved-20261019-start/pcb28x16_retainer_2.stl
v3-mqtt-pocketbase/enclosure/recovery-20261018/revision-h/thermal_angled_hood.stl
v3-mqtt-pocketbase/enclosure/recovery-20261018/revision-o/thermal_tub.stl
v3-mqtt-pocketbase/enclosure/recovery-20261018/research-adapters/thermal-history-20261019T021506643508Z/pcb28x16_retainer_2.stl
v3-mqtt-pocketbase/enclosure/recovery-20261018/research-adapters/thermal-history-20261019T021555087713Z/pcb25_4square_retainer_1.stl
v3-mqtt-pocketbase/enclosure/recovery-20261018/research-adapters/thermal-history-20261019T021716680692Z/pcb25_4square_retainer_1.stl
v3-mqtt-pocketbase/enclosure/recovery-20261018/research-adapters/thermal-history-20261019T021939795662Z/pcb25_4square_rear_insert.stl
v3-mqtt-pocketbase/enclosure/recovery-20261018/research-adapters/thermal-history-20261019T022157288901Z/pcb25_4x17_78_retainer_2_historical_pre_flat_seat_20261019.stl
v3-mqtt-pocketbase/enclosure/recovery-20261018/research-adapters/thermal-history-20261019T022231743812Z/pcb28x16_rear_insert.stl
v3-mqtt-pocketbase/enclosure/recovery-20261018/research-adapters/thermal-history-20261019T023311499525Z/pcb25_4square_retainer_1.stl
v3-mqtt-pocketbase/enclosure/recovery-20261018/research-adapters/thermal-rear-before-repair-20261019/pcb28x16_retainer_1.stl
v3-mqtt-pocketbase/enclosure/recovery-20261018/research-adapters/pcb28x16_rear_insert.stl
v3-mqtt-pocketbase/enclosure/recovery-20261018/research-adapters/thermal-history-20261019T021716680692Z/pcb25_4x17_78_rear_insert.stl
v3-mqtt-pocketbase/enclosure/recovery-20261018/research-adapters/thermal-history-20261019T022157288901Z/pcb25_4square_retainer_1.stl
v3-mqtt-pocketbase/enclosure/recovery-20261018/research-adapters/thermal-history-20261019T022231743812Z/pcb25_4square_rear_insert.stl
v3-mqtt-pocketbase/enclosure/recovery-20261018/research-adapters/thermal-history-20261019T022420295853Z/pcb25_4x17_78_rear_insert.stl
v3-mqtt-pocketbase/enclosure/recovery-20261018/research-adapters/thermal-history-20261019T023311499525Z/pcb25_4x17_78_retainer_1.stl
v3-mqtt-pocketbase/enclosure/recovery-20261018/research-adapters/pcb25_4x17_78_retainer_1.stl
v3-mqtt-pocketbase/enclosure/recovery-20261018/research-adapters/thermal-history-20261019T021506643508Z/pcb28x16_retainer_1.stl
v3-mqtt-pocketbase/enclosure/recovery-20261018/research-adapters/thermal-history-20261019T022157288901Z/pcb25_4square_retainer_2.stl
v3-mqtt-pocketbase/enclosure/recovery-20261018/research-adapters/thermal-history-20261019T023311499525Z/pcb28x16_retainer_1.stl
v3-mqtt-pocketbase/enclosure/recovery-20261018/research-adapters/thermal-rear-before-repair-20261019/pcb25_4x17_78_rear_insert.stl
v3-mqtt-pocketbase/enclosure/recovery-20261018/research-adapters/pcb28x16_retainer_1.stl
v3-mqtt-pocketbase/enclosure/recovery-20261018/research-adapters/thermal-history-20261019T021506643508Z/pcb25_4x17_78_retainer_2.stl
v3-mqtt-pocketbase/enclosure/recovery-20261018/research-adapters/thermal-rear-before-repair-20261019/pcb25_4square_retainer_2.stl
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
