xkarma31-blip/pig-health-monitor/v3-mqtt-pocketbase/enclosure/recovery-20261018/research-adapters/combined-research-installed.png

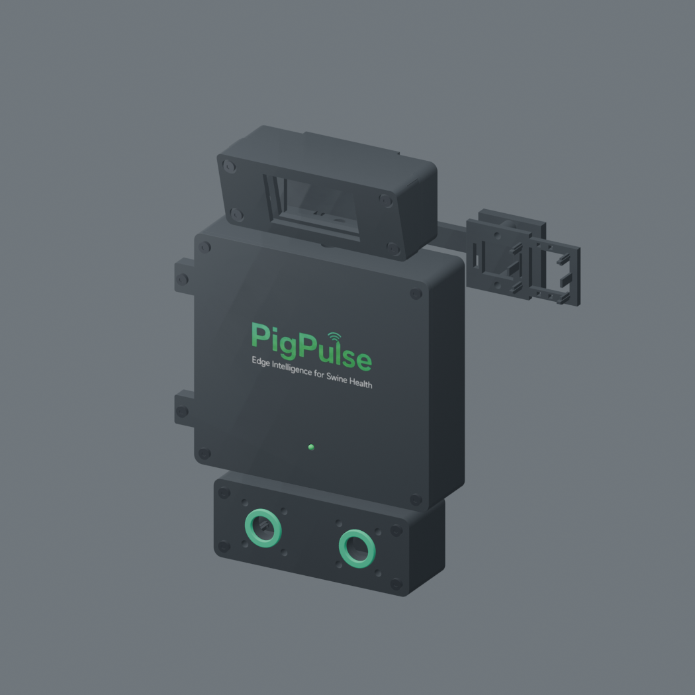
v3-mqtt-pocketbase/enclosure/recovery-20261018/research-adapters/combined-research-installed.png
