xkarma31-blip/pig-health-monitor/v3-mqtt-pocketbase/enclosure/recovery-20261018/revision-p/front-and-rear-assembly.png

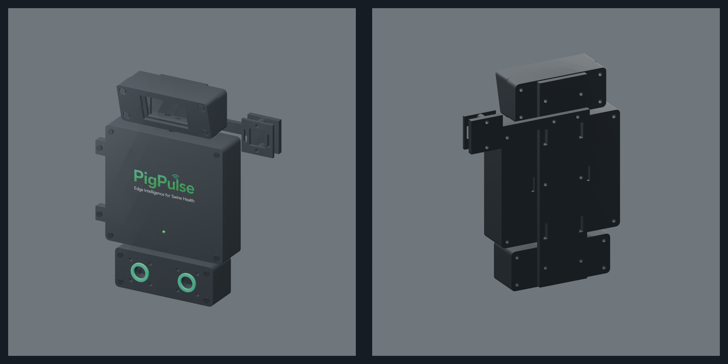
v3-mqtt-pocketbase/enclosure/recovery-20261018/revision-p/front-and-rear-assembly.png
