xkarma31-blip/pig-health-monitor/v3-mqtt-pocketbase/firmware/esp32s3-mic-ambient/docs/wiring/WIRING-diagram.png

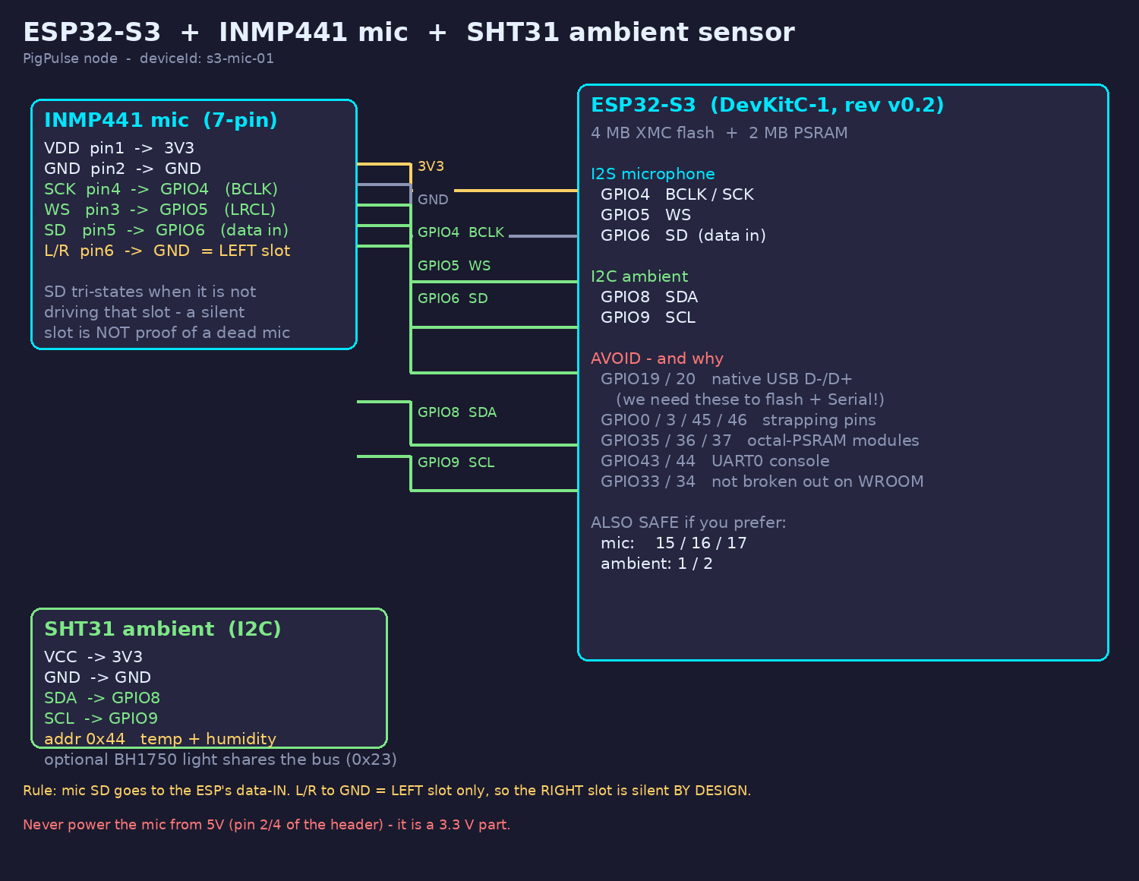
v3-mqtt-pocketbase/firmware/esp32s3-mic-ambient/docs/wiring/WIRING-diagram.png
