xkarma31-blip/pig-health-monitor/v3-mqtt-pocketbase/enclosure/recovery-20261018/revision-e/VERIFIED_CHECKPOINT.md

# Revision E verification checkpoint — goal remains active

Plugin budget was explicitly raised to 100 continuations, 1,000,000 context-token
threshold and 4 hours on user authorization. Model context remains finite.

## Completed digital checks

- 14 construction meshes pass manifold-edge/positive-volume gate.
- Independent `node check_exports.js revision-e` passes all 14 binary STLs:
  exact welded component count 1, every edge used twice, positive signed volume,
  exported bounds matching Blender within 0.01mm.
- This second check CAUGHT a hood defect missed by the Blender check. Fixed by
  replacing overlapping boolean/post construction with continuous screw regions.
- Real PrusaSlicer 2.7.2 sliced all 14 STLs to G-code with exit 0.
- Profile: assumed 220×220 bed, 0.4 nozzle, 0.2 layers, 4 perimeters, 20% infill,
  PETG 235 C, bed 80 C. All other defaults remain; NOT user-printer-approved G-code.
- Hood unsupported slice explicitly WARNED of collapsing overhang. Re-sliced with
  buildplate-only supports: support-generation log and supported G-code retained;
  that run has no printed stability warning. Do not claim supportless hood printing.
- Real vision route inspected current render: logo is upright/readable and top
  hood visibly angled. It flagged apparent gaps at module mating surfaces and
  side SHT arm asymmetry. Treat these as findings to investigate, not a fidelity pass.

## Hardware research

Web results identify inconsistent SuperMini reference lengths:
https://artofcircuits.com/product/esp32-s3-supermini-wifi-bluetooth-5-le-development-board
lists 22.5×18×4.32mm without headers, while
https://www.espboards.dev/esp32/esp32-s3-super-mini/ lists 23.5×18mm.
Neither is a measurement of the user's board. Keep adjustable tray, no claimed fit.
https://easyelecmodule.com/product/inmp441-mems-microphone-module-i2s-interface/
lists one module 14×14×11mm; not identification of fitted module.
INMP441 chip package 4.72×3.76×1mm is NOT breakout dimensions.

## Next concrete fixes

1. Numerically check actual main/lid planes and thermal stack rather than believing
   or dismissing visual gap report; add assembly intersections and hole alignment.
2. Improve logo/subtitle using approved source, readable lighting and close-up.
3. Complete sensor retention and acoustic/thermal aperture alignment as adjustable
   mounts with explicit assumptions. GY-SHT model still unknown; carrier is open,
   attached to bolted offset arm, not a sealed simulated sensor.
4. Add grounded BOM, bolt stack/length assumptions, assembly instructions, source
   comparison sheet and final supported slicing evidence/summary.
5. Read-only independent review if available (delegation attempts failed; do not
   fabricate subagent review). No physical testing or IP claims.
