xkarma31-blip/pig-health-monitor/docs/pigpulse-thermal-test-pinout.png

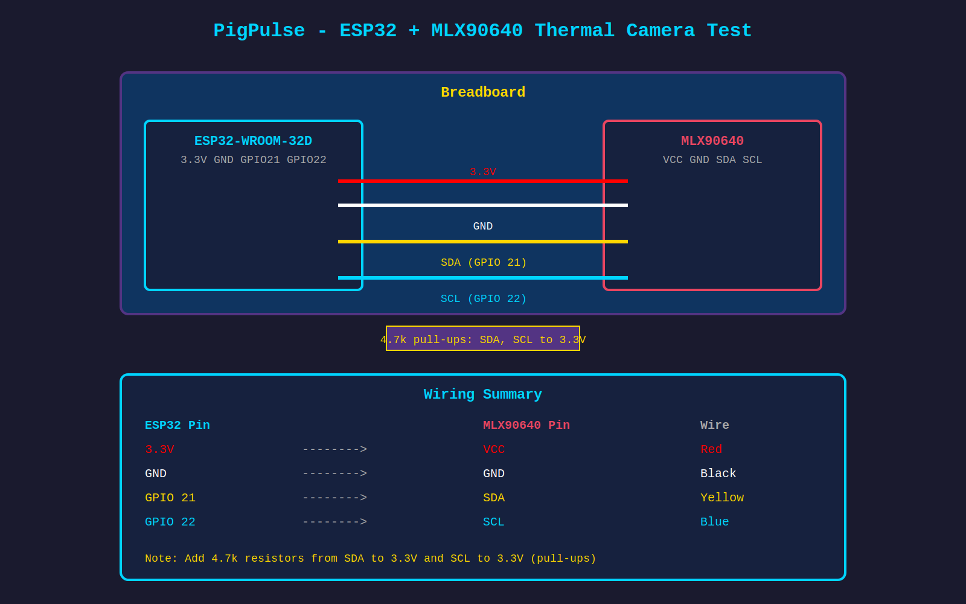
docs/pigpulse-thermal-test-pinout.png
