xkarma31-blip/pig-health-monitor/scripts/test/screenshot.png

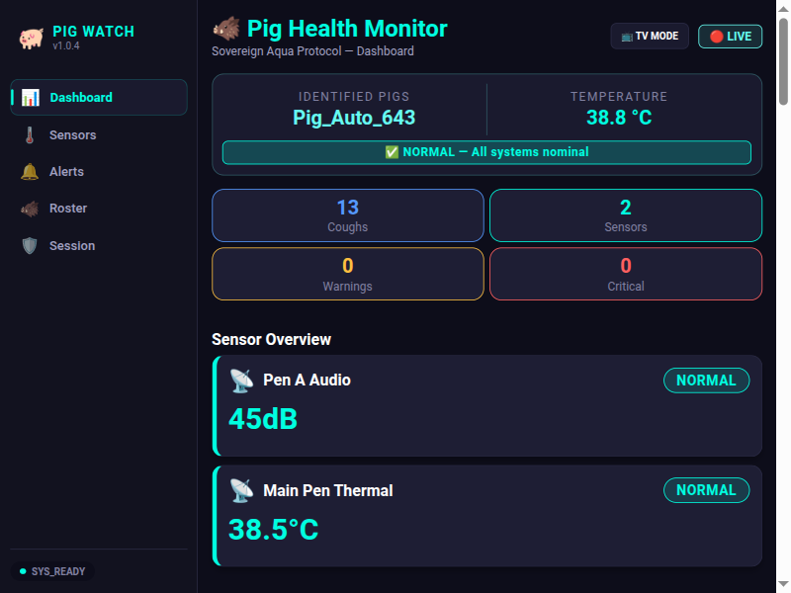
scripts/test/screenshot.png
