xkarma31-blip/pig-health-monitor/v3-mqtt-pocketbase/enclosure/recovery-20261018/revision-p/REPAIR_EVIDENCE.md

# Concrete repair evidence and limits

## Independent findings addressed

O microphone strap channels retained unchanged: preserved N had pinched face-side
route; O/P have measured straight relief. Negative control now requires actual
valid obstructed N surface hits, not ray misses. Summary validates all18 sample
coordinates, floor ranges, clearances and outcomes as well as STL hashes.
Seven malformed-report controls reject; valid report passes. This does not prove
actual strap bend/head/board compatibility.

Focused image review identified paired side bosses absent from O. Independent
mechanical review supported real supplementary split-bolt closure as a functional
interpretation, not an invented hinge. P adds matched ears and two M3 through
bores without changing the other15 distinct exports. Existing corner bolts remain.

Independent experiment audit identified unsupported nut-seat risk from all-edge
bevel. Actual ray tests reproduced failures at both lower seats. Rounding only
vertical ear edges repaired them: four bearing footprints,96 sampled rays each,
pass on re-imported STLs. Whole-assembly collision checks and limited hardware
envelopes pass. Sampled lift is not a continuous removal proof or physical access.

First tub-ear slice warned of floating bridge anchors. Buildplate supports were
enabled for P main tub; subsequent17-part slice summary passes. Support removal,
layer strength and dimensional fit remain physically untested.

## Honest remaining boundary

Source raster brand/tagline, charcoal stack and mint accents are retained.
Image reviewers disagree about connector and acoustic details; those contradictions
are preserved, not converted into speculative mechanisms. Thermal fitted sensor,
acoustic local gasket, complete strap routes and actual SHT retention require
specific measured component geometry. They are unfinished integration CAD, not
merely tests waiting for a finished product. No claim of exact replica, IP rating,
sensor performance, mounting load or barn readiness is made.

## Installed rear-tool access repair

Full printable-inventory check reproduced81.23mm³ tool/wall overlap at each
former X=-64 bolt station under an assumed10mm-diameter rear tool. Failing
STLs/report preserved in pre-tool-access-repair/. New X=-65.5 axes and
14mm-wide ears clear tested tool,nut,head/washer and front-driver cylinders.
Six sampled lid lifts against other installed printable parts pass. Purchased
hardware/electronics and continuous removal path remain excluded.
