xkarma31-blip/pig-health-monitor/v3-mqtt-pocketbase/enclosure/recovery-20261018/revision-p/repaired-final-visual-review.txt

[0m
> reviewer · ag/gemini-3.8-flash-low
Based on a strict visual inspection of the revised 3D render (Image 2) compared directly against the reference design infographic (Image 1), here are the findings:

---

### 1. Visible Source Branding & Readability
- **Logo & Typography**: "PigPulse" and the subtitle "Edge Intelligence for Swine Health" match the reference graphic in font family, layout, and placement across the front face.
- **Iconography**: The three-arc broadcast icon over the letter 'u' in "PigPulse" is clearly defined and rendered.
- **Legibility**: Sharp, high contrast against the dark enclosure faceplate, and fully legible without blur or distortion.
- **Status Indicator**: The small circular green LED/indicator beneath the text is present, positioned, and shaded cleanly.

---

### 2. Side Bolt Ear Integration & Fastener Detailing
- **Screw Heads on Ears**: The revised side bolt ears (flanges protruding along the left edge of the main body) now clearly feature circular fastener heads with modeled cross/slotted drive recesses rather than flat/solid bosses.
- **Enclosure Fasteners**:
  - The corner screw heads on the front face of the main body, the acoustic module face, and the thermal module hood are all present and visually consistent with socket/recessed fasteners.
- **Ear Geometry & Alignment**:
  - The two left-side ears project perpendicularly from the casing as intended.
  - *Observation*: Only the left-side ears are visible at this viewing angle; right-side ears (if symmetrical) are occluded by the main body or omitted on that wall due to the wall-mount bracket attachment on the upper right rear.

---

### 3. Clear Render Defects & Visual Artifacts
- **Module Separation / Floating Gap**:
  - The top thermal module and bottom acoustic module appear completely disconnected and floating in mid-air above and below the main chassis. 
  - There are no visible interconnecting standoffs, coupling necks, or wire conduits bridging the gaps between the modules.
- **Top Window / Cavity Geometry**:
  - Inside the top thermal module opening, the inner framing shows an abrupt intersecting polygon / open interior plane without a clear lens surface, sealing bezel, or sensor housing.
- **Right Rear Mounting Bracket Alignment**:
  - The mounting flange arm attaches to the upper rear right corner, but the transition/joint into the main body lacks a defined junction fillet or mounting plate boss, looking like intersecting raw box primitives.

---

### 4. Connector Inset vs. Assembled Couplings
- **Status: Uncertain**
  - From this specific camera angle, elevation, and shading, the top and bottom mating surfaces of the main body and the facing surfaces of the satellite modules are heavily occluded by perspective.
  - Whether waterproof barrel connectors, threaded collars, or inset receptacles exist in the module gaps cannot be determined from this view without speculative inferencing.
