xkarma31-blip/pig-health-monitor/v3-mqtt-pocketbase/firmware/esp32s3-mic-ambient/docs/MIC_FIX_20261013.md

# ESP microphone repair — 2026-10-13

## Measured before changes

- Device readout: ESP32-S3 rev v0.2, MAC 68:ee:8f:dd:31:3c, embedded 4MB flash.
- Full flash backup: `/tmp/opencode/esp-before-fix.bin` (4,194,304 bytes).
- Real Pi `/esp/record?seconds=3` capture: 144025 stereo frames, L=R throughout,
  min -32768, max 32766, RMS 18913, successive-sample roughness 1.403.
- USB telemetry instead reported 24-bit RMS 125894–609633. Nonzero bytes alone
  were therefore not proof of usable audio.
- Existing source casts `(rawBuffer[i] >> 8)` to int16, keeping low 16 bits of
  a 24-bit sample. Correct conversion keeps the signed top 16 bits (`>>16`).
- Running flash contains the diagnostic strings in the read-only reference
  `/home/solrahk/Arduino/esp32s3_mic_telemetry/esp32s3_mic_telemetry.ino`.
  That reference has the same conversion fault. Deploy only from the canonical
  repo, not that alternate source.
- Browser live dashboard: AudioWorklet context running, 305152 rendered frames,
  52643 underrun samples, no JS exceptions. Audible quality not yet verified.
- Thermal temporarily lost I2C address 0x33 before any Pi change. Later recovered
  unaided: valid frame 5137 at 1.85 FPS. No Pi service restart or edit performed.

## Changes and checks

- Correct PCM conversion; regression test fails on old expression and passes
  on fixed expression: `node ../arduino/esp32s3_telemetry/test_pcm_conversion.cjs`.
- Preserve running board's USB CDC console and 8.5 dBm TX setting in canonical
  build. Canonical firmware is simpler than the reference (no retained audio
  format announcement or detailed network diagnostics).
- Build initially failed due to root-owned source directory and interrupted
  framework installation. Directory ownership corrected; incomplete package
  moved into sandbox for recovery, not deleted.

## Live verification and deployment

- User approved preserving reconnect behavior and reliability fixes. Canonical
  source now retains WiFi retry, rate-limited MQTT retry, retained wire-format
  announcement, and 24-bit diagnostics. Disabled USB recorder was not imported.
- Corrected PubSubClient boolean success handling and format-publish retry.
- Actual flash header mismatch caused first deployment to reboot: `4096k`
  hardware versus `8192k` image. Use `board_upload.flash_size = 4MB`, NOT
  `board_build.flash_size`. Successful upload hashes verified by esptool.
- Local reference firmware.bin matches original flash application bytes exactly.
  Aligned Arduino framework to 2.0.17 (PlatformIO espressif32 7.0.1).
- WiFi failed on both new firmware and full original-flash rollback. ESP scan:
  Pi BSSID DC:A6:32:87:63:A1, channel 6, RSSI -21 dBm; auth reason 2/202.
  Pi `iw station dump` incorrectly retained old authenticated ESP association.
  Clearing ONLY that station (`iw dev wlan0 station del 68:ee:8f:dd:31:3c`)
  restored WiFi, TCP and MQTT. No AP or thermal-service restart.
- Corrected firmware announced `pigpulse-mic-pcm16-20261013` through retained
  `pig/s3-mic-01/audio/fmt`; serial reports all three links connected.
- Real post-fix WAV: 144231 frames (3.005s), min -3322, max 5151,
  RMS 932.907, L=R 100%, roughness 0.126 (before: 1.403).
- Chromium on LIVE Pi dashboard: AudioWorklet running, 294912 rendered frames;
  output-node analyser RMS 0.021451, peak 0.137512, 247808 samples inspected,
  no JS exceptions. Browser thermal display live at frame 9298, about 2 FPS.
- Thermal service PID remained 1494. No Pi source files changed.

## Limits / follow-up

User confirmed recognizable live audio: “clear enough”, with residual static.
Do not assume static is normal or claim noise-free playback. Worklet underruns remain (39578 samples in this
run) and long-duration/network-loss soak tests are not done. WiFi stale station
recovery is manual, not automatically fixed in hostapd. Dashboard 100% bars
represent nonzero sample percentage, not acoustic amplitude. User approved a
dated measured-facts update to CANON.md; old USB-wedged status is historical.
