xkarma31-blip/pig-health-monitor/scripts/test/debug_auth.png

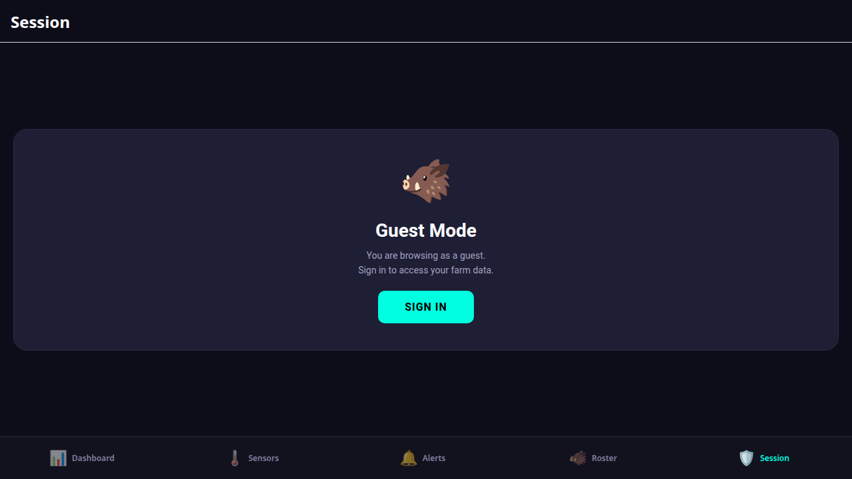
scripts/test/debug_auth.png
