xkarma31-blip/pig-health-monitor/downloads/esp32-mlx90640-thermal-camera/schematic.pdf

# Buck-Boost Converter (3.3V) ESP32 MCU

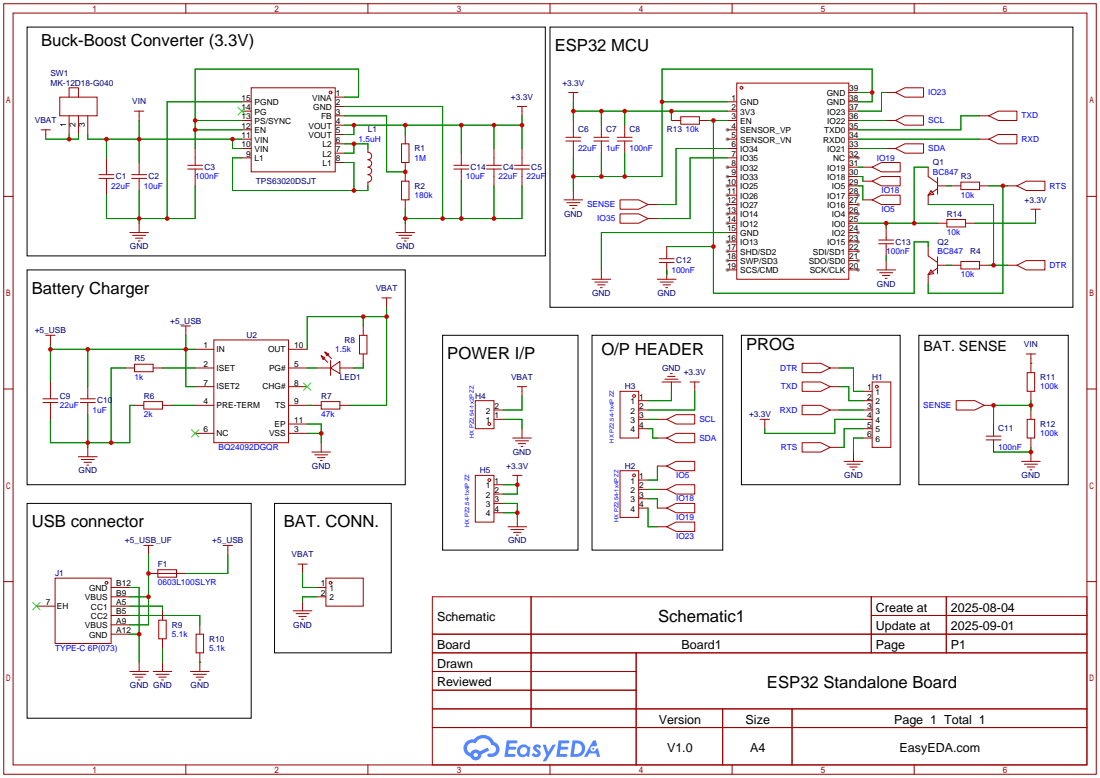
[picture p112: page 1]

VIN 10 VIN 11 EN 12 PS/SYNC 13 PG 14 PGND 15

Schematic | Schematic1 | Create at | 2025-08-04

Update at | 2025-09-01

Board | Board1 | Page | P1
Drawn | | ESP32 Standalone Board
Reviewed

Version | Size | Page 1 Total 1
V1.0 | A4 | EasyEDA.com
