xkarma31-blip/pig-health-monitor/v3-mqtt-pocketbase/backend/systemd/config.txt

# For more options and information see
# http://rptl.io/configtxt
# Some settings may impact device functionality. See link above for details

# Uncomment some or all of these to enable the optional hardware interfaces
dtparam=i2c_arm=on
dtparam=i2c_arm_baudrate=100000
#dtparam=spi=on

# Enable audio (loads snd_bcm2835)
dtparam=audio=on

# I2S / voiceHAT REMOVED 2026-09-29.
# The direct-wired INMP441 on GPIO18/19/20 needed dtoverlay=googlevoicehat-soundcard
# (+ dtparam=i2s=on). That overlay is for the Google Voice HAT, which contains a
# physical audio codec; this board has none, so arecord returned a registered
# card that produced bit-exact zeros on every channel. Do not re-add it without
# a real codec present. Audio now comes only from the ESP32-S3 barn mic over TCP.

# Additional overlays and parameters are documented
# /boot/firmware/overlays/README

# Automatically load overlays for detected cameras
camera_auto_detect=1

# Automatically load overlays for detected DSI displays
display_auto_detect=1

# Automatically load initramfs files, if found
auto_initramfs=1

# Enable DRM VC4 V3D driver
dtoverlay=vc4-kms-v3d
max_framebuffers=2

# Don't have the firmware create an initial video= setting in cmdline.txt.
# Use the kernel's default instead.
disable_fw_kms_setup=1

# Run in 64-bit mode
arm_64bit=1

# Disable compensation for displays with overscan
disable_overscan=1

# Run as fast as firmware / board allows
arm_boost=1

[cm4]
# Enable host mode on the 2711 built-in XHCI USB controller.
# This line should be removed if the legacy DWC2 controller is required
# (e.g. for USB device mode) or if USB support is not required.
otg_mode=1

[cm5]
dtoverlay=dwc2,dr_mode=host

[pi5]
dtoverlay=nospi10

[all]
