xkarma31-blip/pig-health-monitor/v3-mqtt-pocketbase/firmware/esp32s3-mic-ambient/arduino/esp32s3_telemetry/platformio.usb-diagnostic.ini

[platformio]
build_dir = .pio/usb-diagnostic

[env:usb-diagnostic]
platform = espressif32@7.0.1
board = esp32-s3-devkitc-1
framework = arduino
build_flags = -DARDUINO_USB_CDC_ON_BOOT=1 -DARDUINO_USB_MODE=1
build_src_filter = -<*> +<sensor_usb_diagnostic.cpp>
board_upload.flash_size = 4MB
board_build.partitions = default.csv
monitor_port = /dev/ttyACM0
monitor_speed = 115200

[env:sht-scan]
platform = espressif32@7.0.1
board = esp32-s3-devkitc-1
framework = arduino
build_flags = -DARDUINO_USB_CDC_ON_BOOT=1 -DARDUINO_USB_MODE=1
build_src_filter = -<*> +<sht_scan.cpp>
board_upload.flash_size = 4MB
board_build.partitions = default.csv
upload_port = /dev/ttyACM0
upload_speed = 115200
monitor_speed = 115200
lib_deps =
	adafruit/Adafruit SHT4x Library
	adafruit/Adafruit BusIO
