xkarma31-blip/pig-health-monitor/scripts/generate_coverage_viz.py

#!/usr/bin/env python3
"""PigPulse Coverage Visualization Generator — SVG + HTML"""

PEN_W = 400  # mm 1:100 scale
PEN_H = 400
CEILING_H = 250  # mm

# Colors
COL_GOOD = "#22c55e"
COL_OK = "#f59e0b"
COL_POOR = "#ef4444"
COL_NONE = "#94a3b8"
COL_THERMAL = "#3b82f6"
COL_CCTV = "#8b5cf6"
COL_PIG = "#f97316"
COL_MIC = "#1e293b"
COL_RPI = "#0ea5e9"

def audio_coverage_svg():
    """Single microphone — audio coverage zones"""
    svg = f'''<?xml version="1.0" encoding="UTF-8"?>
<svg xmlns="http://www.w3.org/2000/svg" viewBox="0 0 600 500" width="600" height="500">
  <defs>
    <radialGradient id="good" cx="50%" cy="50%" r="50%">
      <stop offset="0%" stop-color="{COL_GOOD}" stop-opacity="0.3"/>
      <stop offset="100%" stop-color="{COL_GOOD}" stop-opacity="0.05"/>
    </radialGradient>
    <radialGradient id="ok" cx="50%" cy="50%" r="50%">
      <stop offset="0%" stop-color="{COL_OK}" stop-opacity="0.3"/>
      <stop offset="100%" stop-color="{COL_OK}" stop-opacity="0.05"/>
    </radialGradient>
    <radialGradient id="poor" cx="50%" cy="50%" r="50%">
      <stop offset="0%" stop-color="{COL_POOR}" stop-opacity="0.2"/>
      <stop offset="100%" stop-color="{COL_POOR}" stop-opacity="0.05"/>
    </radialGradient>
  </defs>
  
  <!-- Title -->
  <text x="300" y="30" text-anchor="middle" font-size="16" font-weight="bold" fill="#1e293b">AUDIO COVERAGE — Single Microphone</text>
  
  <!-- Pen area -->
  <rect x="50" y="50" width="{PEN_W}" height="{PEN_H}" fill="none" stroke="#475569" stroke-width="2"/>
  <text x="50" y="45" font-size="10" fill="#64748b">4m × 4m Pen</text>
  
  <!-- Coverage circles (realistic audio falloff) -->
  <!-- Good: 0-2m (25% of pen) -->
  <circle cx="250" cy="250" r="100" fill="url(#good)" stroke="{COL_GOOD}" stroke-width="2" stroke-dasharray="5,5"/>
  <circle cx="250" cy="250" r="100" fill="none" stroke="{COL_GOOD}" stroke-width="1" stroke-dasharray="5,5"/>
  
  <!-- OK: 2-3m (additional 25%) -->
  <circle cx="250" cy="250" r="150" fill="url(#ok)" stroke="{COL_OK}" stroke-width="2" stroke-dasharray="5,5"/>
  
  <!-- Poor: 3-4m (outer 25%) -->
  <circle cx="250" cy="250" r="200" fill="url(#poor)" stroke="{COL_POOR}" stroke-width="2" stroke-dasharray="5,5"/>
  
  <!-- Center mic -->
  <circle cx="250" cy="250" r="8" fill="{COL_MIC}"/>
  <text x="250" y="255" text-anchor="middle" font-size="9" fill="#fff" font-weight="bold">MIC</text>
  
  <!-- Labels -->
  <text x="200" y="220" font-size="11" fill="{COL_GOOD}" font-weight="bold">✅ Good</text>
  <text x="200" y="205" font-size="9" fill="{COL_GOOD}">&lt;2m | Direct path</text>
  
  <text x="310" y="180" font-size="11" fill="{COL_OK}" font-weight="bold">⚠️ OK</text>
  <text x="310" y="165" font-size="9" fill="{COL_OK}">2-3m | Some noise</text>
  
  <text x="370" y="130" font-size="11" fill="{COL_POOR}" font-weight="bold">❌ Poor</text>
  <text x="370" y="115" font-size="9" fill="{COL_POOR}">3-4m | Occlusion</text>
  
  <!-- Obstacles -->
  <rect x="80" y="320" width="80" height="30" fill="#e2e8f0" stroke="#94a3b8" stroke-width="1" rx="3"/>
  <text x="120" y="340" text-anchor="middle" font-size="9" fill="#475569">Feeder</text>
  
  <rect x="350" y="80" width="60" height="30" fill="#e2e8f0" stroke="#94a3b8" stroke-width="1" rx="3"/>
  <text x="380" y="100" text-anchor="middle" font-size="9" fill="#475569">Waterer</text>
  
  <!-- Pigs -->
  <circle cx="150" cy="180" r="12" fill="{COL_PIG}" opacity="0.8"/>
  <text x="150" y="185" text-anchor="middle" font-size="8" fill="#fff">P</text>
  
  <circle cx="320" cy="300" r="12" fill="{COL_PIG}" opacity="0.8"/>
  <text x="320" y="305" text-anchor="middle" font-size="8" fill="#fff">P</text>
  
  <circle cx="380" cy="150" r="12" fill="{COL_PIG}" opacity="0.8"/>
  <text x="380" y="155" text-anchor="middle" font-size="8" fill="#fff">P</text>
  
  <!-- Legend -->
  <rect x="460" y="400" width="130" height="90" fill="#f8fafc" stroke="#e2e8f0" rx="5"/>
  <circle cx="475" cy="420" r="6" fill="{COL_GOOD}"/>
  <text x="485" y="424" font-size="9" fill="#475569">Good (50% area)</text>
  <circle cx="475" cy="440" r="6" fill="{COL_OK}"/>
  <text x="485" y="444" font-size="9" fill="#475569">OK (25% area)</text>
  <circle cx="475" cy="460" r="6" fill="{COL_POOR}"/>
  <text x="485" y="464" font-size="9" fill="#475569">Poor (25% area)</text>
  <circle cx="475" cy="480" r="6" fill="{COL_PIG}"/>
  <text x="485" y="484" font-size="9" fill="#475569">Pig location</text>
  
  <!-- Coverage note -->
  <rect x="50" y="465" width="380" height="25" fill="#f0fdf4" stroke="#bbf7d0" rx="5"/>
  <text x="60" y="482" font-size="9" fill="#166534">📊 Reliable coverage: ~50% of pen (near mic). Faint coughs missed at edges.</text>
</svg>'''
    return svg


def thermal_coverage_svg():
    """MLX90640 thermal camera FOV zones"""
    svg = f'''<?xml version="1.0" encoding="UTF-8"?>
<svg xmlns="http://www.w3.org/2000/svg" viewBox="0 0 600 500" width="600" height="500">
  <defs>
    <radialGradient id="thermal" cx="50%" cy="100%" r="80%">
      <stop offset="0%" stop-color="{COL_THERMAL}" stop-opacity="0.15"/>
      <stop offset="60%" stop-color="{COL_THERMAL}" stop-opacity="0.08"/>
      <stop offset="100%" stop-color="{COL_THERMAL}" stop-opacity="0.02"/>
    </radialGradient>
    <linearGradient id="fovGrad" x1="0%" y1="0%" x2="0%" y2="100%">
      <stop offset="0%" stop-color="{COL_THERMAL}" stop-opacity="0.3"/>
      <stop offset="100%" stop-color="{COL_THERMAL}" stop-opacity="0.05"/>
    </linearGradient>
  </defs>
  
  <text x="300" y="30" text-anchor="middle" font-size="16" font-weight="bold" fill="#1e293b">THERMAL COVERAGE — MLX90640 (110° FOV)</text>
  
  <!-- Pen -->
  <rect x="50" y="50" width="400" height="400" fill="none" stroke="#475569" stroke-width="2"/>
  
  <!-- FOV cone from ceiling (top-down view) -->
  <!-- At 2.5m height, 110° FOV covers ~5m diameter on ground -->
  <path d="M250,50 L50,450 L450,450 Z" fill="url(#fovGrad)" stroke="{COL_THERMAL}" stroke-width="2"/>
  
  <!-- Zones -->
  <!-- Zone 4: Near edges (partial coverage) -->
  <rect x="50" y="350" width="80" height="100" fill="{COL_NONE}" opacity="0.3" rx="3"/>
  <text x="90" y="405" text-anchor="middle" font-size="8" fill="#fff">Partial</text>
  
  <rect x="370" y="350" width="80" height="100" fill="{COL_NONE}" opacity="0.3" rx="3"/>
  <text x="410" y="405" text-anchor="middle" font-size="8" fill="#fff">Partial</text>
  
  <!-- Zone 1-4 (quadrants) -->
  <rect x="60" y="60" width="90" height="90" fill="{COL_OK}" opacity="0.2" rx="3"/>
  <text x="105" y="110" text-anchor="middle" font-size="9" fill="{COL_OK}">Zone 1</text>
  
  <rect x="160" y="60" width="90" height="90" fill="{COL_OK}" opacity="0.2" rx="3"/>
  <text x="205" y="110" text-anchor="middle" font-size="9" fill="{COL_OK}">Zone 2</text>
  
  <rect x="60" y="160" width="90" height="90" fill="{COL_OK}" opacity="0.2" rx="3"/>
  <text x="105" y="210" text-anchor="middle" font-size="9" fill="{COL_OK}">Zone 3</text>
  
  <rect x="160" y="160" width="90" height="90" fill="{COL_OK}" opacity="0.2" rx="3"/>
  <text x="205" y="210" text-anchor="middle" font-size="9" fill="{COL_OK}">Zone 4</text>
  
  <!-- Center zone (best coverage) -->
  <rect x="100" y="100" width="100" height="100" fill="{COL_GOOD}" opacity="0.25" rx="3"/>
  <text x="150" y="155" text-anchor="middle" font-size="10" fill="{COL_GOOD}" font-weight="bold">BEST</text>
  
  <!-- MLX90640 sensor -->
  <rect x="230" y="40" width="40" height="20" fill="{COL_THERMAL}" rx="3"/>
  <text x="250" y="53" text-anchor="middle" font-size="8" fill="#fff" font-weight="bold">MLX</text>
  
  <!-- 110° angle indicator -->
  <path d="M250,60 L200,90 L300,90 Z" fill="{COL_THERMAL}" opacity="0.4"/>
  <text x="250" y="85" text-anchor="middle" font-size="8" fill="#fff">110°</text>
  
  <!-- Pigs -->
  <circle cx="120" cy="130" r="10" fill="{COL_PIG}" opacity="0.8"/>
  <text x="120" y="135" text-anchor="middle" font-size="8" fill="#fff">P1</text>
  
  <circle cx="300" cy="280" r="10" fill="{COL_PIG}" opacity="0.8"/>
  <text x="300" y="285" text-anchor="middle" font-size="8" fill="#fff">P2</text>
  
  <circle cx="80" cy="380" r="10" fill="{COL_PIG}" opacity="0.5"/>
  <text x="80" y="385" text-anchor="middle" font-size="8" fill="#fff">P3?</text>
  
  <!-- Legend -->
  <rect x="460" y="80" width="130" height="120" fill="#f8fafc" stroke="#e2e8f0" rx="5"/>
  <text x="475" y="100" font-size="9" font-weight="bold" fill="#475569">THERMAL NOTES</text>
  <text x="475" y="118" font-size="8" fill="#64748b">• 32×24 pixels total</text>
  <text x="475" y="134" font-size="8" fill="#64748b">• Each pixel = 6×6cm @2m</text>
  <text x="475" y="150" font-size="8" fill="#64748b">• Ear = 2-3 pixels (can't detect)</text>
  <text x="475" y="166" font-size="8" fill="#64748b">• Zone-level only</text>
  <text x="475" y="182" font-size="8" fill="#64748b">• ±1.7°C accuracy</text>
  <text x="475" y="198" font-size="8" fill="#64748b">• Sunlight = blind spot</text>
  
  <!-- Coverage note -->
  <rect x="50" y="465" width="380" height="25" fill="#eff6ff" stroke="#bfdbfe" rx="5"/>
  <text x="60" y="482" font-size="9" fill="#1e40af">📊 FOV covers full pen but resolution too low for individual pigs. Zone-level only.</text>
</svg>'''
    return svg


def cctv_coverage_svg():
    """CCTV camera coverage zones"""
    svg = f'''<?xml version="1.0" encoding="UTF-8"?>
<svg xmlns="http://www.w3.org/2000/svg" viewBox="0 0 600 500" width="600" height="500">
  <defs>
    <linearGradient id="cctvFov" x1="0%" y1="0%" x2="0%" y2="100%">
      <stop offset="0%" stop-color="{COL_CCTV}" stop-opacity="0.25"/>
      <stop offset="100%" stop-color="{COL_CCTV}" stop-opacity="0.05"/>
    </linearGradient>
  </defs>
  
  <text x="300" y="30" text-anchor="middle" font-size="16" font-weight="bold" fill="#1e293b">CCTV COVERAGE — 1080p Top-Down View</text>
  
  <!-- Pen -->
  <rect x="50" y="50" width="400" height="400" fill="none" stroke="#475569" stroke-width="2"/>
  
  <!-- CCTV FOV (90° typical ceiling mount) -->
  <path d="M250,50 L50,450 L450,450 Z" fill="url(#cctvFov)" stroke="{COL_CCTV}" stroke-width="2"/>
  
  <!-- Grid overlay (pixels) -->
  <g opacity="0.1">
    <line x1="50" y1="100" x2="450" y2="100" stroke="{COL_CCTV}" stroke-width="0.5"/>
    <line x1="50" y1="150" x2="450" y2="150" stroke="{COL_CCTV}" stroke-width="0.5"/>
    <line x1="50" y1="200" x2="450" y2="200" stroke="{COL_CCTV}" stroke-width="0.5"/>
    <line x1="50" y1="250" x2="450" y2="250" stroke="{COL_CCTV}" stroke-width="0.5"/>
    <line x1="50" y1="300" x2="450" y2="300" stroke="{COL_CCTV}" stroke-width="0.5"/>
    <line x1="50" y1="350" x2="450" y2="350" stroke="{COL_CCTV}" stroke-width="0.5"/>
    <line x1="50" y1="400" x2="450" y2="400" stroke="{COL_CCTV}" stroke-width="0.5"/>
    <line x1="100" y1="50" x2="100" y2="450" stroke="{COL_CCTV}" stroke-width="0.5"/>
    <line x1="150" y1="50" x2="150" y2="450" stroke="{COL_CCTV}" stroke-width="0.5"/>
    <line x1="200" y1="50" x2="200" y2="450" stroke="{COL_CCTV}" stroke-width="0.5"/>
    <line x1="250" y1="50" x2="250" y2="450" stroke="{COL_CCTV}" stroke-width="0.5"/>
    <line x1="300" y1="50" x2="300" y2="450" stroke="{COL_CCTV}" stroke-width="0.5"/>
    <line x1="350" y1="50" x2="350" y2="450" stroke="{COL_CCTV}" stroke-width="0.5"/>
    <line x1="400" y1="50" x2="400" y2="450" stroke="{COL_CCTV}" stroke-width="0.5"/>
  </g>
  
  <!-- CCTV camera -->
  <rect x="230" y="35" width="40" height="20" fill="{COL_CCTV}" rx="3"/>
  <text x="250" y="48" text-anchor="middle" font-size="8" fill="#fff" font-weight="bold">CCTV</text>
  
  <!-- YOLO bounding boxes -->
  <rect x="80" y="150" width="60" height="40" fill="none" stroke="{COL_PIG}" stroke-width="2" rx="2"/>
  <text x="90" y="145" font-size="8" fill="{COL_PIG}">Pig 1</text>
  
  <rect x="280" y="300" width="60" height="40" fill="none" stroke="{COL_PIG}" stroke-width="2" rx="2"/>
  <text x="290" y="295" font-size="8" fill="{COL_PIG}">Pig 2</text>
  
  <rect x="370" y="130" width="60" height="40" fill="none" stroke="{COL_PIG}" stroke-width="2" rx="2"/>
  <text x="380" y="125" font-size="8" fill="{COL_PIG}">Pig 3</text>
  
  <!-- Partially occluded pig -->
  <rect x="60" y="370" width="60" height="40" fill="none" stroke="{COL_PIG}" stroke-width="2" stroke-dasharray="4,2" rx="2" opacity="0.6"/>
  <text x="70" y="365" font-size="8" fill="{COL_PIG}">Pig 4?</text>
  
  <!-- Behavior labels -->
  <text x="110" y="175" font-size="7" fill="#166534">Standing</text>
  <text x="310" y="325" font-size="7" fill="#166534">Lying</text>
  <text x="400" y="155" font-size="7" fill="#166534">Eating</text>
  
  <!-- Legend -->
  <rect x="460" y="80" width="130" height="120" fill="#f8fafc" stroke="#e2e8f0" rx="5"/>
  <text x="475" y="100" font-size="9" font-weight="bold" fill="#475569">CCTV NOTES</text>
  <text x="475" y="118" font-size="8" fill="#64748b">• 1920×1080 pixels</text>
  <text x="475" y="134" font-size="8" fill="#64748b">• Pig ear = ~75×105 px</text>
  <text x="475" y="150" font-size="8" fill="#64748b">• Can detect individual pigs</text>
  <text x="475" y="166" font-size="8" fill="#64748b">• YOLO: 92-99% mAP</text>
  <text x="475" y="182" font-size="8" fill="#64748b">• ByteTrack: 97% MOTA</text>
  <text x="475" y="198" font-size="8" fill="#64748b">• Behavior recognition</text>
  
  <!-- Coverage note -->
  <rect x="50" y="465" width="380" height="25" fill="#faf5ff" stroke="#e9d5ff" rx="5"/>
  <text x="60" y="482" font-size="9" fill="#6b21a8">📊 Full pen coverage. YOLO detects pigs, ByteTrack assigns IDs, monitors behavior.</text>
</svg>'''
    return svg


def multimodal_fusion_svg():
    """Combined audio + thermal + CCTV coverage"""
    svg = f'''<?xml version="1.0" encoding="UTF-8"?>
<svg xmlns="http://www.w3.org/2000/svg" viewBox="0 0 600 500" width="600" height="500">
  <defs>
    <radialGradient id="mgood" cx="50%" cy="50%" r="50%">
      <stop offset="0%" stop-color="{COL_GOOD}" stop-opacity="0.35"/>
      <stop offset="100%" stop-color="{COL_GOOD}" stop-opacity="0.1"/>
    </radialGradient>
    <radialGradient id="mok" cx="50%" cy="50%" r="50%">
      <stop offset="0%" stop-color="{COL_OK}" stop-opacity="0.25"/>
      <stop offset="100%" stop-color="{COL_OK}" stop-opacity="0.08"/>
    </radialGradient>
  </defs>
  
  <text x="300" y="30" text-anchor="middle" font-size="16" font-weight="bold" fill="#1e293b">MULTI-MODAL FUSION — Full PigPulse Coverage</text>
  
  <!-- Pen -->
  <rect x="50" y="50" width="400" height="400" fill="none" stroke="#475569" stroke-width="2"/>
  
  <!-- CCTV FOV (full coverage, lightest) -->
  <path d="M250,50 L50,450 L450,450 Z" fill="{COL_CCTV}" opacity="0.08" stroke="{COL_CCTV}" stroke-width="1" stroke-dasharray="4,4"/>
  
  <!-- MLX90640 FOV (medium coverage) -->
  <path d="M250,50 L70,450 L430,450 Z" fill="{COL_THERMAL}" opacity="0.12" stroke="{COL_THERMAL}" stroke-width="1" stroke-dasharray="4,4"/>
  
  <!-- Audio coverage (strongest near center) -->
  <circle cx="250" cy="250" r="100" fill="url(#mgood)" stroke="{COL_GOOD}" stroke-width="2"/>
  <circle cx="250" cy="250" r="150" fill="url(#mok)" stroke="{COL_OK}" stroke-width="1" stroke-dasharray="4,4"/>
  <circle cx="250" cy="250" r="200" fill="{COL_POOR}" opacity="0.1" stroke="{COL_POOR}" stroke-width="1" stroke-dasharray="4,4"/>
  
  <!-- Combined coverage zones (color-coded by quality) -->
  <!-- Green zone: All 3 modalities good -->
  <rect x="100" y="100" width="100" height="100" fill="{COL_GOOD}" opacity="0.25" rx="3"/>
  <text x="150" y="155" text-anchor="middle" font-size="10" fill="{COL_GOOD}" font-weight="bold">EXCELLENT</text>
  <text x="150" y="170" text-anchor="middle" font-size="8" fill="{COL_GOOD}">Audio+Thermo+CCTV</text>
  
  <!-- Orange zone: Thermo + CCTV, audio weak -->
  <rect x="200" y="100" width="80" height="80" fill="{COL_OK}" opacity="0.2" rx="3"/>
  <text x="240" y="145" text-anchor="middle" font-size="9" fill="{COL_OK}" font-weight="bold">GOOD</text>
  <text x="240" y="158" text-anchor="middle" font-size="7" fill="{COL_OK}">Thermo+CCTV</text>
  
  <!-- Red zone: CCTV only -->
  <rect x="280" y="100" width="80" height="80" fill="{COL_POOR}" opacity="0.15" rx="3"/>
  <text x="320" y="145" text-anchor="middle" font-size="9" fill="{COL_POOR}" font-weight="bold">CCTV ONLY</text>
  
  <!-- Gray zone: Partial coverage -->
  <rect x="50" y="200" width="50" height="200" fill="{COL_NONE}" opacity="0.2" rx="3"/>
  <text x="75" y="305" text-anchor="middle" font-size="8" fill="#fff" transform="rotate(-90,75,300)">Partial</text>
  
  <!-- Center sensors -->
  <circle cx="250" cy="250" r="10" fill="{COL_MIC}"/>
  <text x="250" y="255" text-anchor="middle" font-size="8" fill="#fff" font-weight="bold">MIC</text>
  
  <!-- MLX90640 -->
  <rect x="220" y="235" width="25" height="15" fill="{COL_THERMAL}" rx="2"/>
  <text x="232" y="246" text-anchor="middle" font-size="6" fill="#fff">MLX</text>
  
  <!-- CCTV -->
  <rect x="270" y="235" width="30" height="15" fill="{COL_CCTV}" rx="2"/>
  <text x="285" y="246" text-anchor="middle" font-size="6" fill="#fff">CCTV</text>
  
  <!-- Pigs with IDs -->
  <circle cx="150" cy="150" r="12" fill="{COL_PIG}"/>
  <text x="150" y="155" text-anchor="middle" font-size="8" fill="#fff" font-weight="bold">P1</text>
  <text x="150" y="140" text-anchor="middle" font-size="7" fill="#166534">All 3</text>
  
  <circle cx="300" cy="350" r="12" fill="{COL_PIG}"/>
  <text x="300" y="355" text-anchor="middle" font-size="8" fill="#fff" font-weight="bold">P2</text>
  <text x="300" y="338" text-anchor="middle" font-size="7" fill="#166534">CCTV+Thermo</text>
  
  <circle cx="100" cy="380" r="12" fill="{COL_PIG}" opacity="0.7"/>
  <text x="100" y="385" text-anchor="middle" font-size="8" fill="#fff" font-weight="bold">P3</text>
  <text x="100" y="368" text-anchor="middle" font-size="7" fill="#166534">CCTV only</text>
  
  <circle cx="400" cy="200" r="12" fill="{COL_PIG}" opacity="0.6"/>
  <text x="400" y="205" text-anchor="middle" font-size="8" fill="#fff" font-weight="bold">P4</text>
  <text x="400" y="188" text-anchor="middle" font-size="7" fill="#166534">Partial</text>
  
  <!-- Legend -->
  <rect x="460" y="80" width="130" height="200" fill="#f8fafc" stroke="#e2e8f0" rx="5"/>
  <text x="475" y="100" font-size="9" font-weight="bold" fill="#475569">COVERAGE ZONES</text>
  
  <rect x="475" y="108" width="12" height="12" fill="{COL_GOOD}" opacity="0.5" rx="2"/>
  <text x="492" y="118" font-size="8" fill="#475569">All 3 modalities</text>
  
  <rect x="475" y="128" width="12" height="12" fill="{COL_OK}" opacity="0.5" rx="2"/>
  <text x="492" y="138" font-size="8" fill="#475569">Thermo + CCTV</text>
  
  <rect x="475" y="148" width="12" height="12" fill="{COL_POOR}" opacity="0.5" rx="2"/>
  <text x="492" y="158" font-size="8" fill="#475569">CCTV only</text>
  
  <rect x="475" y="168" width="12" height="12" fill="{COL_NONE}" opacity="0.5" rx="2"/>
  <text x="492" y="178" font-size="8" fill="#475569">Partial/edge</text>
  
  <text x="475" y="205" font-size="9" font-weight="bold" fill="#475569">OVERLAP AREA</text>
  <text x="475" y="223" font-size="8" fill="#64748b">Center: 100% (all 3)</text>
  <text x="475" y="239" font-size="8" fill="#64748b">Mid: 66% (2/3)</text>
  <text x="475" y="255" font-size="8" fill="#64748b">Edge: 33% (1/3)</text>
  <text x="475" y="271" font-size="8" fill="#64748b">Overall: ~85%</text>
  
  <!-- Coverage note -->
  <rect x="50" y="465" width="380" height="25" fill="#f0fdf4" stroke="#bbf7d0" rx="5"/>
  <text x="60" y="482" font-size="9" fill="#166534">📊 Multi-modal fusion achieves ~85% effective coverage. CCTV fills audio gaps, thermal adds fever.</text>
</svg>'''
    return svg


def placement_svg():
    """Optimal sensor placement diagram"""
    svg = f'''<?xml version="1.0" encoding="UTF-8"?>
<svg xmlns="http://www.w3.org/2000/svg" viewBox="0 0 600 500" width="600" height="500">
  <defs>
    <linearGradient id="ceil" x1="0%" y1="0%" x2="0%" y2="100%">
      <stop offset="0%" stop-color="#e2e8f0" stop-opacity="0.3"/>
      <stop offset="100%" stop-color="#e2e8f0" stop-opacity="0.1"/>
    </linearGradient>
  </defs>
  
  <text x="300" y="30" text-anchor="middle" font-size="16" font-weight="bold" fill="#1e293b">OPTIMAL SENSOR PLACEMENT</text>
  
  <!-- Pen top view -->
  <rect x="50" y="50" width="400" height="400" fill="none" stroke="#475569" stroke-width="2"/>
  
  <!-- Ceiling mount positions -->
  <!-- Main sensor package (center) -->
  <circle cx="250" cy="250" r="25" fill="#e2e8f0" stroke="#475569" stroke-width="2"/>
  <rect x="240" y="240" width="20" height="20" fill="{COL_MIC}" rx="3"/>
  <text x="250" y="253" text-anchor="middle" font-size="6" fill="#fff">ALL</text>
  <text x="250" y="280" text-anchor="middle" font-size="8" fill="#475569">Main Unit</text>
  
  <!-- Secondary mic (far side for coverage) -->
  <circle cx="420" cy="420" r="15" fill="#e2e8f0" stroke="#475569" stroke-width="1"/>
  <rect x="413" y="413" width="14" height="14" fill="{COL_MIC}" rx="2"/>
  <text x="420" y="423" text-anchor="middle" font-size="5" fill="#fff">MIC2</text>
  <text x="420" y="440" text-anchor="middle" font-size="8" fill="#475569">Mic 2</text>
  
  <!-- Coverage from main -->
  <circle cx="250" cy="250" r="80" fill="none" stroke="{COL_GOOD}" stroke-width="1" stroke-dasharray="3,3" opacity="0.5"/>
  <circle cx="250" cy="250" r="150" fill="none" stroke="{COL_OK}" stroke-width="1" stroke-dasharray="3,3" opacity="0.5"/>
  
  <!-- Coverage from mic 2 -->
  <circle cx="420" cy="420" r="80" fill="none" stroke="{COL_GOOD}" stroke-width="1" stroke-dasharray="3,3" opacity="0.5"/>
  
  <!-- Obstacles -->
  <rect x="60" y="320" width="80" height="30" fill="#f1f5f9" stroke="#cbd5e1" stroke-width="1" rx="3"/>
  <text x="100" y="340" text-anchor="middle" font-size="9" fill="#475569">Feeder</text>
  
  <rect x="300" y="60" width="60" height="30" fill="#f1f5f9" stroke="#cbd5e1" stroke-width="1" rx="3"/>
  <text x="330" y="80" text-anchor="middle" font-size="9" fill="#475569">Waterer</text>
  
  <!-- Ventilation fan -->
  <circle cx="80" cy="100" r="20" fill="#f1f5f9" stroke="#cbd5e1" stroke-width="1"/>
  <text x="80" y="105" text-anchor="middle" font-size="8" fill="#475569">Fan</text>
  
  <!-- Sunlight zone -->
  <rect x="300" y="300" width="100" height="80" fill="#fef3c7" opacity="0.3" stroke="#fbbf24" stroke-width="1" stroke-dasharray="4,4" rx="3"/>
  <text x="350" y="345" text-anchor="middle" font-size="8" fill="#92400e">⚠️ Sunlight zone</text>
  
  <!-- Pigs -->
  <circle cx="150" cy="180" r="12" fill="{COL_PIG}" opacity="0.8"/>
  <text x="150" y="185" text-anchor="middle" font-size="8" fill="#fff">P1</text>
  
  <circle cx="350" cy="200" r="12" fill="{COL_PIG}" opacity="0.8"/>
  <text x="350" y="205" text-anchor="middle" font-size="8" fill="#fff">P2</text>
  
  <circle cx="100" cy="400" r="12" fill="{COL_PIG}" opacity="0.8"/>
  <text x="100" y="405" text-anchor="middle" font-size="8" fill="#fff">P3</text>
  
  <circle cx="380" cy="380" r="12" fill="{COL_PIG}" opacity="0.8"/>
  <text x="380" y="385" text-anchor="middle" font-size="8" fill="#fff">P4</text>
  
  <!-- Legend -->
  <rect x="460" y="80" width="130" height="140" fill="#f8fafc" stroke="#e2e8f0" rx="5"/>
  <text x="475" y="100" font-size="9" font-weight="bold" fill="#475569">PLACEMENT RULES</text>
  <text x="475" y="118" font-size="8" fill="#64748b">1. Center ceiling mount</text>
  <text x="475" y="134" font-size="8" fill="#64748b">2. 2.5-3m height optimal</text>
  <text x="475" y="150" font-size="8" fill="#64748b">3. Point DOWN (not at walls)</text>
  <text x="475" y="166" font-size="8" fill="#64748b">4. Avoid pointing at windows</text>
  <text x="475" y="182" font-size="8" fill="#64748b">5. Second mic for far side</text>
  <text x="475" y="198" font-size="8" fill="#64748b">6. Use IR-transparent window</text>
  <text x="475" y="214" font-size="8" fill="#64748b">7. IP65 enclosure</text>
  
  <!-- Note -->
  <rect x="50" y="465" width="380" height="25" fill="#eff6ff" stroke="#bfdbfe" rx="5"/>
  <text x="60" y="482" font-size="9" fill="#1e40af">📊 Dual-mic + ceiling mount + sunlight avoidance = best coverage with ₱6,500 budget.</text>
</svg>'''
    return svg


if __name__ == '__main__':
    import os
    
    outdir = '/home/solrahk/pig-health-monitor/docs/visualizations'
    os.makedirs(outdir, exist_ok=True)
    
    svgs = {
        '01_audio_coverage.svg': audio_coverage_svg(),
        '02_thermal_coverage.svg': thermal_coverage_svg(),
        '03_cctv_coverage.svg': cctv_coverage_svg(),
        '04_multimodal_fusion.svg': multimodal_fusion_svg(),
        '05_sensor_placement.svg': placement_svg(),
    }
    
    for fname, content in svgs.items():
        fpath = os.path.join(outdir, fname)
        with open(fpath, 'w') as f:
            f.write(content)
        print(f"✅ {fpath}")
    
    # Also generate an HTML gallery
    html = '''<!DOCTYPE html>
<html><head><meta charset="utf-8"><title>PigPulse Coverage Visualizations</title>
<style>
body { font-family: system-ui; background: #f1f5f9; margin: 0; padding: 20px; }
.grid { display: grid; grid-template-columns: repeat(auto-fit, minmax(500px, 1fr)); gap: 20px; }
.card { background: #fff; border-radius: 12px; box-shadow: 0 4px 12px rgba(0,0,0,0.1); padding: 15px; }
.card h3 { margin: 0 0 10px 0; font-size: 14px; color: #1e293b; }
.card svg { width: 100%; height: auto; border-radius: 8px; }
h1 { text-align: center; color: #1e293b; font-size: 20px; }
p { text-align: center; color: #64748b; font-size: 13px; margin-bottom: 20px; }
</style></head><body>
<h1>🐷 PigPulse Coverage Analysis</h1>
<p>Full visualization of audio, thermal, CCTV, and multi-modal fusion coverage</p>
<div class="grid">
'''
    for fname in svgs:
        name = fname.replace('.svg', '').replace('_', ' ').replace('-', ' ').title()
        html += f'<div class="card"><h3>{name}</h3>\n'
        with open(os.path.join(outdir, fname)) as f:
            html += f.read()
        html += '</div>\n'
    
    html += '</div></body></html>'
    
    html_path = os.path.join(outdir, 'index.html')
    with open(html_path, 'w') as f:
        f.write(html)
    print(f"✅ {html_path}")
    
    print("\n🖼️  All visualizations generated!")
    print("📂 Open index.html in browser to see all 5 diagrams")
