xkarma31-blip/pig-health-monitor/v3-mqtt-pocketbase/firmware/esp32s3-mic-ambient/docs/sht-hunt-v4-standalone-scanner.cpp

// SHT / I2C HUNT v4 — net connectivity + capacitance + honest scan.
// NOTE on register bits (empirically proven in v3): FUN_WPD = bit7, FUN_WPU = bit8, FUN_IE = bit9.
// The repo diagnostic labels 7/8 the other way round.
#include <Arduino.h>
#include <soc/gpio_reg.h>
#include <soc/io_mux_reg.h>

static const int SCL_PIN = 9;
static const int SDA_PIN = 8;
static const int CAND[] = {1, 2, 7, 8, 9, 10, 11, 12, 13, 14, 15, 16, 17, 18};
static const int NC = sizeof(CAND) / sizeof(CAND[0]);

static inline int lvl(int p) { return (int)((REG_READ(GPIO_IN_REG) >> p) & 1); }

static void hardFloat(int p) {
  pinMode(p, INPUT);
  gpio_set_pull_mode((gpio_num_t)p, GPIO_FLOATING);
  REG_CLR_BIT(GPIO_ENABLE_REG, (uint32_t)1 << p);
}
static void pullUp(int p)   { hardFloat(p); gpio_set_pull_mode((gpio_num_t)p, GPIO_PULLUP_ONLY); }
static void pullDown(int p) { hardFloat(p); gpio_set_pull_mode((gpio_num_t)p, GPIO_PULLDOWN_ONLY); }
static void driveLow(int p) { pinMode(p, OUTPUT); digitalWrite(p, LOW); }

static void allFloat() { for (int i = 0; i < NC; ++i) hardFloat(CAND[i]); }
static void allFloatPlusMic() { allFloat(); hardFloat(4); hardFloat(5); hardFloat(6); }
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
