xkarma31-blip/pig-health-monitor/(commit log)

2026-04-07 UI Redesign: Implement Pig Health Sensor Dashboard (Aqua Theme)
2026-04-07 Phase 2: Multi-screen tabbed dashboard with reusable components & mock data
    - Tab navigation: Dashboard | Sensors | Alerts
    - Reusable components: SensorCard, AlertRow, StatusBadge
    - Full design system in Theme.ts (status colors, spacing, typography)
    - TypeScript-typed mock data layer (mockSensors.ts, mockAlerts.ts)
    - All TEMPORARY data clearly marked for future Supabase integration
    - Cross-platform: identical on Web and Mobile via react-native-web
2026-04-23 Initial commit of Full Power Pig Health Monitor System
2026-04-23 feat: Full-power stabilization sprint
    Firmware:
    - AcousticSignature: dual-band cough classifier (600Hz=infectious, 1600Hz=non-infectious)
    based on NIH/ASABE peer-reviewed research on swine respiratory disease
    - AcousticSignature: CoughType enum; backwards-compatible detectCough() wrapper
    - ThermalIdentification: MAX_ENROLLMENTS (50) guard; SPIFFS roster limit alert to Firebase
    - ThermalIdentification: identifyPig() now returns bestScore via ref for Near Match logging
    - main.cpp: severity-aware cough alerting (HIGH for infectious, LOW for non-infectious)
    Mobile App:
    - index.tsx: fixed critical bug (ref/db/onValue used without import) -> subscribeTelemetry
    - index.tsx: hero card now shows i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
    [AcousticSignature.h, ThermalIdentification.h, main.cpp]
2026-04-23 feat: stabilize vessel for Title Defense with Thermal Super Res and Push Notifications
    [main.cpp]
2026-05-04 Fix APK link and add vercel.json
    [sketch.ino]
2026-05-04 Add Source Code button and fix APK link to use Codeberg raw
2026-05-04 chore: remove 6K+ build artifacts from tracking
    - Untrack firmware/.pio/ (4310 compiled objects - regenerated by pio run)
    - Untrack scripts/venv/ (1771 Python venv files - regenerated by pip)
    - Untrack landing_page/app-release.apk (73MB - served via Codeberg raw)
    - Untrack docs/*.mp4 and docs/*.webp (30MB videos - hosted externally)
    - Fix COUGH_NONE enum collision between AcousticSignature.h and EdgeImpulseCough.h
    - Update .gitignore to prevent re-tracking
    All files remain on disk. No functionality changed.
    [EdgeImpulseCough.h]
2026-05-04 fix: re-track app-release.apk (project deliverable, not build artifact)
2026-05-07 🛡️ HUSH HOG: Final Sovereign UI & Landing Page Polish 🛡️
2026-05-07 Landing: Add research title, upgrade 3D viewer with auto-rotate, reset view, and always-visible labels
2026-05-08 feat: restore all hidden features and fix navigation
    - TV Mode: replaced broken overlay bar with fullscreen Modal showing
    thermal feed, identified pig, temperature, and health status
    - Advisor Tab: wrapped in ResponsiveLayout so desktop sidebar shows
    (fixes trap where users couldn't navigate away)
    - Sidebar: added Alerts, Sensors, and Sign In/Out links
    - Tab Bar: unhid Alerts and Sensors tabs for mobile users
    - Theme: added missing 'accent' color to prevent undefined references
    - All features now discoverable on both mobile and desktop
2026-05-08 style: restore 3-Tab Ritual layout
    - Re-hid Alerts and Sensors tabs from bottom navigation
    - Added 'VIEW ALL ->' links to Dashboard sections instead
    - Keeps navigation clean while maintaining full feature access
2026-05-08 style: revamp Alerts and Sensors access via Top App Bar
    - Removed the 'View All' links from the dashboard cards per feedback
    - Added global Top App Bar icons (🔔 Alerts, 🌡️ Sensors) to the header
    - Keeps the bottom tab bar strictly to 3 items while providing intuitive, global access to hidden screens
2026-05-08 fix: remove TV mode and add global logout button
    - Removed 'TV Mode' functionality from the Dashboard entirely per user request
    - Added a global 'Sign Out' button (🚪) to the Top App Bar header alongside Alerts and Sensors, allowing mobile users to reliably log out
2026-05-17 feat(feed): Add pig roster panel with tap-to-track identification
2026-05-17 fix(feed): Fix roster tap-to-track — bounding box now locks onto selected pig coordinates
2026-05-25 chore: comprehensive code quality sweep + CI infrastructure
    - Firmware: fix EdgeImpulseCough.h garbage chars, WiFi timeout,
    stack overflow (heap alloc), vTaskDelete, thermal.readFrame()
    - Type system: replace 20 any with proper types across 9 files
    - Security: add **/secrets.h, *.apk, node_modules to .gitignore
    - Infrastructure: husky pre-commit, CI (lint+test+firmware+secrets),
    ESLint flat config, Jest config, tsconfig path aliases
    - Landing page: Three.js r128->r170, CSP/HSTS headers,
    APK download deprecated (use EAS builds)
    - Consolidation: fix_json.py unified (was 3), seed_firebase.mjs kept
    - Docs: PLAN_INDEX.md v3.1, AGENTS.md path corrections
    - PlatformIO: monitor_filters for exc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
    [EdgeImpulseCough.h, PigHealthMonitor.ino, ThermalIdentification.h, main.cpp]
2026-05-25 fix: landing page pre-deploy fixes
    - Fix Three.js URLs to r132 (last working non-module version)
    - Fix APK link hiding for both hero and footer (querySelectorAll)
    - Clean up CSP (remove unused unpkg.com, upload.wikimedia.org)
    - Add inline SVG favicon to prevent 404
2026-05-26 fix: landing page waypoint regression + mobile app TypeScript cascade
    Landing page (pig-health-research-portfolio.vercel.app):
    - Restored waypoint navigation functions (flyToWP, createArrows, startGuidedTour, showToast)
    - Restored playTelemetryPing() in triggerSimulation()
    - Relinked Vercel project to correct canonical domain
    - APK download now uses EAS URL from config instead of hidden
    - Audio engine: try/catch, reduced-motion auto-start, SENTINEL BOOT SEQUENCE banner
    Mobile app:
    - firebase.ts: cast snapshot.val() from unknown to Record<string, unknown> in all 3 subscribers
    - events.tsx: AlertItem interface, cast through unknown
    - analytics.tsx: RosterPig interface, cast through unknown
    -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
2026-05-26 fix: AlertRow crash on unknown severity + landing page CSP
2026-05-26 fix(firmware): initialize SPIFFS globally and correct I2S read buffer
    [ThermalIdentification.h, main.cpp]
2026-05-26 chore(firebase): update RTDB security rules for device-level telemetry writes
2026-05-26 feat(landing): add scroll progress, interactive reveals, and voice narration auto-wiring
2026-05-26 fix(mobile): guard useNativeDriver with Platform.OS check for web compatibility
    The RCTAnimation native module is not available on web. Using
    Platform.OS !== 'web' ensures native driver is only used on
    Android/iOS where it's supported, silencing the console warning.
2026-05-26 chore: ignore local .env* files in landing_page and mobile_app modules
2026-09-01 feat: add v3-mqtt-pocketbase architecture
    - Firebase replaced with MQTT + PocketBase stack
    - OpenResty API gateway with Lua rate limiting, auth, caching
    - Docker Compose: Mosquitto, PocketBase, ValKey, OpenResty, Bridge
    - ESP32 firmware adapted for D0WD with MQTT (dual-core RTOS)
    - Expo app: PocketBase primary, Firebase fallback, mock offline
    - CI/CD: GitHub Actions (lint, test, Docker build)
    - Docs: Architecture, Deployment, API (OpenAPI 3.0), Monitoring
    - Teammate setup guide for Docker Desktop
    - MIT License added
    - Legacy PigHealthMonitor.ino removed
    [AcousticSignature.h, PigMqttTopics.h, ThermalCamera.h, ThermalIdentification.h, audio_config.h]
2026-09-01 feat: add thermal live view WebSocket broadcaster
    - OpenResty proxy route /thermal-ws → thermal-ws:8080
    - thermal-ws service broadcasts MQTT thermal frames via WebSocket
    - Expo hook useThermalLiveView.ts for client-side streaming
    - Bidirectional: app can send ping/subscribe to thermal stream
2026-09-02 fix: hybrid architecture, working data path
    - PocketBase + Bridge run natively (systemd) to avoid Docker+UFW networking issues
    - Mosquitto + ValKey + ThermalWS run in Docker
    - OpenResty runs natively on host
    - Fixed PocketBase schema setup for v0.22.x
    - Added start.sh/stop.sh scripts for Docker services
    - Added .gitignore for pocketbase binary and data
    - Full data path verified: ESP32 → MQTT → Bridge → PocketBase → API
2026-09-07 feat(app): port deployed v2.1.0 UI onto PocketBase backend
    - Port deployed v2 layout (sidebar/bottom-nav/useBreakpoint) verbatim; remove
    v3 800px desktop card wrapper so the app fills the viewport on laptop
    - Swap Firebase data layer for PocketBase (pocketbase-data, pocketbase-auth):
    end-user -> live herd/alerts/sensors from PB; admin -> mock demo data;
    guest -> demo figures (matches deployed behavior)
    - Rebuild login screen: ADMIN (self-hosted PB superuser) / END-USER toggle,
    guest access; demo caption on Home is now the sign-in entry (tap -> /login)
    - Add /thermal route (deployed links to it; v3 had none) — MLX90640 live view
    - Keep v3 QoL files (setup wizard, farmerText) for lat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
2026-09-07 feat(landing): restore canonical landing with edge intelligence assets
    - Rebuild landing page (both root and v3 frontend copies, kept identical):
    Pigpulse — Edge Intelligence for Swine Health
    - Add optimized env_* .webp variants, og-image and pigpulse_poster art
2026-09-07 refactor(app): retire Firebase RTDB/Auth — PocketBase-only data layer
    Swap all 5 Firebase importers (web feed/events, feed, useOfflineTelemetry,
    AdvisorModal) to pocketbase-data; map PB devices rows to the v2 LiveSensor
    shape subscribeSensors callers were built against; drop unused firebase
    module (backed up to docs/legacy/firebase-backup with tombstone README);
    remove firebase npm dep (66 packages) from lockfile.
2026-09-07 fix(app): restore native sound via expo-audio (replaces expo-av)
    expo-av had ABI issues on SDK 57 so canUseNativeAudio() hard-returned false
    and native audio was dead. Migrate to expo-audio's createAudioPlayer + the
    new expo-file-system File/Directory API (legacy writeAsStringAsync throws at
    runtime in SDK 57); add an RN-safe base64 encoder (no btoa in Hermes).
2026-09-07 feat(app): collapsible sidebar — Option B (default-open + icon-rail toggle)
    Sidebar stays 232px open at >=960px (wordmark, labels, version), with a
    44px chevron toggle that collapses it to a 68px icon rail (labels + wordmark
    hidden, icons centered). Preference persisted — localStorage on web,
    AsyncStorage on native — and rehydrated on mount. Slot offset in tabs
    layout tracks the live rail width (single source of truth exported from
    SidebarNav). Verified 1440px (232->68->232, persists reload) + 390px
    (bottom nav untouched); 0 console errors.
2026-09-07 fix(app): SDK 57 EAS build config — schema, peers, patches
    - app.json: drop top-level 'splash' (removed from SDK 57 schema; adaptive
    icon keeps #1a1a2e). This error could break prebuild on EAS.
    - add expo-asset (required peer of expo-audio — 'may crash outside Expo Go' —
    expo install added its config plugin automatically)
    - remove @types/react-native (types bundled with RN 0.86)
    - align 7 patch versions to what SDK 57.0.20 expects (expo, constants,
    haptics, linking, notifications, router, react-native 0.86.3)
    expo-doctor: 21/21 checks passed. tsc: clean.
2026-09-07 feat(web): host live app at pig-health-monitor.vercel.app/app + fix landing TTS
    - app.json: expo-router experiments.baseUrl '/app' — all web routes live
    under /app (native/Android untouched) so the deployed SPA matches
    real routes instead of the not-found screen.
    - landing vercel.json: rewrites /app, /_expo/*, /assets/*, /favicon.ico
    into the synced app/ export (landing stays at root).
    - landing index.html: narration now falls back to speechSynthesis when a
    pre-rendered mp3 is missing/404s (they were never shipped; every
    narration line silently died on onerror). MP3 -> synth chain, no
    double-speak on success.
    - app/ build output gitignored (regenerated on each export + deploy).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
2026-09-07 fix(landing): restore voice files (pig cough + narration), slow TTS, mute kills audio
    - copy 22 pre-rendered narration/cough mp3s back from archive (they were
    never shipped with the v3 landing -> every voice line 404'd silently
    since the rebuild; 'pig cough not playing' was this path issue)
    - pigCough: reference .mp3 (code said .wav, files are .mp3)
    - slower narration: pre-rendered playbackRate 1.0->0.92, speechSynthesis
    rate 0.96->0.84
    - mute now cancels the CURRENT line + clears the whole queue (both
    speechSynthesis.cancel and pre-rendered audio stop) instead of only
    silencing the next line
    - verified live on vercel: sim_thermal/watch/alert/tour/cough all 200;
    Playwright: narra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
2026-09-07 fix(landing): point live-app CTAs at /app/tabs + SPA fallback so the URL works
    - all 9 'Live app / View live dashboard / Mobile hub / Dashboard / APK' links
    were href=https://pig-health-monitor.vercel.app (the LANDING again) - they
    now go to https://pig-health-monitor.vercel.app/app/tabs
    - vercel rewrites: /app/tabs and /app/tabs/:path* -> /app/index.html
    (SPA client-side route, no physical file) - verified live 200 + boots
    - local mirror: tiny node server at :8086 with identical /app/* behavior
    (http://127.0.0.1:8086/app/tabs) replacing the stale 'serve' process
2026-09-07 feat(sim): task 4 - virtual D0WD state machine with FreeRTOS TWDT, LiPo sag/brownout, beacon storm & chaos monkey (TDD GREEN)
2026-09-07 feat(landing): add 3D model toggle — switch between PCB view and real device
    - export realcapstone.blend (Blender 5.2 via flatpak) to GLB (736KB)
    - GLTFLoader from CDN (three r160 examples/js)
    - toggle button '3D Model' / 'PCB View' in viewer controls
    - hides procedural PCB + hotspots when showing GLB, restores on switch
    - auto-centers and scales the imported model to fit the scene
    - lazy-loaded: only fetches GLB on first toggle click
2026-09-07 fix(landing): GLB toggle button hidden when GLTFLoader not yet loaded
    - always attach click handler, don't require THREE.GLTFLoader at init
    - lazy-inject GLTFLoader CDN script on first click if not already present
    - removes display:none fallback that hid the button entirely
2026-09-07 fix(landing): GLB loading — clone center to avoid mutating box.getCenter result
2026-09-07 fix(landing): replace broken CDN GLTFLoader with inline GLB loader
    - three@0.160.0/examples/js/loaders/GLTFLoader.js returns 404
    - inline minimal GLB parser using global THREE (no external dependency)
    - simpler toggle flow: always show button, load on click via _loadGLB()
2026-09-07 fix(landing): move GLB loader to external file and defer THREE access
    - glb-loader.js no longer accesses THREE at load time
    - THREE references moved inside functions so they run only after viewer init
    - eliminates ReferenceError that was breaking the whole page
2026-09-08 fix(landing): restore full page markup and GLB toggle with external loader
    - restored truncated index.html to full 3668-line page
    - replaced broken CDN GLTFLoader with local glb-loader.js
    - toggle uses window._loadGLB() after viewer init
    - no more THREE access at load time
2026-09-08 feat(sim): task 6 - thermal heatmap canvas + swine arena FOV, ironbow colormap grids (TDD GREEN)
2026-09-08 feat(sim): task 8 - hardware monitor, chaos panel, OTA dialog, accessible top nav (TDD GREEN; always-visible toggle, chaos sliders wired to node, sag override)
2026-09-08 feat(sim): task 10 - cockpit entry point, live 4Hz sim loop, README + build hygiene (TDD GREEN)
2026-09-08 docs(sim): session-state handoff — all sandbox tasks committed, verification evidence, open follow-ups
2026-09-08 fix: GLB camera too close + EAS prebuild missing android/gradlew
2026-09-08 feat(sim): pipeline trace + scenario runner - causal loop proven offline (sick pig -> fever -> CLUSTER -> CRITICAL); cough-count-led classifier (TDD GREEN)
2026-09-08 fix: GLB decoder byteOffset — add bufferData.byteOffset for ArrayBuffer-relative TypedArray constructors
2026-09-08 feat(sim): cockpit AI panels - barn cattle + classifier readout + pipeline trace + scenario runner wired to live env->node loop (TDD GREEN)
2026-09-08 fix: GLB decoder — copy bytes to independent ArrayBuffer + add diagnostic logging
2026-09-08 fix: GLB viewer — better camera framing, reset view resets zoom for both modes, wider zoom range
2026-09-08 docs: full-capstone emulation plan - grounded in measured live readouts (bridge crash-loop, PB schema, firmware topics)
2026-09-08 feat(sim): grounded world model - real live herd (pig-001..004), open-air factors, entropy events, contagion, scene editing (TDD GREEN)
2026-09-08 fix: GLB viewer — 5x scale, minDistance 0.4 for extreme close-up zoom, closer default camera
2026-09-08 feat(sim): sensor farm - placeable/replaceable esp32 nodes with coverage + RSSI (TDD GREEN)
2026-09-08 feat(sim): backend inspector probes - tri-state liveness vs real deployment, mosquitto-down root-cause synthesis (TDD GREEN)
2026-09-08 feat(sim): scene editor + env console + backend inspector wired to real herd and farm (TDD GREEN)
2026-09-08 docs: mark full-capstone emulation phase complete - stages A-D committed, 158/158 tests
2026-09-08 docs: mark all stages complete in full-capstone emulation plan
2026-09-08 fix: GLB minDistance 0.08 — 5x closer zoom for extreme detail inspection
2026-09-08 simulator v3.1: SoundTalks respiration health, telemetry retention, sim clock + rain (TDD 188 green)
    - SoundTalks engine (TDD): rolling 24-bin sim day, RDI + ReHS bands
    (GREEN>60/YELLOW 40-59/RED<40, real semantics), alarm = RED || trend,
    auto-baseline, calibrateNow from day total, sensitivity 0.25-4.
    - StorageRing in sensorFarm (TDD): default 7 sim-day retention (2520 s),
    20k record capacity, age-then-oldest eviction on ingest, estBytes from
    retained JSON payloads; farm exposes storageStats + retentionSeconds.
    - BarnEnvironment v3.1: setClock(h,m) phase-only, timeOfDaySec/label,
    rain cooling + ventilation factor; ambient includes rain.
    - App wiring: SoundTalks fed from the same co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
2026-09-08 docs: live-capture + ML-pipeline master plan, capture guide, image-prompt pack, SVG diagrams
    - Master plan (docs/plans/2026-09-08-live-capture-ml-pipeline.md): 4 phases —
    A live deploy (Pi baseline, node bring-up, 4/4 data-plane probes), B capture
    (audio/labels/weather corpus, 7-day retention matching StorageRing, vet
    truth chain, hygiene flags), C training (baseline vs CNN-LSTM, 22 ms edge
    KPI, honest gate: <2wk labels ships the pipeline not the model), 1-month
    timeline, risks, 6 open questions.
    - Capture guide: daily checklist, field glossary, append-only hygiene,
    export script (expected ~160k rows/14d), failure playbook.
    - ai-image-prompts.md: 4 ready-to-run image prompts +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
2026-09-29 feat(pi): ESP32-S3-only audio; put the Pi edge stack under version control
    The Pi edge application (thermal-pi, bridge, cctv, ops scripts, systemd units)
    had never been committed - 0 tracked files - so every card<->repo move was
    manual and drift accumulated silently. This commits the cleaned state.
    Audio: the ESP32-S3 barn mic (s3-mic-01) is now the only source.
    The direct-wired INMP441 on the 40-pin header was removed. It depended on
    dtoverlay=googlevoicehat-soundcard, which is for the Google Voice HAT and
    needs a physical audio codec this board does not have. arecord returned a
    registered card that produced bit-exact zeros: all 1,920,000 samples across
    the four recorded WAVs were exactly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
2026-09-29 canon: rewrite CANON.md + AGENTS.md, repoint CI, freeze stale trees
    The repo had drifted to the point where CI, deploy, and the docs all pointed
    at different, contradictory places. This makes one file authoritative and
    enforces it.
    CI (.github/workflows/ci.yml) — every job used `working-directory:
    mobile_app` and `firmware`, the STALE Firebase-era copies at the repo root.
    CI was building code nothing ships, and after root mobile_app/ was deleted it
    would simply have failed. Repointed at the v3 tree, and added:
    - path-guard: fails the build if mobile_app/, landing_page/,
    firebase.json, .firebaserc, firebase_config/, or a nested workflow file
    reappears at the repo root
    - backend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
2026-09-29 feat(pi): make the Pi a pipeline node; close the two-island gap with a sync worker
    The capstone's two halves never touched. The Pi read the MLX90640, drew a
    dashboard, and stopped. Every other node published to MQTT, but the Pi
    published nothing, so its thermal data never reached PocketBase and the phone
    app (which reads the laptop's database) never saw it. That is why this felt
    broken while every individual service reported green.
    thermal_publish.py — the Pi now publishes on the same wire contract as every
    other node, as `pi-thermal-01`:
    pig/pi-thermal-01/telemetry every 10 s, only after 3 valid frames
    pig/pi-thermal-01/alerts latched, once per fever episode
    pig/pi-thermal-0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
2026-09-29 chore: actually wire the secret scanner via core.hooksPath
    The scanner script worked when invoked by hand but was never invoked BY GIT.
    core.hooksPath was unset and husky was not installed (node_modules had been
    reclaimed), so .husky/pre-commit was inert. Proven by planting a Firebase API
    key and committing it successfully.
    Set core.hooksPath=.husky — the husky v9 layout needs no npm install, so the
    guard cannot be silently disabled by an absent node_modules. Re-tested: a
    planted key is now refused, a clean file still commits. The scanner then
    correctly blocked this very commit because the AGENTS.md example contained a
    key-shaped literal; reworded.
    AGENTS.md now records that this setting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
2026-09-29 security: purge the admin123 default that shipped inside the mobile app
    The earlier secret pass fixed the backend but missed three live copies of the
    PocketBase admin password, one of which was being distributed to end users:
    - frontend/mobile_app/src/utils/pocketbase.ts
    `process.env.EXPO_PUBLIC_PB_PASSWORD || 'admin123'` — this string is bundled
    into the APK, so every install carried the database admin password. Now
    defaults to empty and points at user auth for production.
    - frontend/mobile_app/eas.json — EXPO_PUBLIC_PB_PASSWORD: "admin123" in both
    the preview and internal-distribution build profiles. Blanked; supply it at
    build time.
    - deploy/docker/{docker-compose.yml, dock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
2026-09-30 feat(security): read-only telemetry proxy; stop publishing admin creds
    The public dashboard could not reach a laptop-bound PocketBase, and any
    attempt to fix that by exposing PocketBase directly would have published
    /api/admins plus the open listRules to the internet. This adds a narrow
    read-only path instead.
    - backend/workers/readonly_pb_proxy.py: stdlib-only proxy. GET/HEAD only;
    telemetry/alerts/pigs/devices allowlist; /api/admins never proxied;
    per-field response allowlist so new PocketBase columns cannot leak;
    per-IP rate limit; requires X-PigPulse-Key.
    - frontend/mobile_app/api/telemetry.js: serverless bridge holding the proxy
    URL and key as env secrets. Rebuilds the query fr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
2026-09-30 fix(gateway,deploy,docs): separate admin surface; disarm stale deploy path
    Admin is no longer reachable through the public gateway. PocketBase serves
    its admin UI under /_/, and the catch-all `location /` proxied to it, so the
    admin panel rode the same path as the API. /_/ and /admin/ are now loopback
    only; admin is reachable directly at http://127.0.0.1:8090/_/.
    The repo's deploy/openresty/conf/nginx.conf had diverged completely from the
    live file (repo used $pb_upstream vars pointing at 172.18.0.1; live uses
    `upstream` blocks on 127.0.0.1). Anyone editing the repo copy changed
    nothing. It is now a verbatim copy of the live config.
    Also:
    - deploy-landing.sh pointed at the FROZEN root land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
2026-09-30 chore(repo): quarantine frozen trees into legacy/, rewrite smoke battery
    The two frozen trees sat at the repo root with filenames that look live
    (`firmware/platformio.ini`, `landing_page/index.html`). That is not a
    hypothetical hazard: earlier today a repo copy of the OpenResty config was
    read as the live one, and the two had diverged into different architectures,
    which took the API gateway down. Both now live under legacy/ behind one
    README explaining what they are and why they must not be built. Moves were
    made with git mv, so history is preserved as renames.
    - legacy/README.md: one place explaining both trees, the D0WD decommission,
    and the incompatible `pig/telemetry/{x}` topic scheme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
2026-09-30 docs(canon): fix stale section cross-references
    The uplink section was inserted as 2.4, pushing hardware inventory to 2.5,
    but three references in the open-items table still pointed at 2.5. Fixed to
    2.4. All §2.x references now resolve to a real section.
2026-09-30 fix(thermal): make a dead MLX90640 visible instead of silent
    The thermal feed stopped and left no evidence anywhere. _loop() retried
    init() every 10 seconds forever and swallowed both the init failure and the
    read failure, so systemd reported "active", the dashboard showed a bare
    "Sensor not ready", and the reason existed only in a global reachable over
    HTTP. That is what made "it was working before" undiagnosable.
    _log() is rate-limited: the first occurrence always logs, then an identical
    message at most once a minute with a repeat count, so a permanently dead
    sensor cannot flood the journal. Three messages now reach it:
    - init failure, with the wiring checklist and the expected 0x33 ACK i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
2026-09-30 feat(pi): one-time remote-access setup (browser terminal over the AP)
    The Pi is headless with no desktop, so the only ways in are SSH and the
    thermal dashboard. This installs ttyd and binds it to the AP address so the
    Pi can be operated from a phone or laptop browser after joining PigPulse,
    without a GUI or a second monitor.
    Deliberately NOT installing LXDE/XFCE: a desktop on a 4 GB Pi in a hot barn
    costs RAM, CPU and SD writes, and can destabilise a working headless sensor
    node. The web terminal plus the existing dashboard cover the same need.
    The script refuses to run without internet, because the PigPulse AP has no WAN
    and apt cannot work after joining it. That ordering is the whole rea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
2026-10-29 feat(firmware): combined mic+SHT45 firmware, audit trail & restore register (Oct 13-19)
    - known-good-20261019-143307-mic-sht45: frozen functional baseline
    (pigpulse-mic-sht45-20261019), sha256-verified; CRC-valid SHT readings
    (34.09C/65.07%) + WiFi/MQTT/TCP connected with varied mic levels
    - SHT/I2C investigation Oct 19: GPIO8/9 unusable as I2C (BUS BUSY, no external
    pull-ups, 8<->9 coupling suspected); verified working buses on GPIO1/2 and
    GPIO12/13 (external pull-ups present); SHT not installed at capture time
    - MIC_AUDIT_20261017 + pad-register watch v10: cross-clocking ruled out by A/B
    (neither 5/4 nor 4/5 produces audio); fault zone narrowed to mic/electrical
    - KNOWN_GOOD.md: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
2026-10-29 feat(cctv): Tapo record/offload tooling, router mode, MJPEG latency fix (Oct 17-21)
    - tapo_record_setup.py: env-driven audit/arm-24-7-circular/verify/list/format
    (format gated, typed YES); TAPO_USER/PASS/CLOUD_PASS/AUTH_MODE
    - tapo_clip_backup.py: idempotent SD-to-laptop offload (skip-by-filename,
    temp+rename, retention prune, free-space guard, credential no-op)
    - pigpulse-tapo-backup.service/timer: laptop hourly unit, Persistent, enabled
    - router mode: pigpulse-router.service + nftables NAT (upstream-agnostic,
    armed and inert; wlan0 excluded from masquerade) + dnsmasq gateway/DNS opts
    - tapo_mjpeg_server.py: per-client latest-frame queue (size 2, drop-oldest),
    writer thread, SO_SNDT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
2026-10-29 feat(backend): admin console rework, bridge/cloud-sync hardening, thermal ops tooling (Oct 2026)
    - thermal-pi admin console: reworked pages (code/data/diagnostics/index/
    sensors/system + console.css/js), fusion.html, index.html
    - web_server.py + tls_server.py: TLS server + admin surface updates; tls.crt
    refresh
    - admin_console.py, mlx_reader.py: sensor/admin updates
    - local_bridge.py + cloud_sync.py: bridge and sync-worker hardening; bridge/pb
    systemd unit updates; workers/tests/ regression suite
    - scripts: add_thermal_fields.py (idempotent schema+SQLite applier),
    thermal_doctor.py (I2C bus probe + auto-fix), ci_preflight.py, monitor.py
    - thermal-pi/scripts: RELIABILITY_20261017, tes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
2026-10-29 feat(mobile): PocketBase utils hardening, telemetry-time, edge-impulse tab + tests (Oct 2026)
    - utils/pocketbase*.ts, setupStore: hardened data/auth/session handling
    - telemetry-time.ts (new): timestamp alignment helpers for sensor streams
    - edge-impulse.tsx: revamp; setup.tsx / index / settings / thermal screen updates
    - TemperatureDisplay + usePocketbaseRealtime: display + realtime hook fixes
    - __tests__: unit tests for utils (Jest)
    - note: legacy Firebase config still shows the rules backup (kept frozen by design)
2026-10-29 canon: full reconciliation 2026-10-29 — R8, sensor-fusion study, branch/archive policy
    - CANON.md: R8 Confirm-and-Archive rule (firmware -> KNOWN_GOOD.md, PB ->
    timestamped data.db copy, configs -> -bak files, each with measured proof)
    - §2.5 hardware truth: ESP32-S3 USB OK (2026-10-13); MLX90640 intermittent
    but working; GY-SHT45 owned/unconnected; Tapo = C200C w/ ~8 pointer
    - §2.7 sensor fusion (peer-reviewed provenance): thermal SR FORBIDDEN for
    measurement; 1-mic localization impossible; audio-visual cough attribution
    (Chae 2024, Sensors 24(22):7232, 95%) is the strongest fusion path; Pi 4B
    NCNN ceiling 2-3 FPS; pig ID w/o markers unsolved
    - §3.2 directory truth: training_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
2026-10-29 chore(gitignore): keep 100MB+ enclosure zip archives out of git
2026-10-29 docs: session rollout manifest — elephant/goldfish track map (2026-10-29)
    - T0 canon-keeper (elephant) + T1-T6 goldfish worker tracks
    - global rules: device readouts, R8, review gates, dir discipline
    - day-1 order: T2 backend/sync unblock ∥ T3 RTSP-audio verification
    - kickoff prompts per track for fresh sessions
2026-10-30 docs: full skill system guide — trigger conditions, cheat sheet, architecture (2026-10-30)
2026-11-02 feat(apps): monitor-first app, anonymous research log, Pi view parity
    Track T5. The live barn state is now the app's front door; the animal
    roster becomes a secondary, anonymous research log.
    Mobile app
    - Tabs are monitor / events / settings; "/" resolves to the live Monitor.
    - Monitor shows CCTV, the Pi's bodyTemp tile, a barn-mic dBFS meter derived
    from the firmware's own FULL_SCALE (8388608), and per-device link chips.
    - Camera state is tri-state (connecting/live/failed). A frame must actually
    decode before anything paints green -- the Pi's self-signed cert makes a
    silent failure the expected native case, so it is detected rather than
    hidden: <img> load/error posts back over post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
2026-11-02 feat(backend): 16 kHz audio normalizer + cough clip extractor, env-ify RTSP creds (T3)
    Tapo C200 carries A-law 8 kHz mono audio inside its RTSP stream. This adds
    the offline processing half of Track T3 and moves the live credentials out
    of the source.
    - backend/processing/audio/normalize.py: ffmpeg-based normalizer producing a
    16 kHz mono s16 WAV from a container, raw PCM, or an rtsp:// source.
    --probe reports the source format; --selftest is offline.
    - backend/processing/audio/extract_clips.py: numpy energy VAD with an
    adaptive noise-floor threshold plus a cough heuristic (duration, crest,
    rise, HF ratio) writing a JSON index and per-clip WAVs. --selftest is
    offline and injects a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
2026-11-03 feat(thermal-pi): live barn ambient (SHT45) card + /ambient endpoint
    The GY-SHT45 rides on the ESP32-S3 (s3-mic-01) and its temperature/humidity
    travel inside the existing pig/+/telemetry stream (only while the read is
    fresh; a retained LWT marks the board down). The Pi observes over MQTT and
    never polls — TCP :9090 is single-client and a probe would evict the live
    mic stream.
    - ambient_ingest.py: last-known ambient values + age clock; six states
    (mqtt-offline / no-data / esp-offline / sht-missing / stale / live) that
    keep "SHT45 silent" apart from "board offline". 11 unittests feed
    _on_message directly — no broker, no hardware.
    - web_server.py: GET /ambient (JSON snapshot), one /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
2026-11-03 fix(thermal-pi): ambient state follows last ambient key, not last message
    First live minutes on the Pi exposed the bug: /ambient reported
    "sht-missing" while holding fresh values (33.38 C / 72.57 %, 1.3 s old),
    because the state machine read whether the LATEST message carried ambient
    keys. Measured on the wire: the ESP attaches the keys to only some of its
    ~1 s telemetry messages (bursts of two, then one or two keyless) — so
    "latest message had no keys" happens constantly on a healthy sensor.
    State now keys off how long ago the last ambient key arrived:
    live last ambient key <= LIVE_S (15 s)
    stale last ambient key within OFFLINE_S (120 s)
    sht-missing no ambient ke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
2026-11-03 docs: align canon + external context with 2026-11-03 measurements
    - CANON §2.6 corrected: PB 0.22.20 DOES execute pending old-style `.js`
    migrations — four measured checks (sandbox probe; real humidity migration
    on a Pi-state snapshot; the live Pi applying 1798100000 at service start
    with a PocketBase-stamped _migrations row; laptop applying it at its
    04:31 boot). The still-true half is preserved (ALTER TABLE alone is
    ignored; per-instance pb_migrations dirs; never rename).
    - CANON hardware + §2.7: GY-SHT45 was "owned, unconnected, untested" — now
    connected and reporting (~33-34 °C / ~72 % RH in the s3-mic-01 telemetry
    bursts, live on /ambient, stored in PocketBase). ESP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
2026-11-03 feat(apps): end-user/technician split, honest labeling, PB-mapped names (T5)
    - Web technician island gated to PocketBase admin only (AuthGuard
    requireAdmin); blocked screens get Back-to-app / admin sign-in /
    switch-account affordances (no dead ends).
    - Thermal honesty: "Thermal view" + Demo badge + "Simulated preview of the
    thermal camera"; HUD shows "SIMULATED PREVIEW / NO SENSOR STREAM" when no
    real frame arrives. Dead Pi-dashboard button removed.
    - Home: farm/pen names from setup; device rows labeled from PB devices.name
    (subscribeDeviceNames); hardcoded farm copy removed.
    - Demo pills exactly when demo data shows; enroll copy whole-pen; enrollPig
    writes schema-conforming pigs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
2026-11-03 feat(apps): live barn thermal — Pi console data at app quality (T5 phase 2)
    - pi-thermal client (utils/pi-thermal.ts): /data (768-pixel frame + stats),
    /ambient (SHT45), /esp/status (mic); base = EXPO_PUBLIC_PI_THERMAL_URL →
    farmer-saved PB host :8080 → none.
    - usePiThermal: console tier (2 s frame poll, 8 s freshness window) +
    PocketBase pi-thermal-01 stats tier (90 s window).
    - ThermalLiveView liveFrame: iron palette (console stop set), web smooth /
    native pixel grid, HOT/COLD markers, live HUD; demo path unchanged.
    - Thermal screen: three honest states (LIVE / LIVE STATS / DEMO SIMULATION),
    legend, stat cards, SHT45 + barn-mic cards — app theme tokens.
    - Home thermal car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
2026-11-03 feat(cctv): Pi-side RTSP 24/7 segment recorder; Tapo auth hardening; runbook corrections
    - rtsp_recorder.py: new Pi-side self-healing 24/7 recorder (video copy,
    audio pcm_alaw->AAC for MP4, staleness watchdog, floor-driven rotation,
    REC_*/TAPO_RTSP_* env, no secrets in units). Retry log: pcm_alaw inside
    MP4 was producing empty segments.
    - tapo_record_setup.py: TAPO_TRANSPORT env (tpap/klap/pytapo), TAPO_CLOUD_USER
    env, and no double-shoot fallback when a transport is forced (camera lockout
    discipline: 1 failed attempt today = still just 1).
    - tapo_mjpeg_server.py: stall watchdog (stuck-RTSP relay restart, tested live).
    - runbook: 2026-11-03 measured truths — bind account is the T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
2026-11-03 fix(cctv): rtsp_recorder fast-exit exponential backoff (camera unreachable => max 5-min drum beat, auto-reset on success)
2026-11-03 fix(cctv): recorder staleness path also backs off when a spawn never wrote data (no 15-s drum while the camera is down)
2026-11-03 feat(apps): deep-link-safe back nav, battery→Plugged, node roles (T5 refinement)
    - utils/navigation.ts: goBackOrHome() — back when history exists, else Home;
    applied to all six router.back() sites (thermal, feed×2, login, tabs/feed,
    tabs/edge-impulse). Deep links no longer dead-end the Back button.
    - Settings: battery display deferred (no battery hardware) → "Power: Plugged";
    node roles now "Pi 4B — thermal · CCTV · compute" / "ESP32-S3 — mic · ambient".
    - tabs/edge-impulse: removed dead no-op effect (pre-existing lint error).
    - Live console base is now baked RELATIVE (/pi) so one web build works from any
    origin (laptop harness or a phone on the LAN via spa_server's /pi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
2026-11-03 feat(apps): actual data sources first + desktop thermal layout (T5 phase 3)
    - Roster/Events/Settings subscribe to PocketBase in every state; demo constants
    only as an empty-fallback (DEMO pill then); admin included — no more mock branches.
    - Web island dashboard: generateMockData deleted — real pigs + latest telemetry
    (real herd average; per-pig temps "—" under whole-pen monitoring).
    - Events timestamps normalized via telemetryTime (seeds seconds / bridge ms) —
    no more 1970 dates on seeded alerts.
    - PB device names aligned to roles on both PocketBases:
    "ESP32-S3 — mic · ambient", "Pi 4B — thermal · CCTV · compute".
    - Thermal view: two-column desktop layout (canvas left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
2026-11-03 fix(deploy): app-route SPA fallbacks + run Vercel from the stage dir
    - landing vercel.json: /app/thermal, /app/login, /app/setup, /app/feed, /app/web*
    now fall back to /app/index.html — these were live 404s ("This page doesn't
    exist") while /app/tabs worked.
    - deploy-landing.sh: run `vercel deploy` from inside the staging dir; the old
    --cwd form let the CLI validate the repo-root vercel.json, whose deliberate
    `//` note newer Vercel schemas reject.
    - Deployed to production: pig-health-monitor.vercel.app/app now serves the
    phase-1..3 app (gate verified live: "Admins only"). Autodeploy had been failing
    since Oct 31 on a stale token; fresh login restores it.
2026-11-03 feat(deploy): live Pi thermal on the deployed site via the read-only tunnel
    - readonly_pb_proxy (laptop worker): new read-only /pi passthrough (endpoint
    allowlist: /data, /ambient, /esp/status, /health; key-gated; unverified TLS
    to the self-signed console). SAFE_FILTER now accepts quoted values —
    deviceId='x' filters were being rejected, silently killing the deployed
    stats tier.
    - mobile_app/api/pi.js: single-path serverless bridge /api/pi?ep=<endpoint>
    → Tailscale Funnel → laptop proxy → Pi console (GET/HEAD only; key stays
    server-side).
    - pi-thermal.ts: web fallback base '/api/pi' + query-style fetch for the
    single-path bridge (LAN bases keep plain subpaths).
    Deploye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
2026-11-03 feat(apps): Live tab (Roster moves under it) + honest offline states (T5 phase 4)
    - Nav: Home · Events · Live · Settings (bottom + sidebar); Roster stays routable
    at /tabs/roster with a "Back to Live" affordance (explicit tab navigate).
    - New /tabs/live: shared LiveThermalPanel + Roster/Full-screen links + STREAMS
    note (CCTV not wired yet).
    - LiveThermalPanel extracted (used by Live tab + /thermal): four honest states —
    LIVE / LIVE STATS / LAST KNOWN (age-stamped) / OFFLINE. The fake demo heatmap
    no longer appears on live surfaces; Home mirrors Live/Stale/Offline badges.
    - usePiThermal exposes its clock (now) for age labels (render purity).
    - api/pi.js query-endpoint fix (single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
2026-11-03 feat(apps): CCTV tile + per-source sound controls on Live (T5 phase 5)
    - CCTV in the app as its own tile (no overlay — Master's call): snapshot frames
    via the read-only bridge (api/pi?ep=cctv → proxy _cctv_frame → Pi /cctv),
    polled ~2.5 s; honest offline states. Binary passthrough with correct types.
    - Sound card (sources kept separate): Barn mic (ESP32-S3) Listen/Mute toggle
    playing 3 s WAV chunks from /esp/record (web playback; native with the APK);
    honest disabled state while the mic stream is stale (Pi 503 forwarded).
    Camera sound (Tapo) labeled as a separate, not-yet-wired track.
    - readonly proxy: cctv (bounded JPEG extraction) + esp/record (bounded WAV,
    upstream statu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
2026-11-03 fix(thermal-pi): ambient card accepts ESP telemetry only
    Live failure on the Pi (2026-11-03, ESP unplugged): pi-thermal-01's ~1 Hz
    thermal telemetry ALSO carries a `temperature` key — the MLX90640's ambient
    estimate, not the SHT45 — so the watcher latched it and the dashboard showed
    "30.9 C" (camera estimate) on the card labelled "Barn ambient — SHT45",
    next to the SHT45's last humidity reading.
    Every ESP message — live telemetry and the retained LWT — carries the `mic`
    key; the Pi's thermal telemetry never does. That presence is now the gate:
    messages without it are ignored before any state is touched, so device,
    ages, mic flag and values all describe the ESP sensor node only. A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
2026-11-03 feat(backend): laptop-anchored timeline, thermal guard, Pi->cloud sync (T2)
    - bridge: time_anchor.py (NTP-laptop truth host, monotonic carry, persisted
    anchor) + thermal_guard.py (shared semantic-field guard) wired into
    local_bridge.py; deployed to the Pi and live
    - workers: cloud_sync.py era-offset correction at one shared sync point,
    dest stamps in integer seconds, guard reuse, historical thermal alerts
    suppressed; suite 18/18
    - systemd: new laptop user unit pigpulse-cloud-sync.service (60 s, no User=
    - 216/GROUP), enabled + active with Linger=yes
    - scripts: health_check.py follows the new topology (bridge checks Pi-only,
    laptop checks cloud-sync via user journal, round-trip Pi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
2026-11-03 docs(t2): track note addendum — PB rotations (3.5.1) + dest write lockdown (3.5.3)
    - 3.5.1 done on both PBs: admin password + auth-token secrets rotated;
    consumers updated (sync.env, Pi bridge.env); old creds dead, sync passes
    clean. Records the 0.22 lessons (legacy /api/admins endpoint, password
    PATCH invalidates caller token, grep|sha256sum newline trap).
    - 3.5.3 done (Option A): dest write rules locked, reads + pigs.create
    public; probe evidence recorded; codified in
    1798500000_updated_collections_lock_writes.js — which is deliberately
    untracked (bin/pb_migrations/ is ignored, never in history) so nobody
    'fixes' that later.
    - 3.5.4 Tapo pending on camera-side rotation; T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
2026-11-03 thermal-pi: wire radiometric correction chain + SHT45-anchored ambient into live feed
    ZoneFeverPipeline (radiometry.py, parallel track module) is now live in
    web_server's frame loop, replacing the legacy scalar compensator:
    - Ambient re-sourced: state==live SHT45 snapshot (ambient_ingest) else
    driver internal Ta fallback; ambientSrc key records which was used.
    Measured 2026-11-04: internal Ta 43.6 C vs SHT 31.1 C self-heat gap ->
    legacy comp over-pulled center by ~1.25 C. After: ambient 31.56,
    center 36.38 (over-pull removed).
    - Correction chain: drift compensation (frozen mode, clamp), per-pixel
    baseline, zone fever logic. eps_here=1.0 contract upheld - driver keeps
    emissivity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
2026-11-04 docs: CANON 2.7 — FOV variant expected D110 (unverified), pixel-footprint implications
    Per Master 2026-11-04: mounted sensor is supposed to be the 110x75 wide
    variant. No I2C readout exists for the variant, so it stays unverified
    until the physical FOV test. D55 numbers in the capability matrix
    annotated; D110 doubles the pixel footprint (~12x10 cm at 2 m).
2026-11-04 prep: YOLO pig detection + track-ID scaffold in cctv/ (not wired in)
    pig_detector.py: import-safe with no ML stack (Pi readout 2026-11-04:
    none installed), default-off via PIGPULSE_PIGDETECT, lazy ultralytics
    load, minimal centroid tracker so the detection->ID interface is settled
    before the CCTV feed is fixed. Wiring plan + capability ceiling (CANON
    2.7: YOLOv8n NCNN 2-3 FPS, Deep SORT-P 89.6% MOTA, no long-term re-ID,
    position-level fusion only) in the module docstring.
    Verified: smoke test passes on laptop and on the Pi (zero deps),
    backend CI byte-compile OK. IDs are session-local by design.
2026-11-04 fix(apps): analytics reads real PocketBase rows — delete the mock generator
    The web Analytics screen built its charts from generateMockData(): random
    temperatures, random sound and 20 invented alerts, under a pig-fever threshold
    legend on what is really a pen-temperature chart. Nothing on that screen was
    real, and there was no way for a viewer to tell.
    It now reads telemetry/alerts through pbList() and buckets the window:
    - scene temperature comes from `center` (the thermal guard zeroes
    `temperature`/`bodyTemp`, so the old read could only ever see 0)
    - sound is shown only where rms/peak > 0, and the copy no longer claims a
    16-bit range (measured 17k-978k)
    - an empty window says it is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
2026-11-04 fix(backend): read-path hardening + a Pi that survives being cabled differently
    Four defects on the public read path, each of which made the deployed app lie
    or go blind:
    1. Web pbList() called /api/collections/... which returns 404 in production.
    It now uses the /api/telemetry bridge; native stays direct-PocketBase.
    2. PocketBase requires quotes around string values
    (deviceId='pi-thermal-01'&&timestamp>=...). Both edges rejected them with
    400, so no query could be scoped to a device or a time window. The two
    validators are now provably equivalent: 0 disagreements over 103 probes, and
    the trailing-newline case is closed (\Z where JS uses a non-multiline $).
    3. The proxy's fie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
2026-11-04 chore(rig): runnable backend tests and an mDNS Pi host
    - `npm run test:backend` — the backend suite had no runner from the repo root,
    so its tests were only runnable by hand with the right cwd
    - diag:pi / health:pi used the hardcoded barn-AP address; they now default to
    ${PI_HOST:-raspberrypi.local} (override with PI_HOST=...) so they work
    whether the rig is on its own access point or cabled to a machine
    - mobile_app gains `npm run test:bridge` for the standalone Node bridge tests
2026-11-04 fix(apps): the theme choice persists, and the sound controls work on native
    THEME — reported as "switching to light mode doesn't change anything"
    ThemeProvider kept the choice in React state only. Nothing was written, so
    every reload reverted to the system scheme: a dark phone came back dark no
    matter what was selected. The root layout nests WebThemeProvider (which does
    persist) around ThemeProvider (which did not), and useTheme() resolves to the
    inner one — so the visible theme was the non-persistent one and the honest
    storage read stayed "auto".
    Now the used provider persists to the same keys the web island reads:
    localStorage on web (read synchronously, so the first paint is already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
2026-11-04 fix(backend): honest /cctv when the camera is absent; mDNS-first Pi lookup
    Two things measured today with the camera unpowered:
    1. The Pi's /cctv answered 200 OK with an EMPTY body and then sat there. A
    client cannot distinguish that from a slow camera, so the app's tile showed
    a spinner and every caller waited out its own timeout (measured 12 s, then
    nothing). It now waits up to five seconds for the camera's FIRST frame
    before promising a stream and otherwise answers 503 "no frame from the
    camera - it is not sending video". The upstream socket carries a 60 s
    streaming timeout, so the first-frame wait sets a short one; without that
    the deadline never fired and the route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
2026-11-05 feat(diag): rig_diag.py — operator-side health probe with simulated fault suite
    22 checks across five layers (network, console, host, data, public):
    first broken hop is named, every exit reports the readout that saw it.
    14 simulated fault tests; 97 backend tests passing.
2026-11-05 feat(soak): edge soak monitoring — capture, report, live view, thermal bench
    Tomorrow's ~24 h hardware soak must afterwards answer "how hot did it get,
    what disconnected, at which rates" with numbers, not anecdotes. This lands
    the full path: collector + report + live + bench, built elephant/goldfish
    style (three Google-model workers, one file each; elephant owned the
    contract, collector, deploy and real-data verification —
    docs/SESSION_ROLLOUT_20261105.md).
    - soak_collect.py + pigpulse-soak.service: continuous 10 s sampler on the
    Pi -> /home/pigpulse/soak/soak.db (WAL): CPU temp/freq/throttle, thermal +
    ambient state, ESP/MQTT health, PB rates, per-unit journal scan, events on
    sta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
2026-11-05 feat(sync): continuous barn-mic audio + one shared barn clock for thermal/CCTV/mic
    The deployed app audibly paused between audio clips and the three panels
    showed different barn moments. Both came from the same gap: sequential
    fetch-3s/play-3s audio at 48 kHz stereo (1.54 Mbit/s — wider than the
    barn→cloud leg measures at ~0.8 Mbit/s) and no shared notion of time.
    This wave carries a Pi-clock timestamp on every channel and renders all
    three surfaces against one client-side presentation lag, so the barn is
    always shown as one coherent (if slightly delayed) moment.
    - Pi web_server.py: /data → ts, /cctv → X-Frame-Ts, /esp/stream →
    X-Stream-Ts back-dated to the first-sample capture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
2026-11-06 fix(ci): repair the three red checks — npm ci, thermal-pi import, trufflehog
    All three failed identically on 07c3c9a before the sync work landed, so
    they are pre-existing, not regressions from 5ec975d.
    - mobile-app: `npm ci` dies with ERESOLVE — react-native 0.86.3 peers
    react ^19.2.3 while Expo SDK 57 pins 19.1.0. Install with
    --legacy-peer-deps; the lockfile stays authoritative and react is not
    bumped off the SDK's tested version.
    - backend: `python3 -c "` with an indented body raised IndentationError
    on line 2 — the YAML block keeps the extra indent. Use a quoted
    heredoc instead.
    - secrets: extra_args re-added --fail even though the action hard-codes
    it, so trufflehog a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
2026-11-06 fix(ci): second pass — numpy for the backend probe, Node globals for lint
    The first repair unblocked `npm ci` and the heredoc, so both jobs ran
    their real gates for the first time and failed on genuine issues:
    - backend: web_server.py imports pcm_downmix.py, which needs numpy —
    the probe only installed mlx9064x-driver. Install what the import
    chain actually needs.
    - mobile-app lint: every tracked .js/.mjs file in the app runs under
    Node (api/ functions, scripts/, api/__tests__, dev harnesses), so
    give the whole Node side the globals the api/ functions already had.
    Two genuinely dead locals go too: _layout.tsx's unused spacing /
    isDesktop chain, and pocketbase.ts's write-only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
